BlueJayRacing/22xt_kicad/01-main_board/main_board_peripheral_v3_1/export_3d/main_board_peripheral_v3_1.step

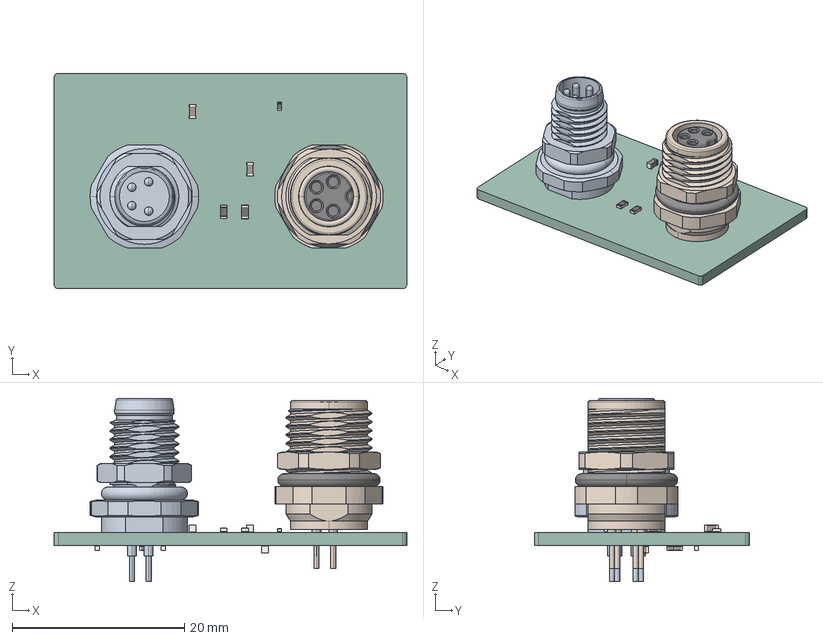
[picture p1: CAD file, 2026-02-27]
01-main_board/main_board_peripheral_v3_1/export_3d/main_board_peripheral_v3_1.step
41.0 x 25.0 x 21.3 mm
c-t4040014041-000-a-3d
R_0402_1005Metric
C_0603_1608Metric x 3
R_0603_1608Metric x 2
T4041017041-000
C_0402_1005Metric x 3
main_board_peripheral_v3_PCB
