BlueJayRacing/22xt_kicad/01-main_board/00-3dmodels/MYRBP500080W21RD.step

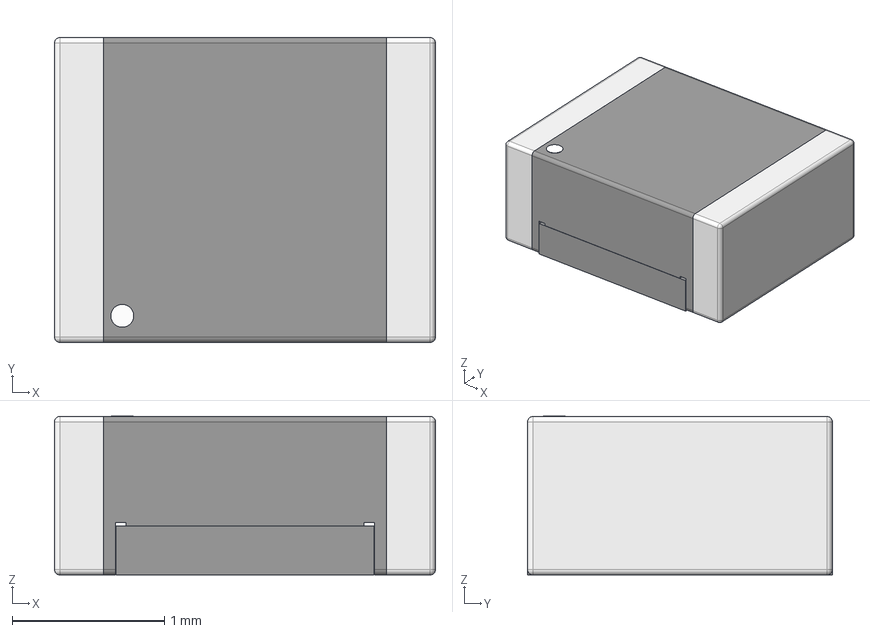
[picture p2: CAD file, 2026-03-13]
01-main_board/00-3dmodels/MYRBP500080W21RD.step
2.50 x 2.00 x 1.04 mm
substrate terminal
substrate
inductor terminal
inductor body
marking
