BlueJayRacing/22xt_kicad/02-wsg/00-footprints/USBLC6-2SC6.step

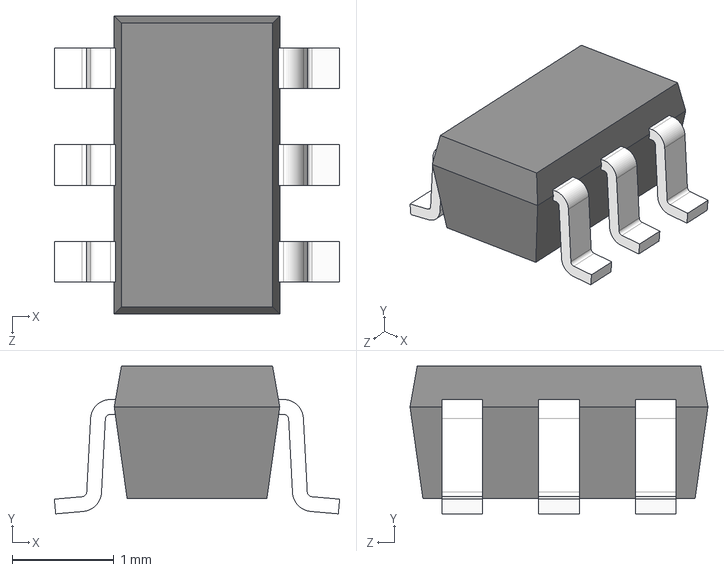
[picture p3: CAD file, 2025-12-18]
02-wsg/00-footprints/USBLC6-2SC6.step
2.80 x 1.45 x 2.92 mm
