BlueJayRacing/22xt_kicad/02-wsg/wsg_2025/symbols/ADC/ADS1120IPWR/ADS1120IPWR.step

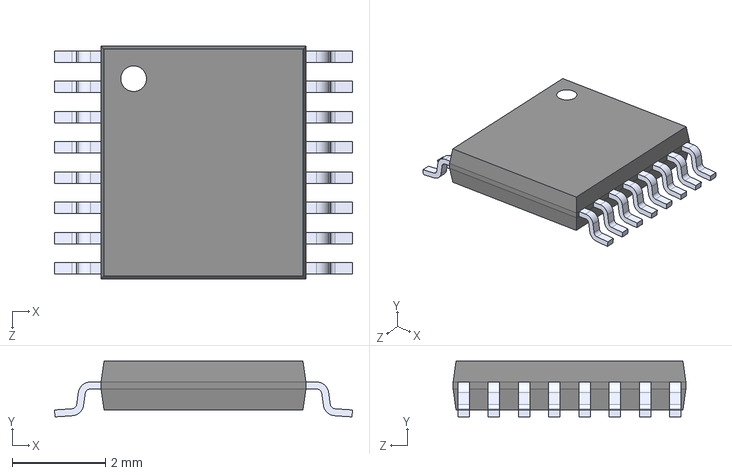
[picture p4: CAD file, 2025-12-19]
02-wsg/wsg_2025/symbols/ADC/ADS1120IPWR/ADS1120IPWR.step
6.40 x 1.20 x 5.00 mm
