BlueJayRacing/22xt_kicad/02-wsg/wsg_2025/symbols/battery module/PW0014A.stl

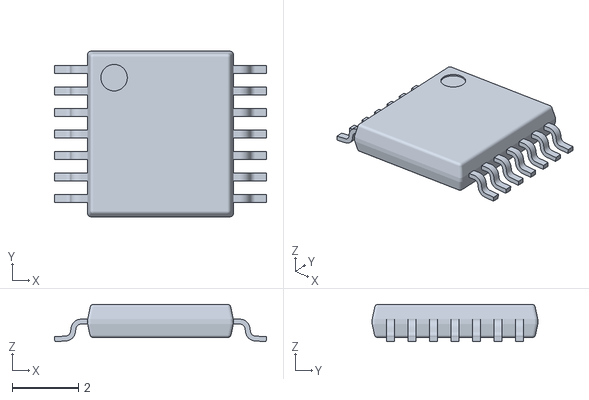
[picture p5: CAD file, 2025-12-18]
02-wsg/wsg_2025/symbols/battery module/PW0014A.stl
6.40 x 5.00 x 1.13
