BlueJayRacing/22xt_kicad/02-wsg/wsg_2025/symbols/DAC/RM_8_ADI.stl

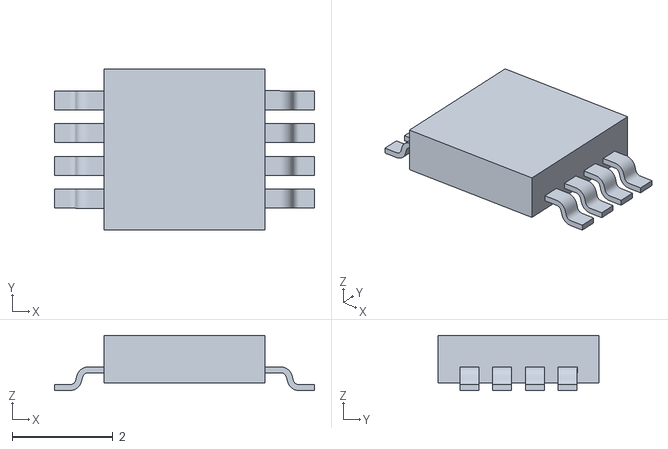
[picture p6: CAD file, 2025-12-18]
02-wsg/wsg_2025/symbols/DAC/RM_8_ADI.stl
5.16 x 3.20 x 1.10
