BlueJayRacing/22xt_kicad/02-wsg/wsg_2025/symbols/ESP32-C6/ESP32-C6.step

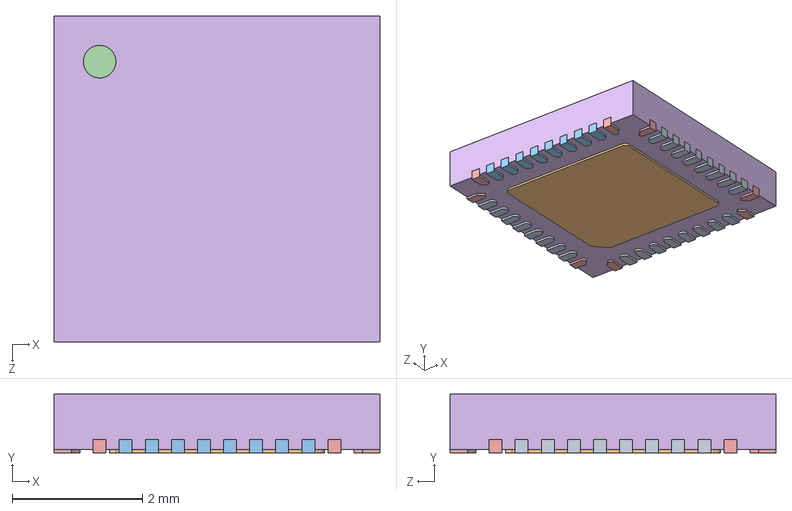
[picture p7: CAD file, 2025-12-18]
02-wsg/wsg_2025/symbols/ESP32-C6/ESP32-C6.step
5.00 x 0.9 x 5.00 mm
