BlueJayRacing/22xt_kicad/02-wsg/wsg_2025/symbols/in amp/DGK0008A.stl

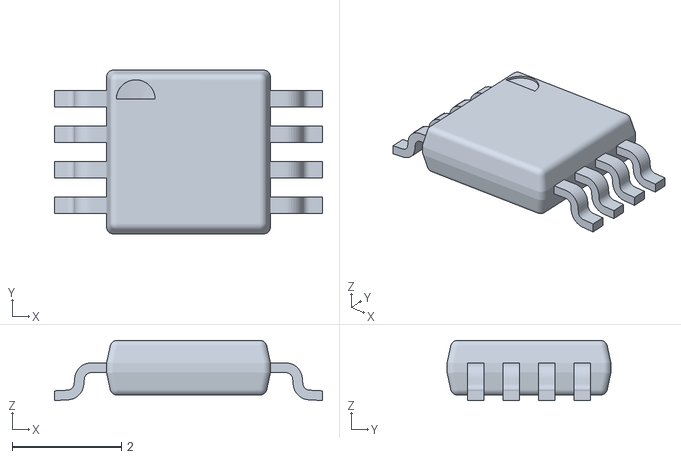
[picture p8: CAD file, 2025-12-18]
02-wsg/wsg_2025/symbols/in amp/DGK0008A.stl
4.90 x 3.00 x 1.10
