BlueJayRacing/22xt_kicad/02-wsg/wsg_2025/symbols/LDO 3.6 V/DBV0005A.stl

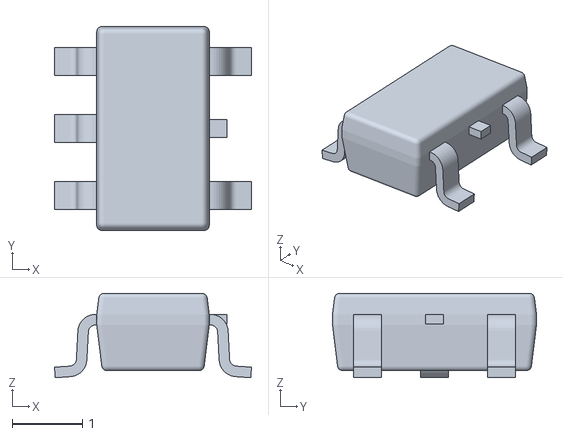
[picture p9: CAD file, 2025-12-18]
02-wsg/wsg_2025/symbols/LDO 3.6 V/DBV0005A.stl
2.80 x 2.90 x 1.20
