BlueJayRacing/22xt_kicad/02-wsg/wsg_2025/symbols/LT6658AHMSE_5_PBF/MSE_16_ADI.stl

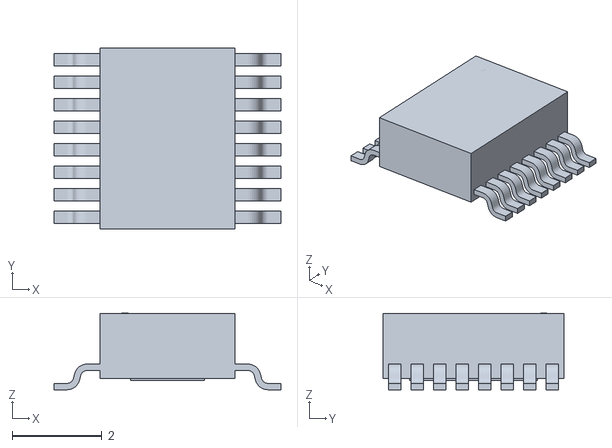
[picture p10: CAD file, 2025-12-18]
02-wsg/wsg_2025/symbols/LT6658AHMSE_5_PBF/MSE_16_ADI.stl
5.05 x 4.04 x 1.70
