BlueJayRacing/22xt_kicad/02-wsg/wsg_2025/symbols/voltage ref/F36-65.step

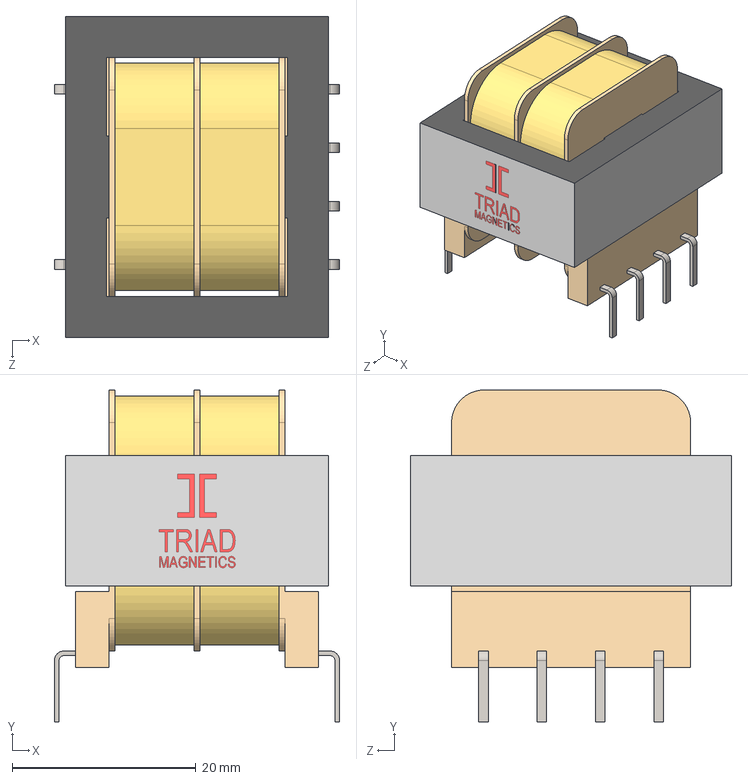
[picture p11: CAD file, 2025-12-18]
02-wsg/wsg_2025/symbols/voltage ref/F36-65.step
31.0 x 36.1 x 35.0 mm
