BlueJayRacing/22xt_kicad/04-dyno_daq/00-3dmodels/B2B-PH-SM4-TB.STEP

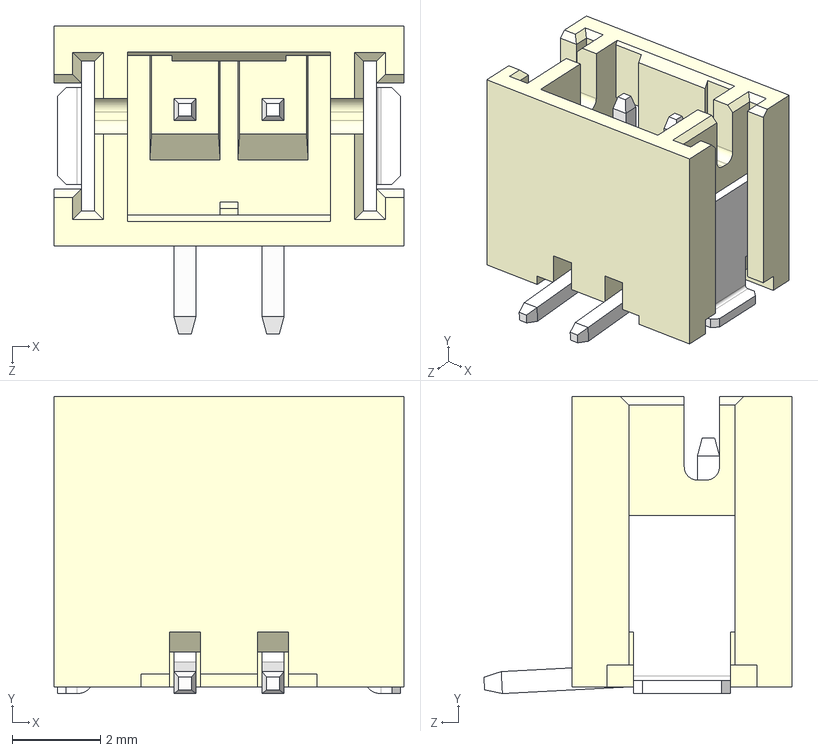
[picture p12: CAD file, 2025-11-25]
04-dyno_daq/00-3dmodels/B2B-PH-SM4-TB.STEP
7.95 x 6.75 x 7.00 mm
