BlueJayRacing/22xt_kicad/04-dyno_daq/TC_kent/jst_2pin.STEP

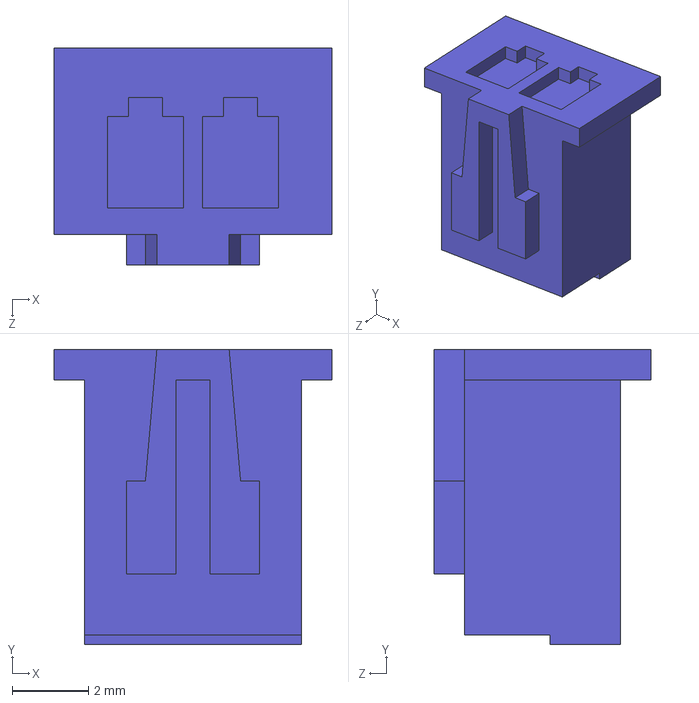
[picture p13: CAD file, 2025-11-25]
04-dyno_daq/TC_kent/jst_2pin.STEP
7.30 x 7.75 x 5.70 mm
