BlueJayRacing/22xt_kicad/04-dyno_daq/TC_kent/jst_4pin/B4B_PH_SM4_TB/B4B-PH-SM4-TB.STEP

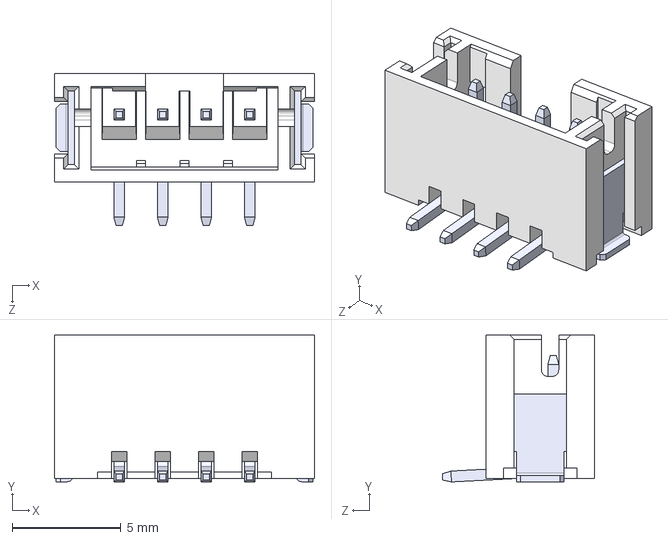
[picture p14: CAD file, 2025-11-25]
04-dyno_daq/TC_kent/jst_4pin/B4B_PH_SM4_TB/B4B-PH-SM4-TB.STEP
12.0 x 6.75 x 7.00 mm
