BlueJayRacing/22xt_kicad/04-dyno_daq/TC_kent/jst_4pin/S4B-XH-SM4-TB.STEP

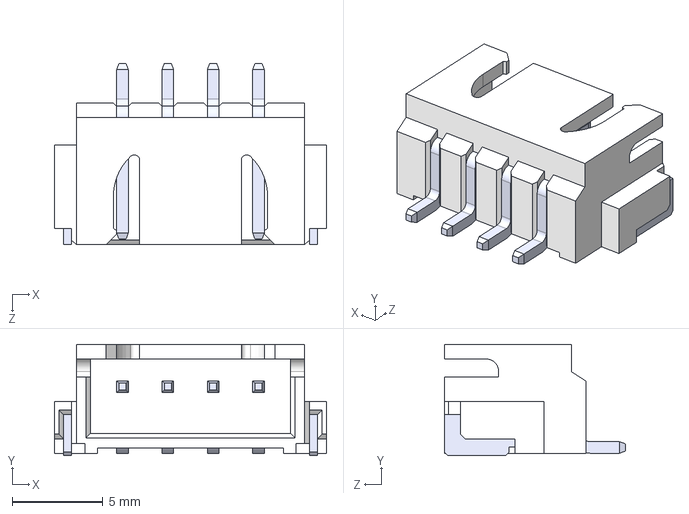
[picture p15: CAD file, 2025-11-25]
04-dyno_daq/TC_kent/jst_4pin/S4B-XH-SM4-TB.STEP
15.0 x 6.12 x 10.0 mm
SxB-XH-SM4-TB_4
pin^SxB-XH-SM4-TB Ass x 4
