BlueJayRacing/22xt_kicad/04-dyno_daq/THC_su/thermistor circuit.step

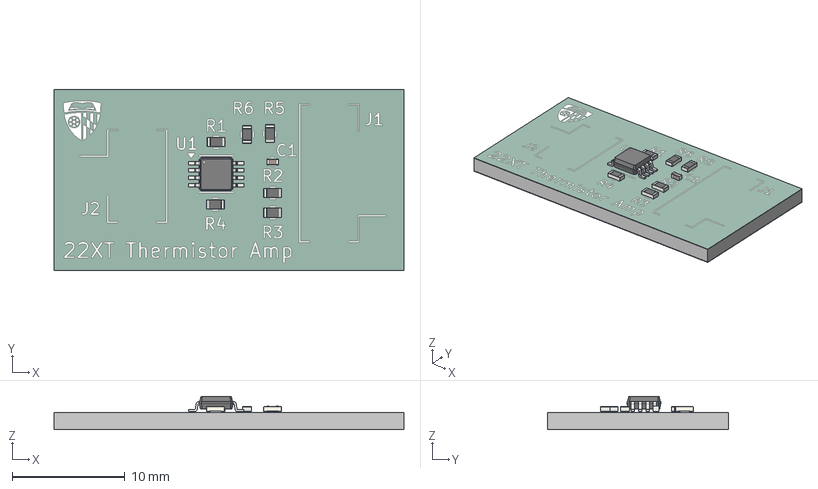
[picture p16: CAD file, 2025-12-20]
04-dyno_daq/THC_su/thermistor circuit.step
31.0 x 16.0 x 3.02 mm
R_0603_1608Metric x 6
VSSOP-8_3x3mm_P0.65mm
C_0402_1005Metric
thermistor circuit_silkscreen
thermistor circuit_soldermask
thermistor circuit_PCB
