BlueJayRacing/22xt_kicad/01-main_board/00-3dmodels/LSM115JE3_TR13--3DModel-STEP-510211.STEP

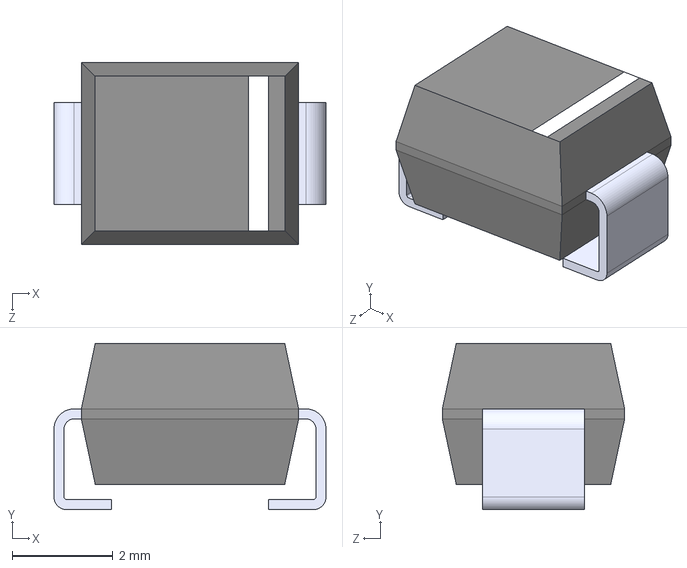
[picture p17: CAD file, 2026-02-10]
01-main_board/00-3dmodels/LSM115JE3_TR13--3DModel-STEP-510211.STEP
5.40 x 3.30 x 3.62 mm
