BlueJayRacing/22xt_kicad/02-wsg/00-3dmodels/usb4110-gf-a.stp

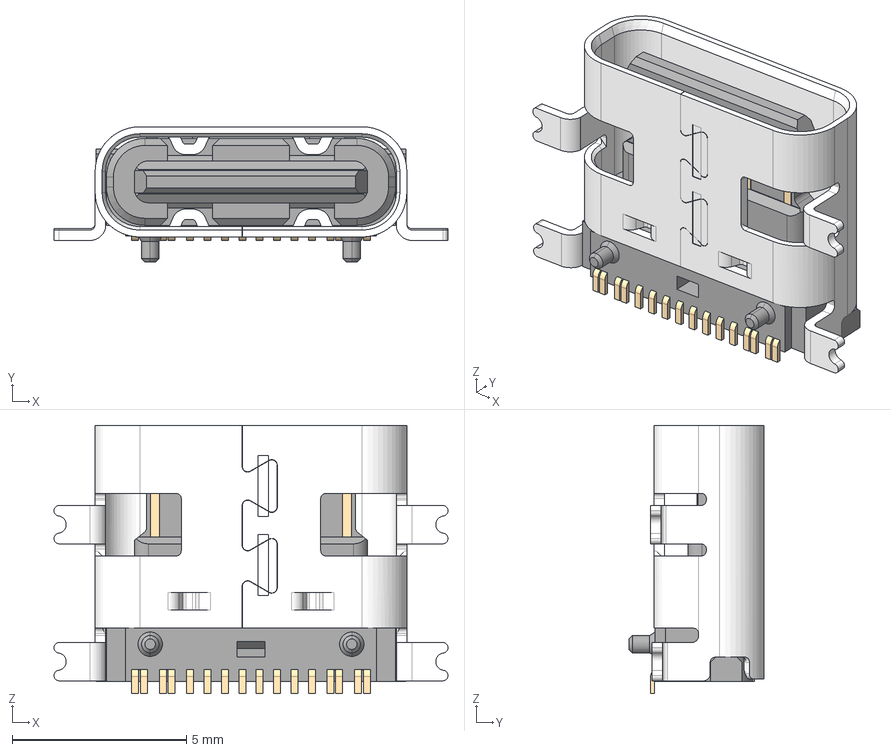
[picture p18: CAD file, 2026-01-05]
02-wsg/00-3dmodels/usb4110-gf-a.stp
11.3 x 3.89 x 7.70 mm
