BlueJayRacing/22xt_kicad/02-wsg/00-3dmodels/2450AT18B100E.step

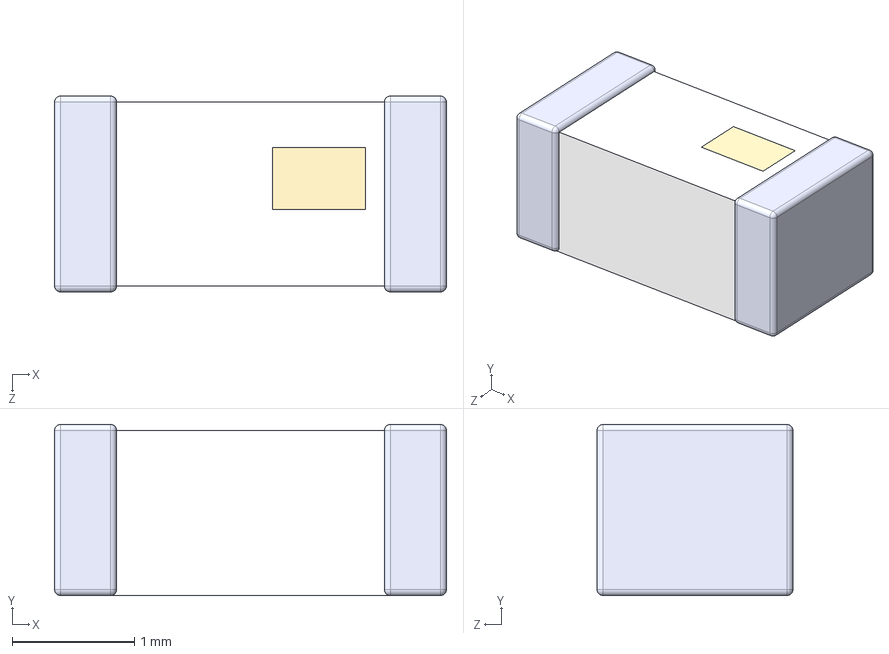
[picture p20: CAD file, 2025-12-18]
02-wsg/00-3dmodels/2450AT18B100E.step
3.20 x 1.40 x 1.60 mm
