BlueJayRacing/22xt_kicad/01-main_board/00-3dmodels/SOIC8-N_MC_MCH.step

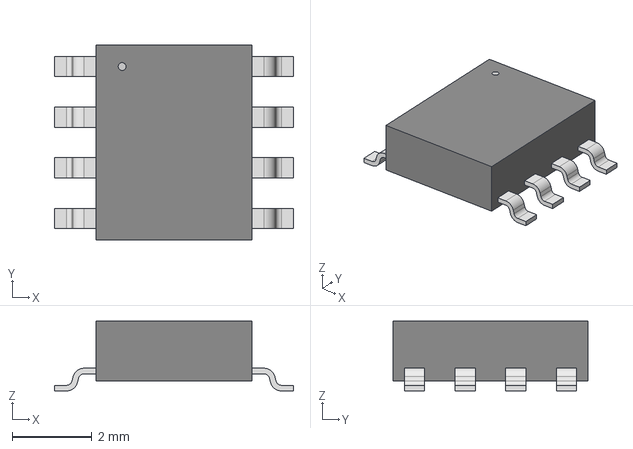
[picture p21: CAD file, 2026-02-10]
01-main_board/00-3dmodels/SOIC8-N_MC_MCH.step
5.99 x 4.90 x 1.75 mm
