BlueJayRacing/22xt_kicad/01-main_board/00-3dmodels/IND_TAIYO_NRS4012_TAY.step

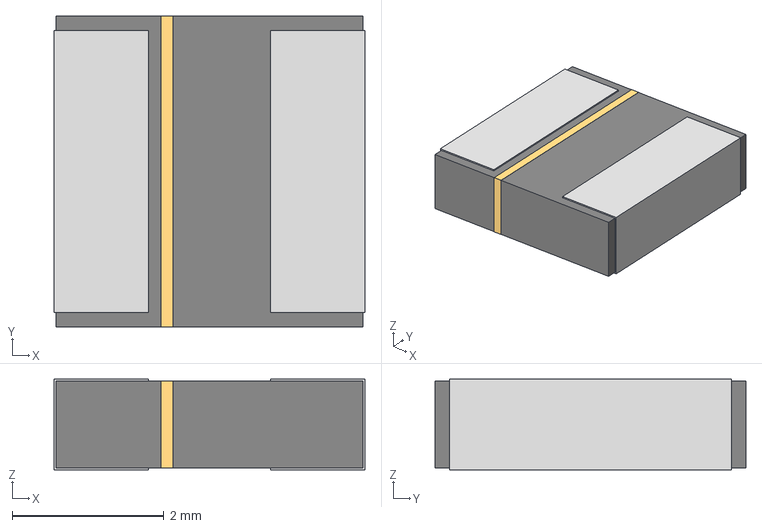
[picture p22: CAD file, 2026-02-10]
01-main_board/00-3dmodels/IND_TAIYO_NRS4012_TAY.step
4.09 x 4.09 x 1.19 mm
