BlueJayRacing/22xt_kicad/02-wsg/00-3dmodels/W25N04KVZEIR.stp

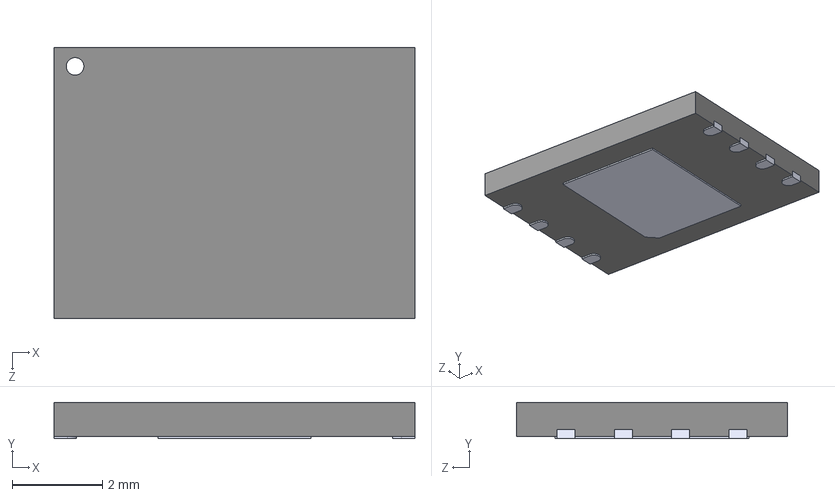
[picture p23: CAD file, 2025-12-18]
02-wsg/00-3dmodels/W25N04KVZEIR.stp
8.00 x 0.8 x 6.00 mm
