BlueJayRacing/22xt_kicad/01-main_board/00-3dmodels/TPSM83100SIUR.stp

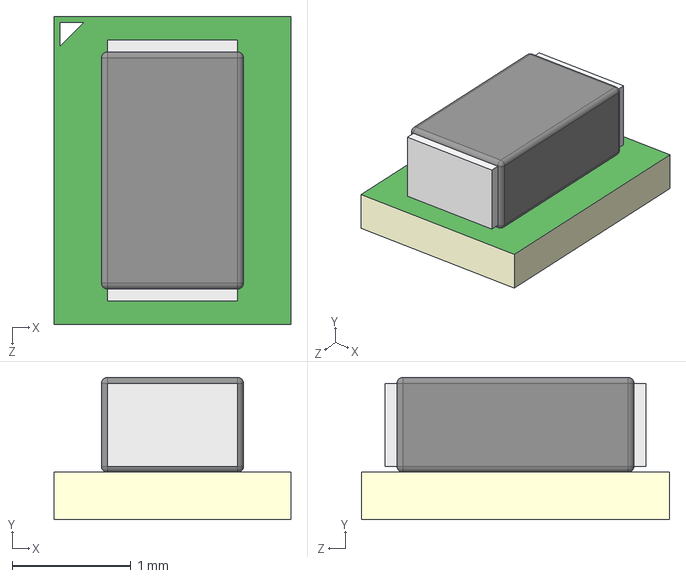
[picture p24: CAD file, 2026-02-09]
01-main_board/00-3dmodels/TPSM83100SIUR.stp
2.00 x 1.20 x 2.60 mm
