BlueJayRacing/22xt_kicad/02-wsg/00-3dmodels/ECS-.327-12.5-34B-TR.step

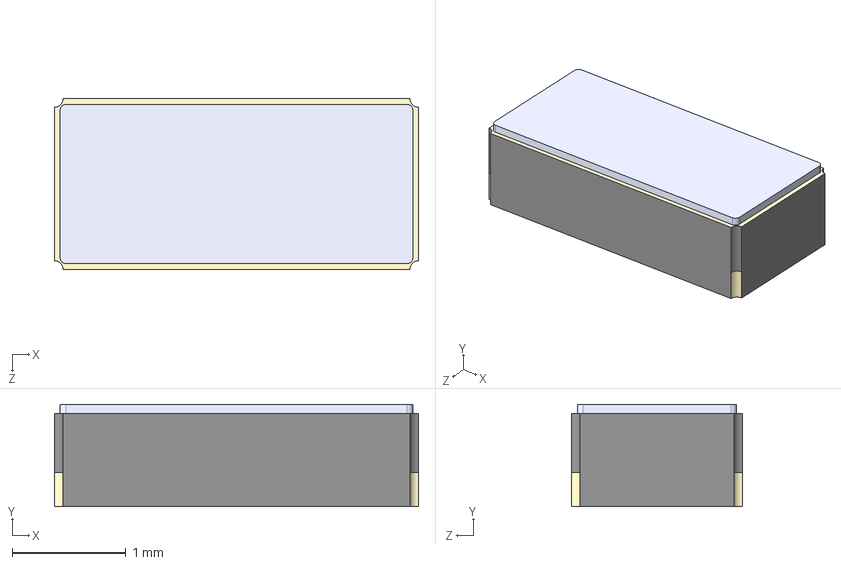
[picture p25: CAD file, 2025-12-18]
02-wsg/00-3dmodels/ECS-.327-12.5-34B-TR.step
3.20 x 0.9 x 1.50 mm
