BlueJayRacing/22xt_kicad/01-main_board/00-3dmodels/RC1206FR-0730KL.step

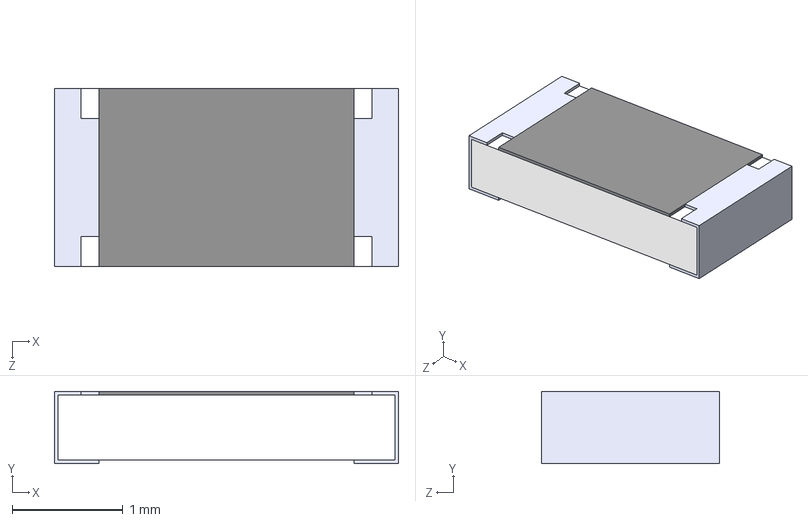
[picture p26: CAD file, 2026-02-09]
01-main_board/00-3dmodels/RC1206FR-0730KL.step
3.10 x 0.65 x 1.60 mm
