BlueJayRacing/22xt_kicad/02-wsg/00-3dmodels/ECS-400-10-37B2-CKY-TR.step

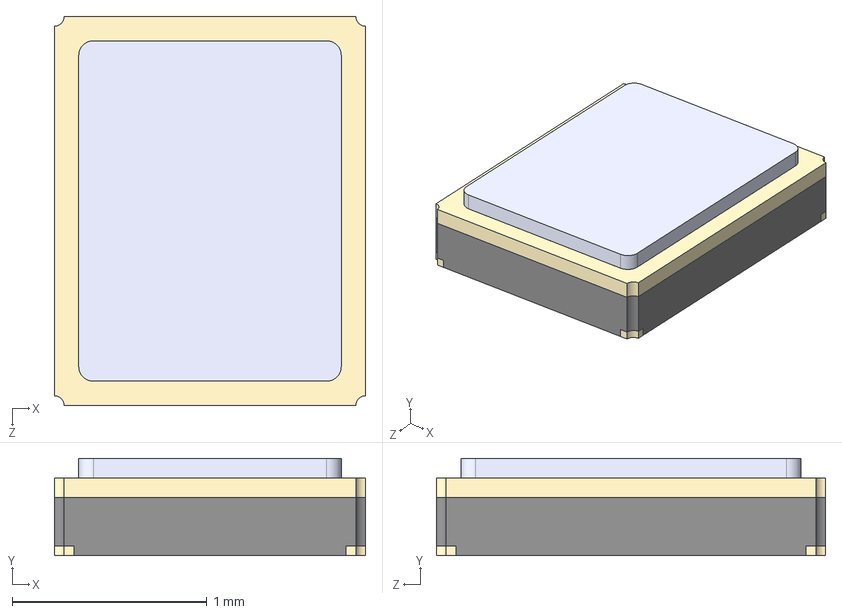
[picture p27: CAD file, 2025-12-18]
02-wsg/00-3dmodels/ECS-400-10-37B2-CKY-TR.step
1.60 x 0.5 x 2.00 mm
