BlueJayRacing/22xt_kicad/01-main_board/00-3dmodels/FH41-15S-0.5SH_05_.stp

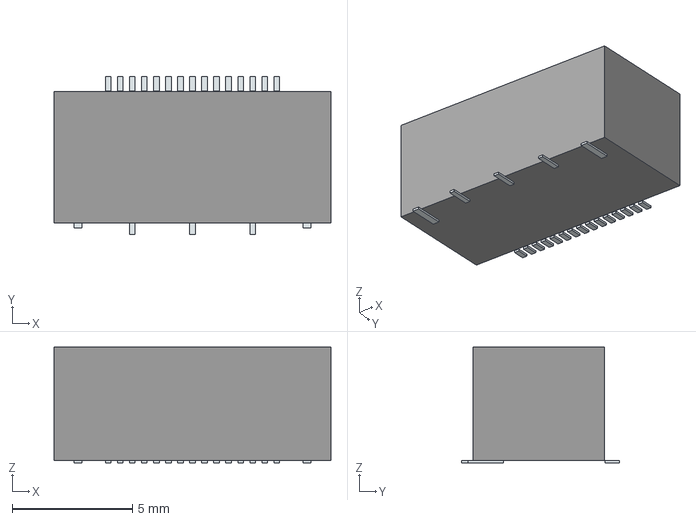
[picture p28: CAD file, 2026-02-09]
01-main_board/00-3dmodels/FH41-15S-0.5SH_05_.stp
11.5 x 6.54 x 4.80 mm
Pins
