BlueJayRacing/22xt_kicad/01-main_board/00-3dmodels/DF12NB(5.0)-20DP-0.5V(51).STEP

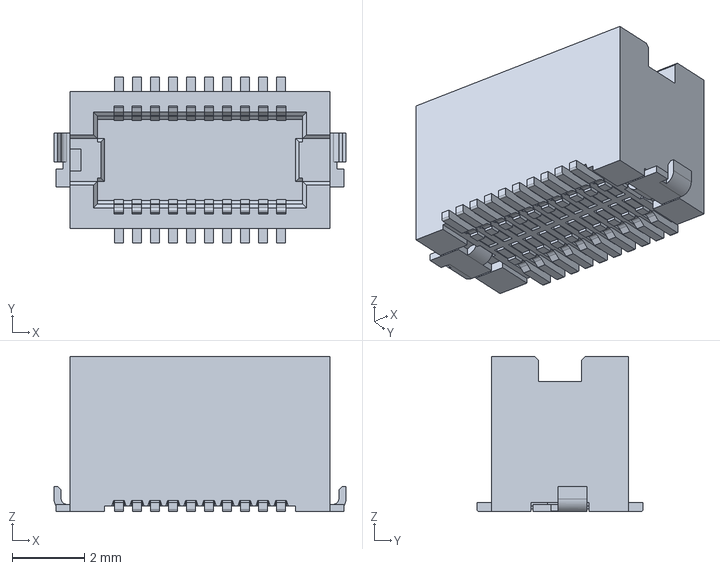
[picture p29: CAD file, 2026-01-04]
01-main_board/00-3dmodels/DF12NB(5.0)-20DP-0.5V(51).STEP
8.10 x 4.60 x 4.30 mm
