BlueJayRacing/22xt_kicad/01-main_board/00-3dmodels/DF12NB-20DS-0.5V.stp

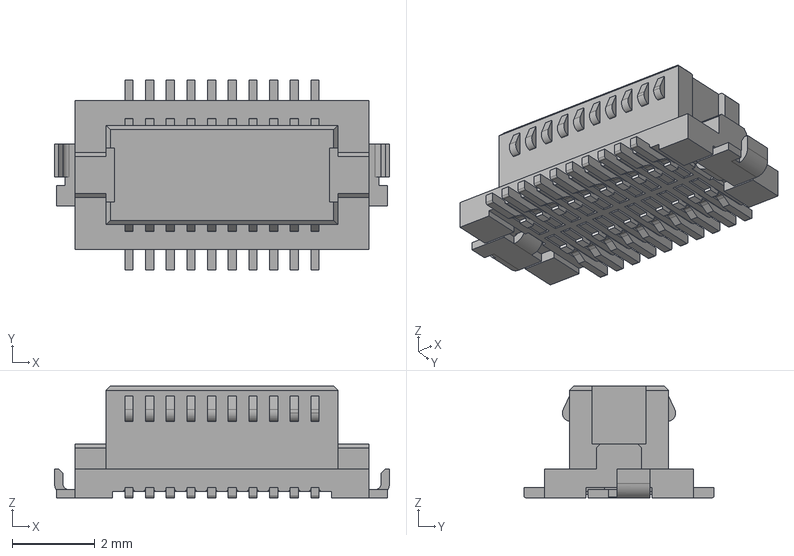
[picture p30: CAD file, 2026-01-04]
01-main_board/00-3dmodels/DF12NB-20DS-0.5V.stp
8.10 x 4.60 x 2.70 mm
