BlueJayRacing/22xt_kicad/01-main_board/00-3dmodels/TS3USB30EDGSR.stp

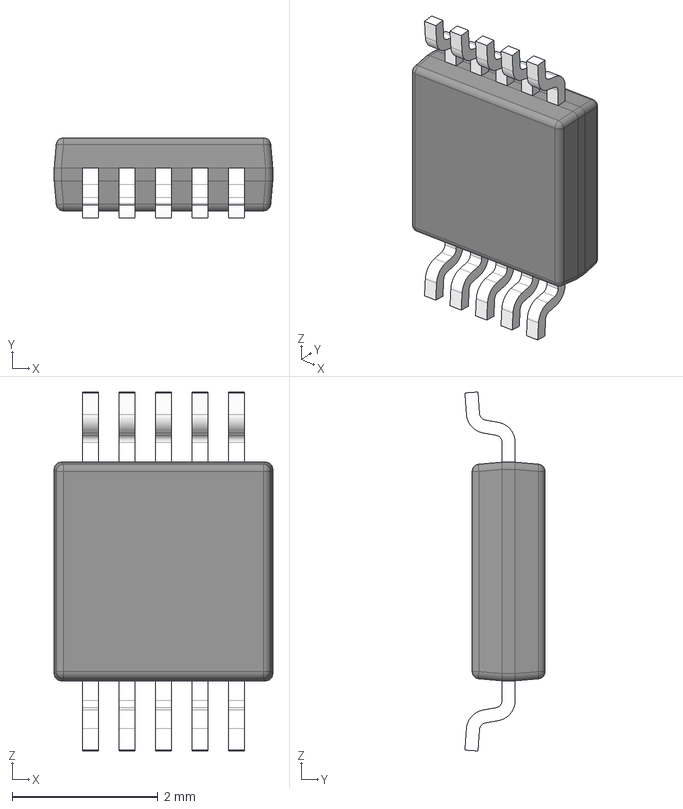
[picture p31: CAD file, 2026-01-04]
01-main_board/00-3dmodels/TS3USB30EDGSR.stp
3.00 x 1.10 x 4.93 mm
BODY-SO
LEAD-SO x 10
PIN1-ID
