BlueJayRacing/22xt_kicad/01-main_board/00-3dmodels/NL37WZ14USG.step

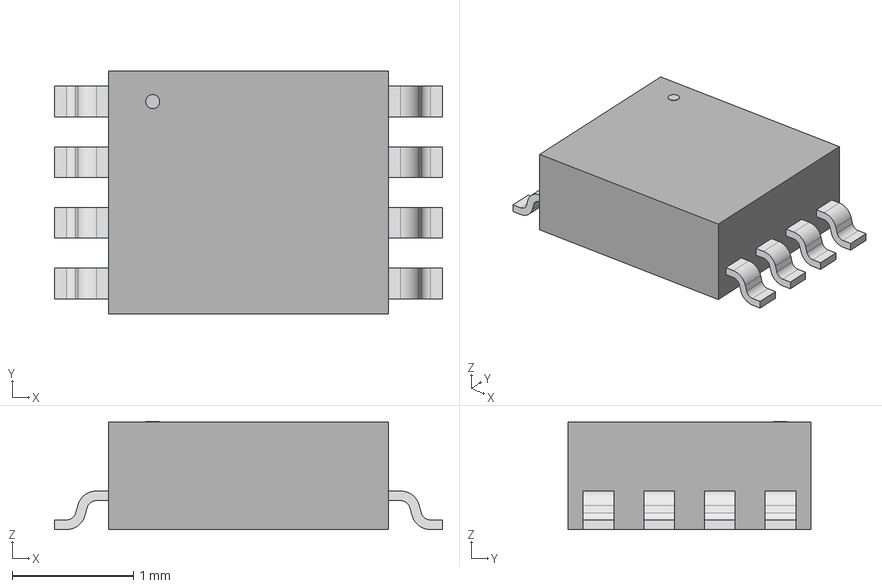
[picture p32: CAD file, 2026-01-04]
01-main_board/00-3dmodels/NL37WZ14USG.step
3.20 x 2.01 x 0.892 mm
