BlueJayRacing/22xt_kicad/01-main_board/00-3dmodels/DF12NB-20DS-0.5V_51_combined.stp

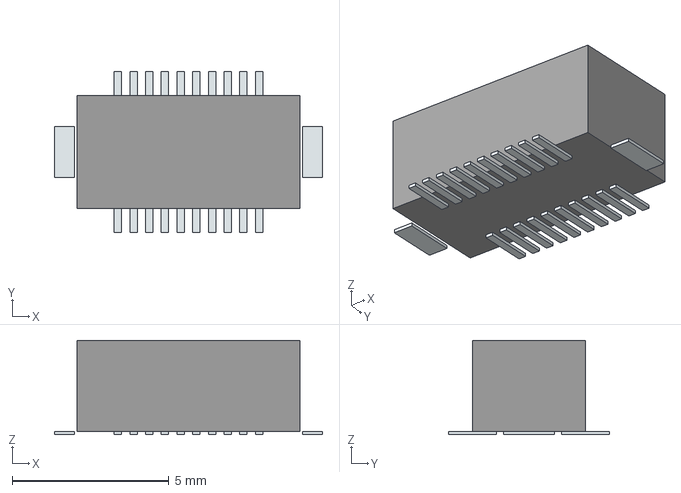
[picture p33: CAD file, 2026-01-04]
01-main_board/00-3dmodels/DF12NB-20DS-0.5V_51_combined.stp
8.54 x 5.14 x 3.00 mm
Pins
