BlueJayRacing/22xt_kicad/01-main_board/00-3dmodels/NEOPIXEL5050-COM-24837.stp

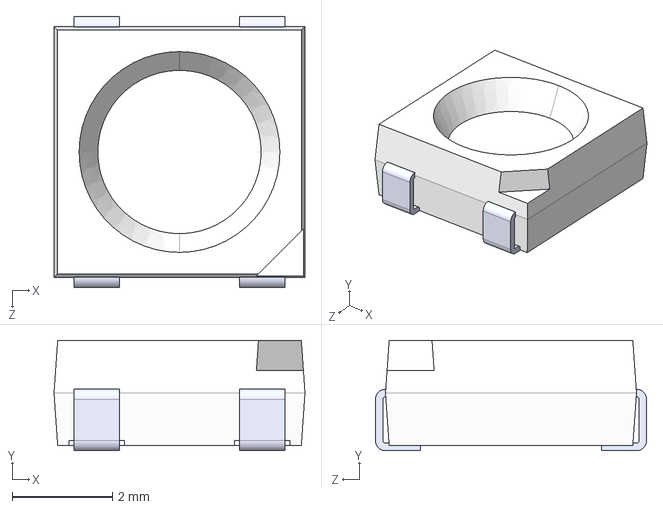
[picture p34: CAD file, 2026-01-04]
01-main_board/00-3dmodels/NEOPIXEL5050-COM-24837.stp
5.00 x 2.20 x 5.40 mm
