BlueJayRacing/22xt_kicad/01-main_board/00-3dmodels/KSC253J_SP_DELTA_LFG.stp

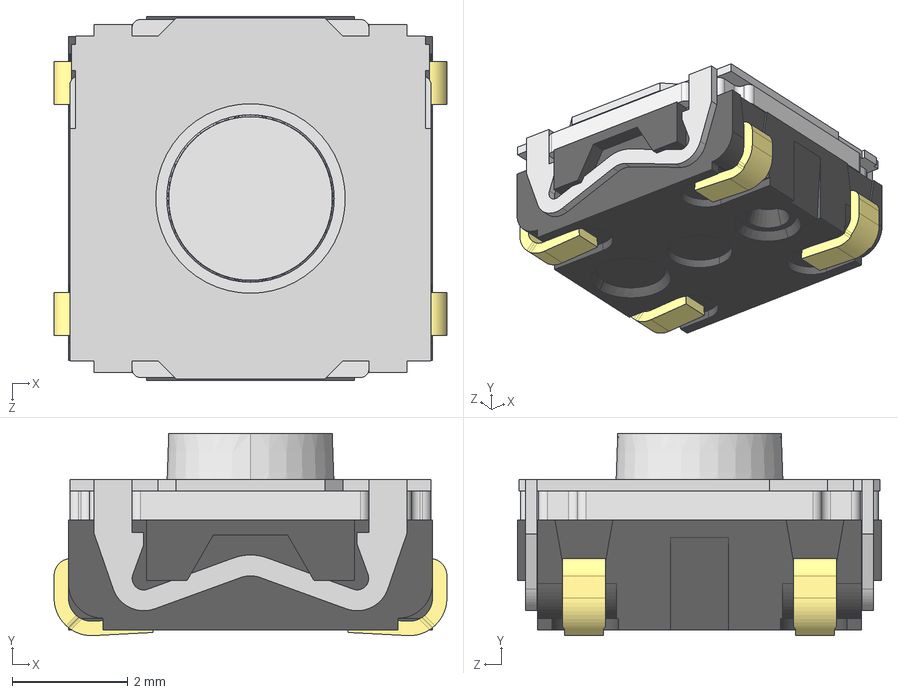
[picture p35: CAD file, 2026-01-04]
01-main_board/00-3dmodels/KSC253J_SP_DELTA_LFG.stp
6.80 x 3.50 x 6.30 mm
KSC2 - body
KSC2 - button
KSC2 - cover
KSC23J_pin x 4
