BlueJayRacing/22xt_kicad/01-main_board/00-3dmodels/REF3450IDBVR.stp

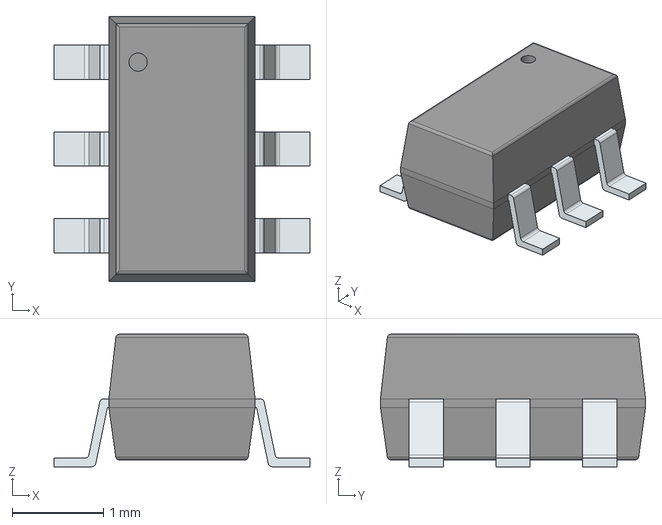
[picture p36: CAD file, 2026-01-04]
01-main_board/00-3dmodels/REF3450IDBVR.stp
2.80 x 2.90 x 1.45 mm
PinsArrayLR
