BlueJayRacing/22xt_kicad/01-main_board/00-3dmodels/LT3973EMSE-5#PBF.stp

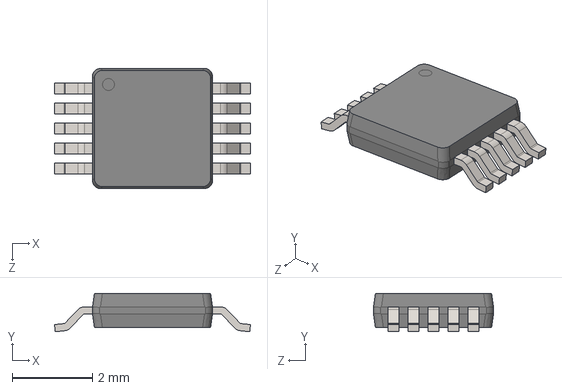
[picture p37: CAD file, 2026-01-04]
01-main_board/00-3dmodels/LT3973EMSE-5#PBF.stp
4.90 x 0.962 x 3.00 mm
