BlueJayRacing/22xt_kicad/01-main_board/00-3dmodels/c-2311770-1-b-femaleDB44.stp

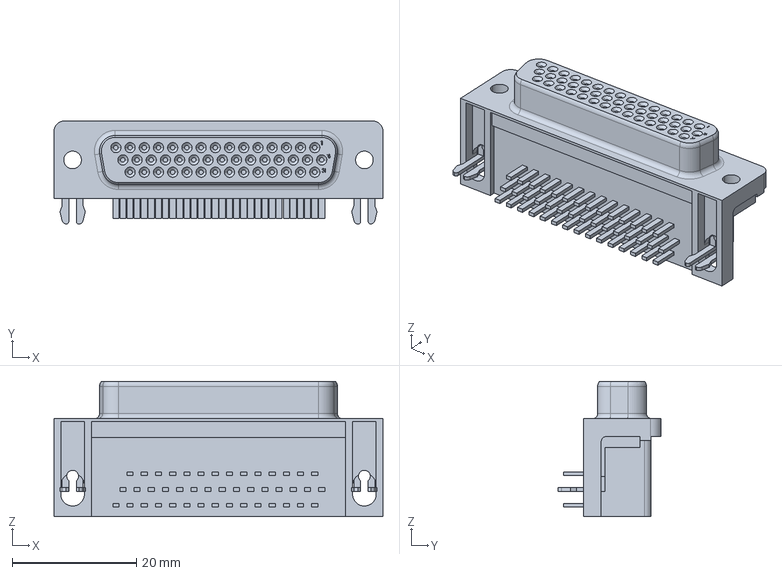
[picture p38: CAD file, 2025-12-22]
01-main_board/00-3dmodels/c-2311770-1-b-femaleDB44.stp
53.0 x 16.6 x 21.8 mm
