BlueJayRacing/22xt_kicad/01-main_board/00-3dmodels/mezzanine.stp

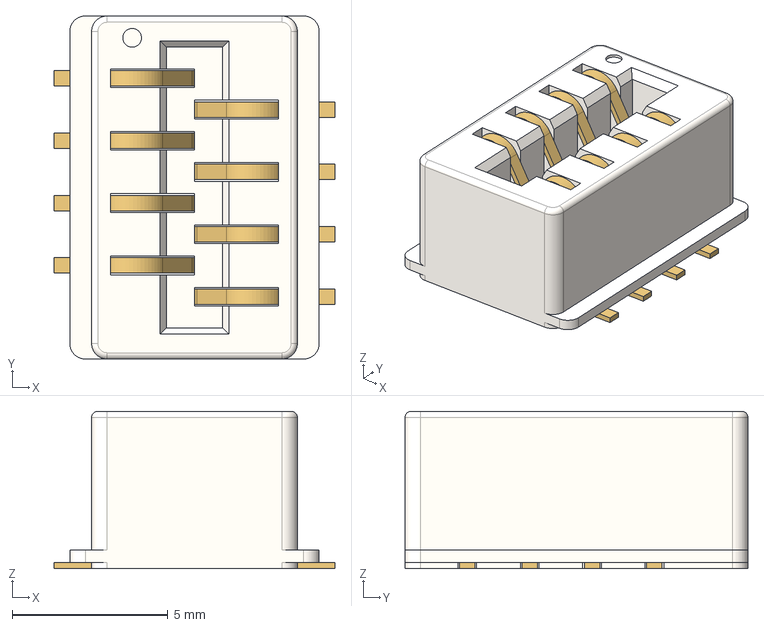
[picture p39: CAD file, 2025-10-29]
01-main_board/00-3dmodels/mezzanine.stp
9.00 x 11.0 x 5.05 mm
housing
pins
