BlueJayRacing/22xt_kicad/01-main_board/00-3dmodels/mezzanine 10.stp

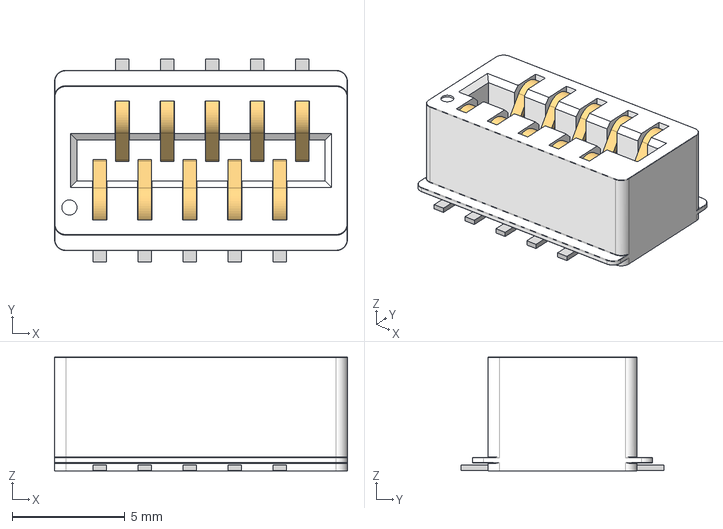
[picture p40: CAD file, 2025-10-29]
01-main_board/00-3dmodels/mezzanine 10.stp
13.0 x 9.00 x 5.05 mm
