BlueJayRacing/22xt_kicad/01-main_board/00-3dmodels/c-t4040014041-000-a-3d.stp

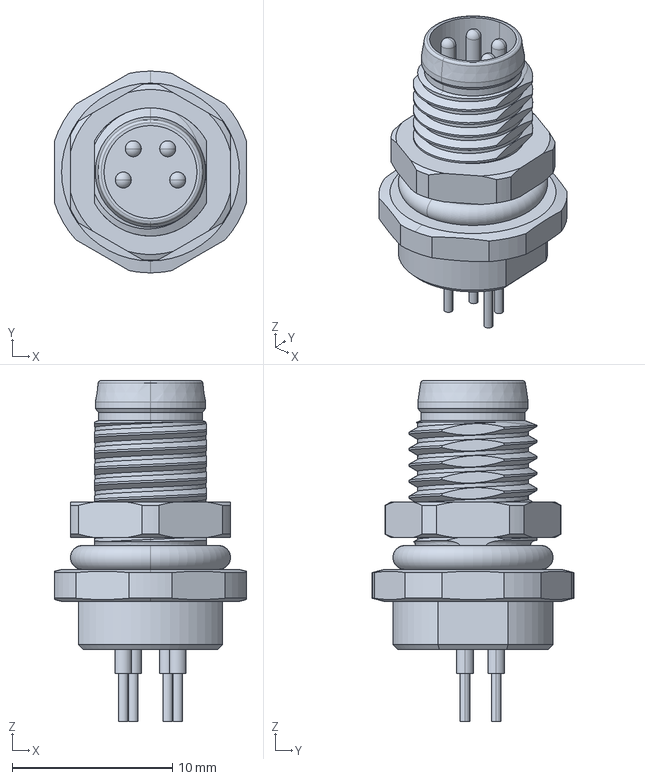
[picture p41: CAD file, 2025-10-29]
01-main_board/00-3dmodels/c-t4040014041-000-a-3d.stp
12.0 x 12.6 x 21.3 mm
