BlueJayRacing/22xt_kicad/01-main_board/00-3dmodels/781-M44-113R141.STEP

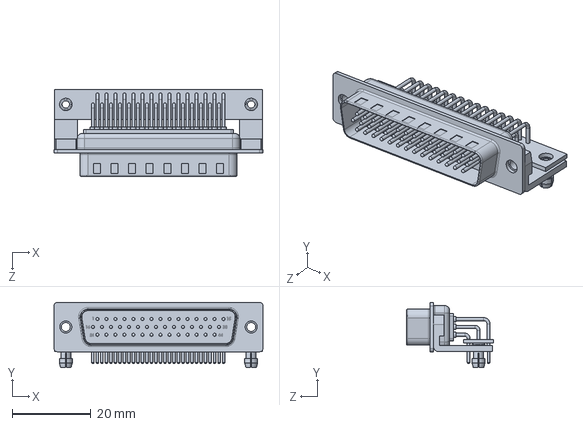
[picture p42: CAD file, 2025-10-18]
01-main_board/00-3dmodels/781-M44-113R141.STEP
53.0 x 16.6 x 22.1 mm
