BlueJayRacing/22xt_kicad/01-main_board/00-3dmodels/TPS2115APWR.STEP

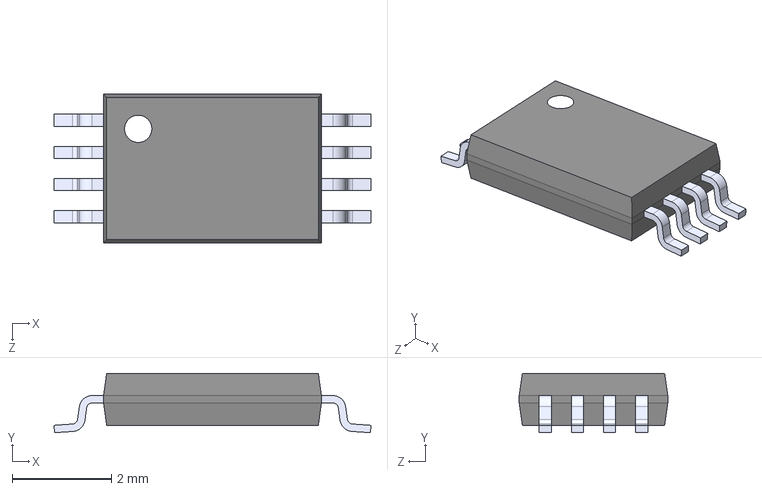
[picture p43: CAD file, 2025-10-06]
01-main_board/00-3dmodels/TPS2115APWR.STEP
6.40 x 1.20 x 3.00 mm
