BlueJayRacing/22xt_kicad/01-main_board/00-3dmodels/MAX6105EUR-T.step

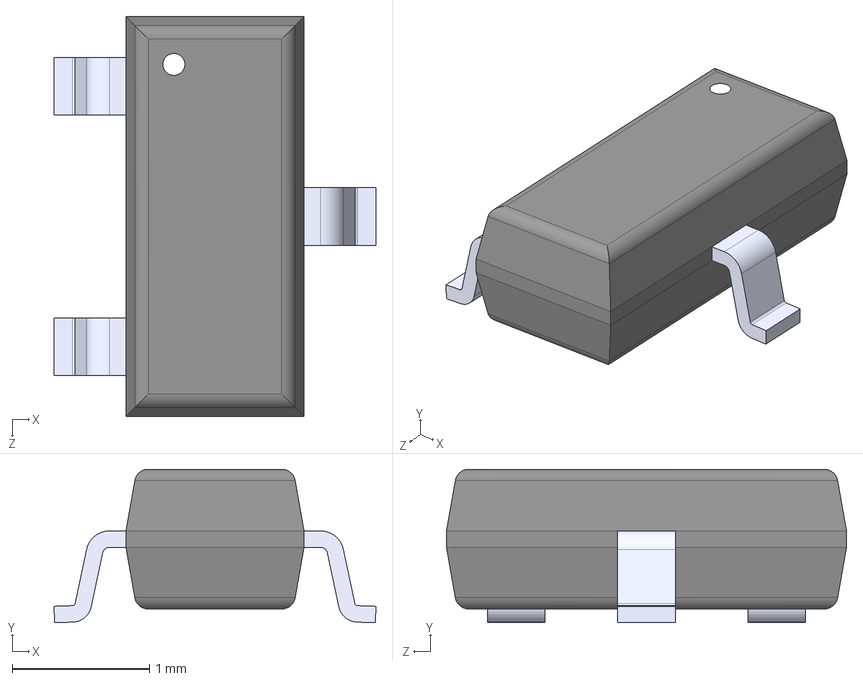
[picture p44: CAD file, 2025-10-06]
01-main_board/00-3dmodels/MAX6105EUR-T.step
2.35 x 1.12 x 2.92 mm
