BlueJayRacing/22xt_kicad/01-main_board/00-3dmodels/RU_16_ADI.step

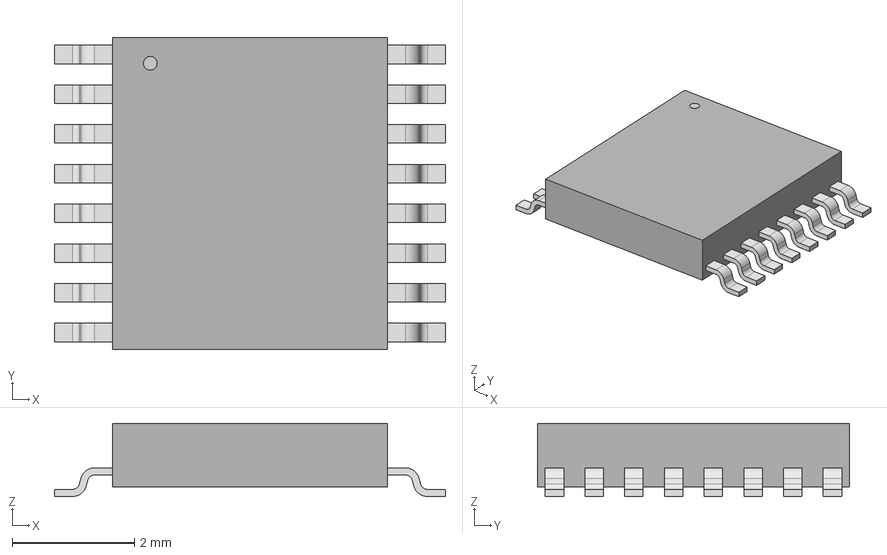
[picture p45: CAD file, 2025-10-06]
01-main_board/00-3dmodels/RU_16_ADI.step
6.40 x 5.11 x 1.20 mm
