BlueJayRacing/22xt_kicad/01-main_board/00-3dmodels/LSF0108PWR.STEP

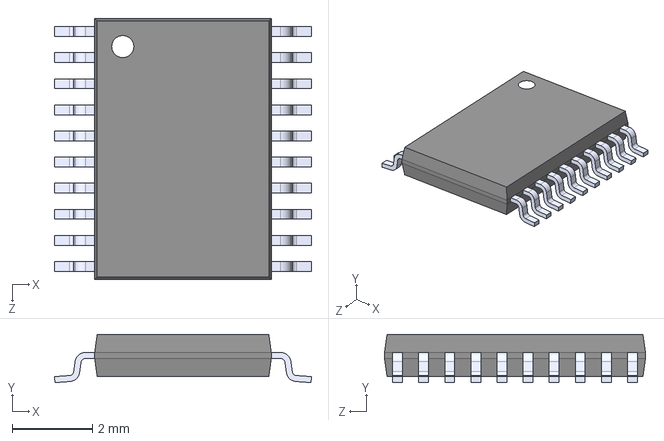
[picture p46: CAD file, 2025-10-06]
01-main_board/00-3dmodels/LSF0108PWR.STEP
6.40 x 1.20 x 6.50 mm
