BlueJayRacing/22xt_kicad/01-main_board/00-3dmodels/LP5907MFX-2.5_NOPB.step

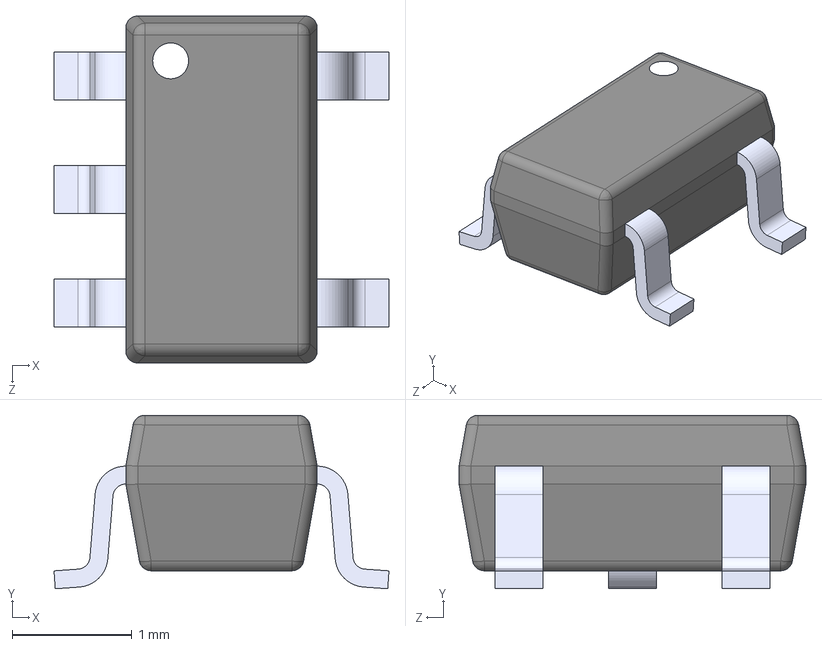
[picture p47: CAD file, 2025-10-06]
01-main_board/00-3dmodels/LP5907MFX-2.5_NOPB.step
2.80 x 1.45 x 2.90 mm
