BlueJayRacing/22xt_kicad/01-main_board/00-3dmodels/L78M05ABDT-TR.step

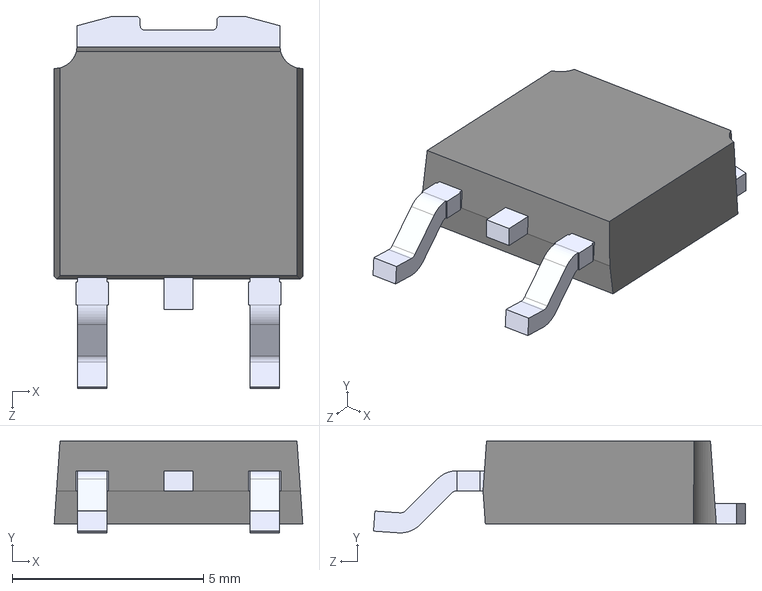
[picture p48: CAD file, 2025-10-06]
01-main_board/00-3dmodels/L78M05ABDT-TR.step
6.50 x 2.40 x 9.72 mm
