BlueJayRacing/22xt_kicad/01-main_board/00-3dmodels/RJ_6_ADI.step

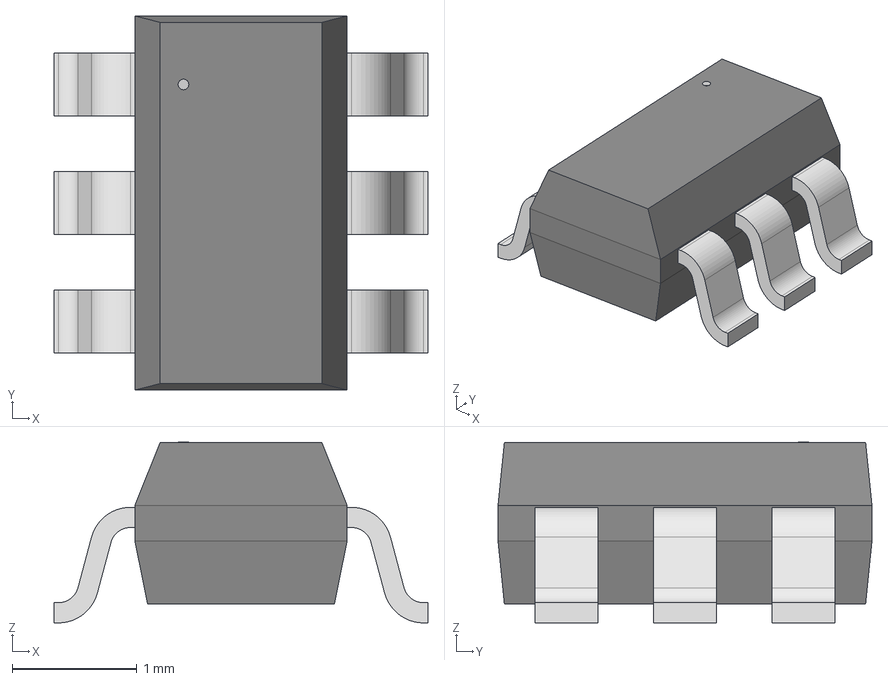
[picture p49: CAD file, 2025-10-06]
01-main_board/00-3dmodels/RJ_6_ADI.step
3.00 x 3.00 x 1.45 mm
