BlueJayRacing/22xt_kicad/01-main_board/00-3dmodels/ESP32-S3--3DModel-STEP-510211.STEP

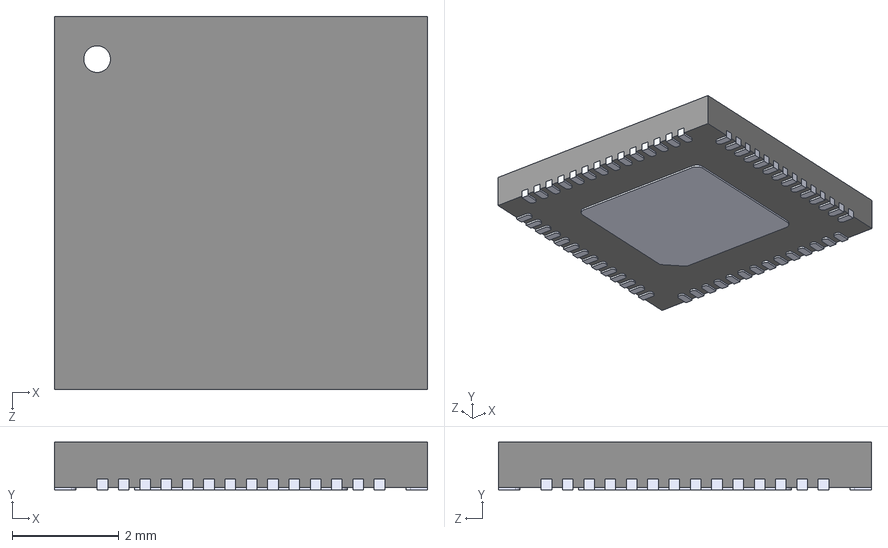
[picture p50: CAD file, 2025-10-06]
01-main_board/00-3dmodels/ESP32-S3--3DModel-STEP-510211.STEP
7.00 x 0.9 x 7.00 mm
