BlueJayRacing/22xt_kicad/01-main_board/00-3dmodels/SOIC127P600X175-8N.step

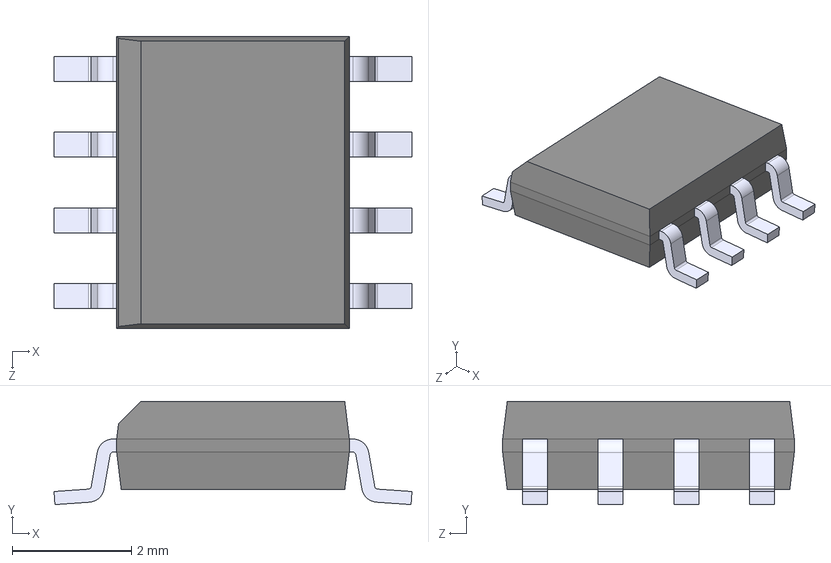
[picture p51: CAD file, 2025-10-06]
01-main_board/00-3dmodels/SOIC127P600X175-8N.step
6.00 x 1.73 x 4.89 mm
