BlueJayRacing/22xt_kicad/01-main_board/00-3dmodels/CP-40-14_ADI.step

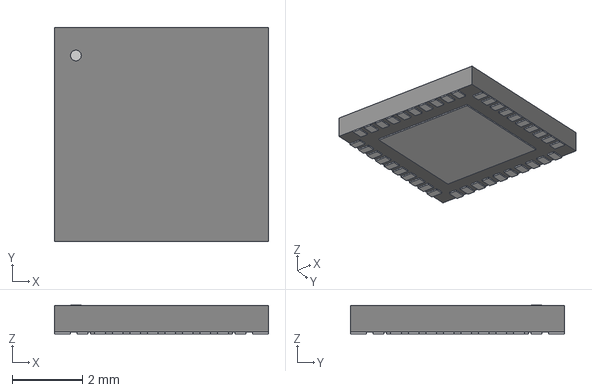
[picture p52: CAD file, 2025-10-06]
01-main_board/00-3dmodels/CP-40-14_ADI.step
6.10 x 6.10 x 0.815 mm
