BlueJayRacing/22xt_kicad/(list of files, cad)

Other CAD files:
04-dyno_daq/00-3dmodels/B4B-PH-SM4-TB.STEP
02-wsg/00-3dmodels/usb4110-gf-a_revb.step
01-main_board/00-3dmodels/INA827AIDGK.step
01-main_board/00-3dmodels/749013011.stp
01-main_board/00-3dmodels/T4041017041-000.stp
01-main_board/00-3dmodels/TPS62173DSGT.stp
02-wsg/00-3dmodels/BQ21040DBVR.stp
02-wsg/wsg_2025/symbols/LDO 5V/TPS71550DCKR.step
02-wsg/wsg_2025/symbols/buck boost/TPS63002DRCR.step
