BlueJayRacing/22xt_kicad/02-wsg/wsg_2025/usb_type-c/USB Type-C/ECNs/ECNs specific to Release 1.2/USB Type-C ECN Adapter Assembly Shielding Effectiveness.pdf

# USB Type-C ENGINEERING CHANGE NOTICE

USB Implementers Forum | Form 20140811-ECN | Page: 1

# Title: Adapter Assembly Shielding Effectiveness Applied to: USB Type-C Cable and Connector Specification Release 1.2, March 25th, 2016

Brief description of the functional changes proposed:
The change proposed to the specification is the addition of a shielding effectiveness requirement for USB Type-C to USB 3.1 Standard-A Receptacle Adapter Assemblies.

Benefits as a result of the proposed changes:
As the result of this change, well designed adaptor assemblies can be differentiated from poorly-designed adaptor assemblies by comparison against the shielding effectiveness specification.

An assessment of the impact to the existing revision and systems that currently conform to the USB specification:
There may be several USB Type-C to USB 3.1 Standard-A Receptacle Adapter Assemblies that have poor cable shielding and do not meet the shielding effectiveness specification.

An analysis of the hardware implications:
N/A

An analysis of the software implications:
N/A

An analysis of the compliance testing implications:
Measurement was done to evaluate the proposed change using compliance test fixture.

# Actual Change Requested

## (a). Section 3.7.6, Page 97 From Figure 3-56

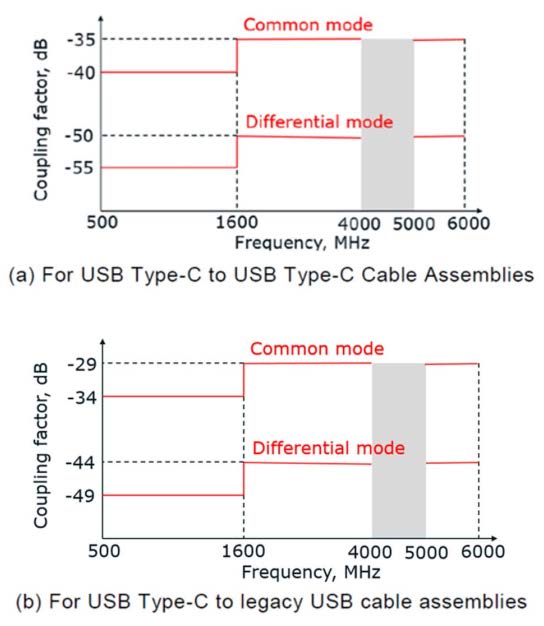
[picture p53: figure]

## To Figure 3-56:

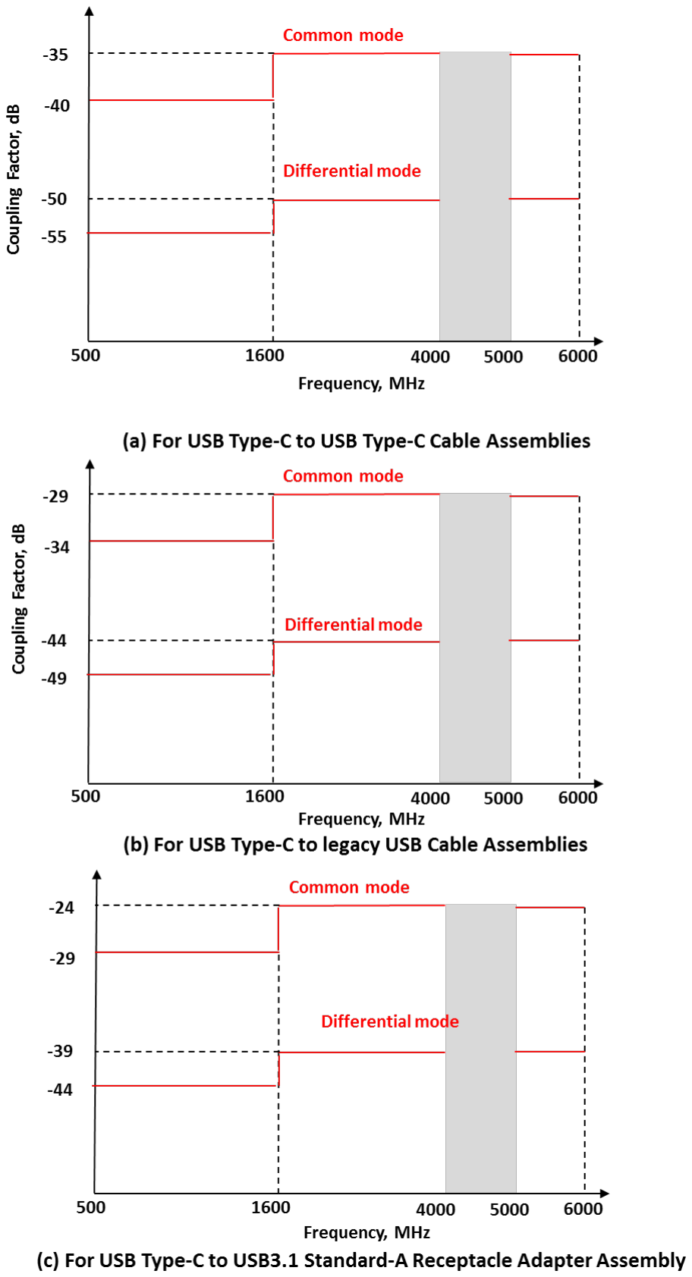
[picture p54: figure]
