BlueJayRacing/22xt_kicad/01-main_board/main_board_v3/main_board_v3.kicad_pcb

## KiCad design 01-main_board/main_board_v3/main_board_v3.kicad_pcb (2026-04-04)

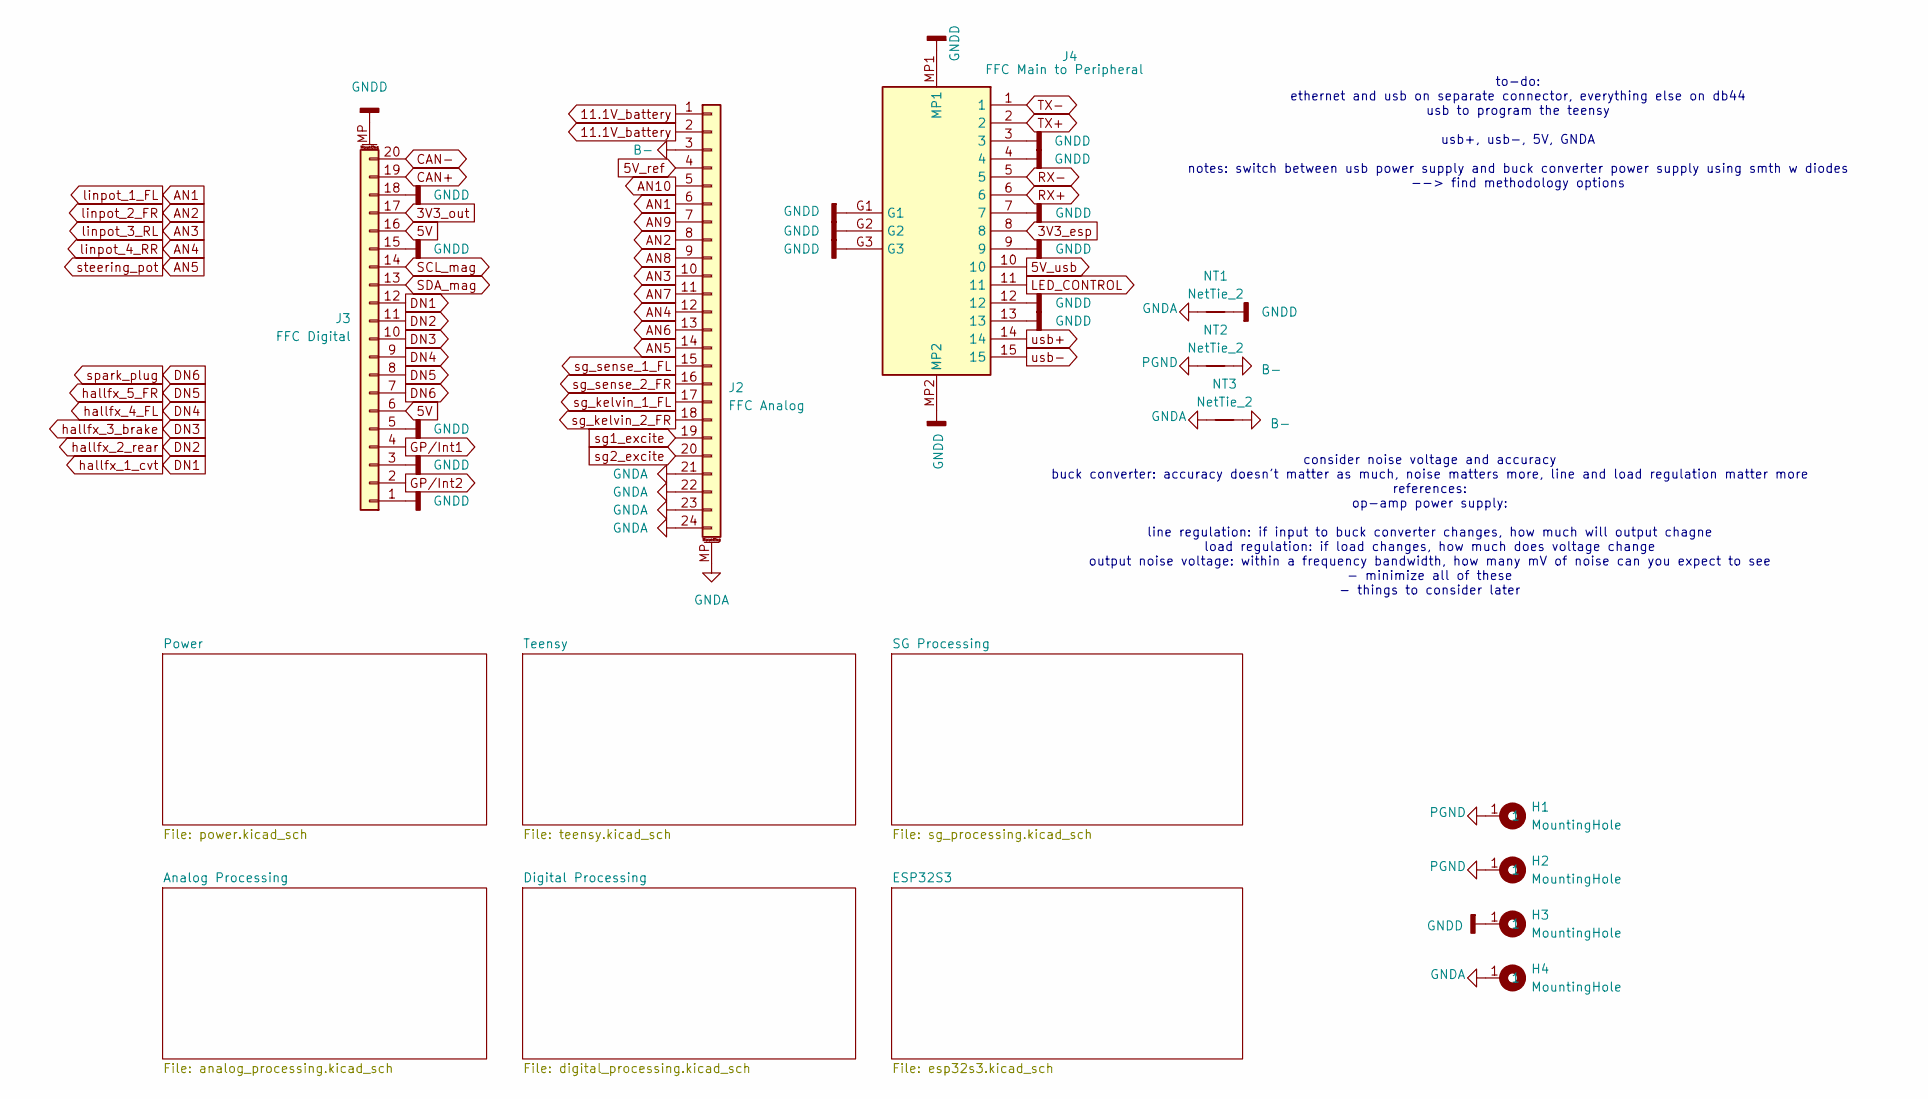
[picture p55: schematic main_board_v3.kicad_sch]

Parts:
H1, H2, H3, H4: MountingHole; MountingHole_2.5mm_Pad
J2: FFC Analog; TE_2-84952-4_1x24-1MP_P1.0mm_Horizontal
J3: FFC Digital; TE_2-84952-0_1x20-1MP_P1.0mm_Horizontal
J4: FFC Main to Peripheral; FH4115S05SH05; Mouser Part Number 798-FH4115S05SH05
NT1, NT2, NT3: NetTie_2; NetTie-2_SMD_Pad0.5mm

Connections:
2V5: J2.19, J2.20; also elsewhere on the board
3V3_esp: J4.8; also elsewhere on the board
3V3_out: J3.17; also elsewhere on the board
5V: J3.6, J3.16; also elsewhere on the board
5V_ref: J2.4; also elsewhere on the board
5V_usb: J4.10; also elsewhere on the board
11.1V_battery: J2.1, J2.2; also elsewhere on the board
AN1: J2.6; also elsewhere on the board
AN2: J2.8; also elsewhere on the board
AN3: J2.10; also elsewhere on the board
AN4: J2.12; also elsewhere on the board
AN5: J2.14; also elsewhere on the board
AN6: J2.13; also elsewhere on the board
AN7: J2.11; also elsewhere on the board
AN8: J2.9; also elsewhere on the board
AN9: J2.7; also elsewhere on the board
AN10: J2.5; also elsewhere on the board
B-: J2.3, NT2.2, NT3.2
CAN+: J3.19; also elsewhere on the board
CAN-: J3.20; also elsewhere on the board
DN1: J3.12; also elsewhere on the board
DN2: J3.11; also elsewhere on the board
DN3: J3.10; also elsewhere on the board
DN4: J3.9; also elsewhere on the board
DN5: J3.8; also elsewhere on the board
DN6: J3.7; also elsewhere on the board
GNDA: H4.1, J2.21, J2.22, J2.23, J2.24, J2.MP (MountPin), NT1.1, NT3.1; also elsewhere on the board
GNDD: H3.1, J3.1, J3.3, J3.5, J3.15, J3.18, J3.MP (MountPin), J4.3, J4.4, J4.7, J4.9, J4.12, J4.13, J4.G1, J4.G2, J4.G3, J4.MP1, J4.MP2, NT1.2; also elsewhere on the board
GP/Int1: J3.4; also elsewhere on the board
GP/Int2: J3.2; also elsewhere on the board
LED_CONTROL: J4.11; also elsewhere on the board
PGND: H1.1, H2.1, NT2.1; also elsewhere on the board
RX+: J4.6; also elsewhere on the board
RX-: J4.5; also elsewhere on the board
SCL_mag: J3.14; also elsewhere on the board
SDA_mag: J3.13; also elsewhere on the board
TX+: J4.2; also elsewhere on the board
TX-: J4.1; also elsewhere on the board
sg1+: J2.17; also elsewhere on the board
sg2+: J2.18; also elsewhere on the board
sg_sense_1_FL: J2.15; also elsewhere on the board
sg_sense_2_FR: J2.16; also elsewhere on the board
usb+: J4.14; also elsewhere on the board
usb-: J4.15; also elsewhere on the board

Notes on the sheet:
consider noise voltage and accuracy buck converter: accuracy doesn't matter as much, noise matters more, line and load regulation matter more references: op-amp power supply: line regulation: if input to buck converter changes, how much will output chagne load regulation: if load changes, how much 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
to-do: ethernet and usb on separate connector, everything else on db44 usb to program the teensy usb+, usb-, 5V, GNDA notes: switch between usb power supply and buck converter power supply using smth w diodes --> find methodology options

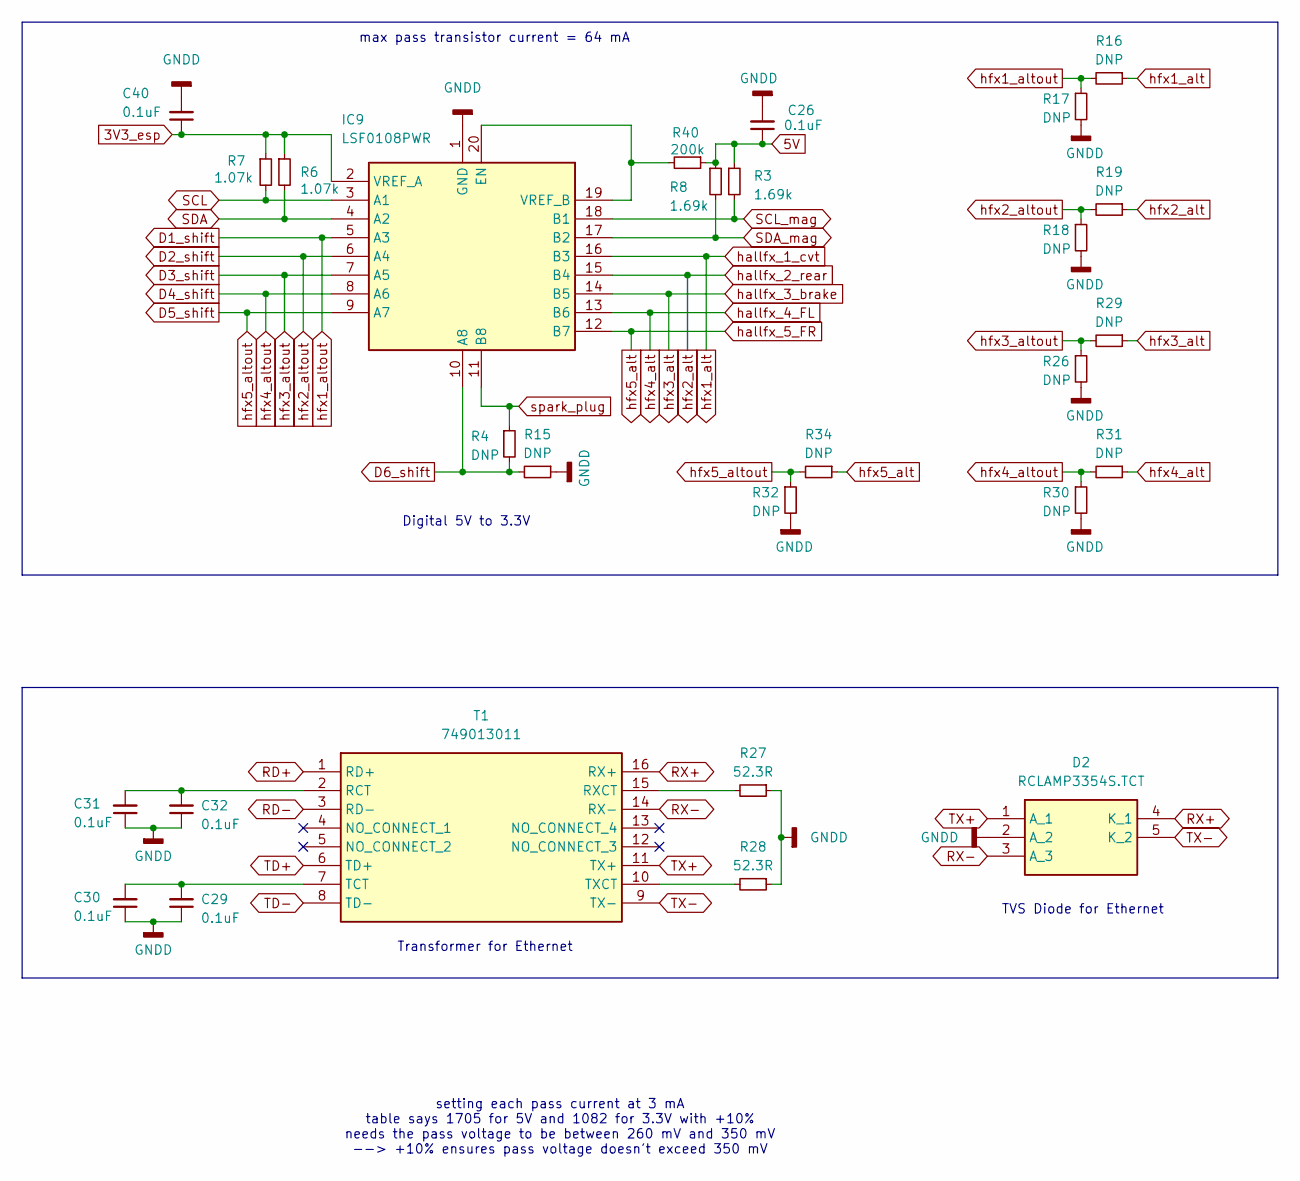
[picture p56: schematic digital_processing.kicad_sch]

Parts:
C26, C29, C30, C31, C32, C40: 0.1uF; C_0402_1005Metric
D2: RCLAMP3354S.TCT; SOT-23-5; Mouser Part Number 947-RCLAMP3354S.TCT
IC9: LSF0108PWR; SOP65P640X120-20N; Mouser Part Number 595-LSF0108RKSR
R3, R8: 1.69k; R_0402_1005Metric
R4, R15, R16, R17, R18, R19, R26, R29, R30, R31, R32, R34: DNP; R_0402_1005Metric
R6, R7: 1.07k; R_0402_1005Metric
R27, R28: 52.3R; R_0402_1005Metric
R40: 200k; R_0402_1005Metric
T1: 749013011; Mouser Part Number 710-749013011

Connections:
3V3_esp: C40.1, IC9.2 (VREF_A), R6.1, R7.1; also elsewhere on the board
5V: C26.1, R3.1, R8.1, R40.1; also elsewhere on the board
D1_shift: IC9.5 (A3), R16.2, R17.1; also elsewhere on the board
D2_shift: IC9.6 (A4), R18.1, R19.2; also elsewhere on the board
D3_shift: IC9.7 (A5), R26.1, R29.2; also elsewhere on the board
D4_shift: IC9.8 (A6), R30.1, R31.2; also elsewhere on the board
D5_shift: IC9.9 (A7), R32.1, R34.2; also elsewhere on the board
D6_shift: IC9.10 (A8), R4.2, R15.2; also elsewhere on the board
DN1: IC9.16 (B3), R16.1; also elsewhere on the board
DN2: IC9.15 (B4), R19.1; also elsewhere on the board
DN3: IC9.14 (B5), R29.1; also elsewhere on the board
DN4: IC9.13 (B6), R31.1; also elsewhere on the board
DN5: IC9.12 (B7), R34.1; also elsewhere on the board
DN6: IC9.11 (B8), R4.1; also elsewhere on the board
GNDD: C26.2, C29.1, C30.1, C31.1, C32.1, C40.2, D2.2 (A_2), IC9.1 (GND), R15.1, R17.2, R18.2, R26.2, R27.1, R28.1, R30.2, R32.2; also elsewhere on the board
unnamed: IC9.19 (VREF_B), IC9.20 (EN), R40.2
unnamed: C31.2, C32.2, T1.2 (RCT)
unnamed: R27.2, T1.15 (RXCT)
unnamed: C29.2, C30.2, T1.7 (TCT)
unnamed: R28.2, T1.10 (TXCT)
RD+: T1.1 (RD+); also elsewhere on the board
RD-: T1.3 (RD-); also elsewhere on the board
RX+: D2.4 (K_1), T1.16 (RX+); also elsewhere on the board
RX-: D2.3 (A_3), T1.14 (RX-); also elsewhere on the board
SCL: IC9.3 (A1), R7.2; also elsewhere on the board
SCL_mag: IC9.18 (B1), R3.2; also elsewhere on the board
SDA: IC9.4 (A2), R6.2; also elsewhere on the board
SDA_mag: IC9.17 (B2), R8.2; also elsewhere on the board
TD+: T1.6 (TD+); also elsewhere on the board
TD-: T1.8 (TD-); also elsewhere on the board
TX+: D2.1 (A_1), T1.11 (TX+); also elsewhere on the board
TX-: D2.5 (K_2), T1.9 (TX-); also elsewhere on the board

Notes on the sheet:
Transformer for Ethernet
max pass transistor current = 64 mA
Digital 5V to 3.3V
TVS Diode for Ethernet
setting each pass current at 3 mA table says 1705 for 5V and 1082 for 3.3V with +10% needs the pass voltage to be between 260 mV and 350 mV --> +10% ensures pass voltage doesn't exceed 350 mV

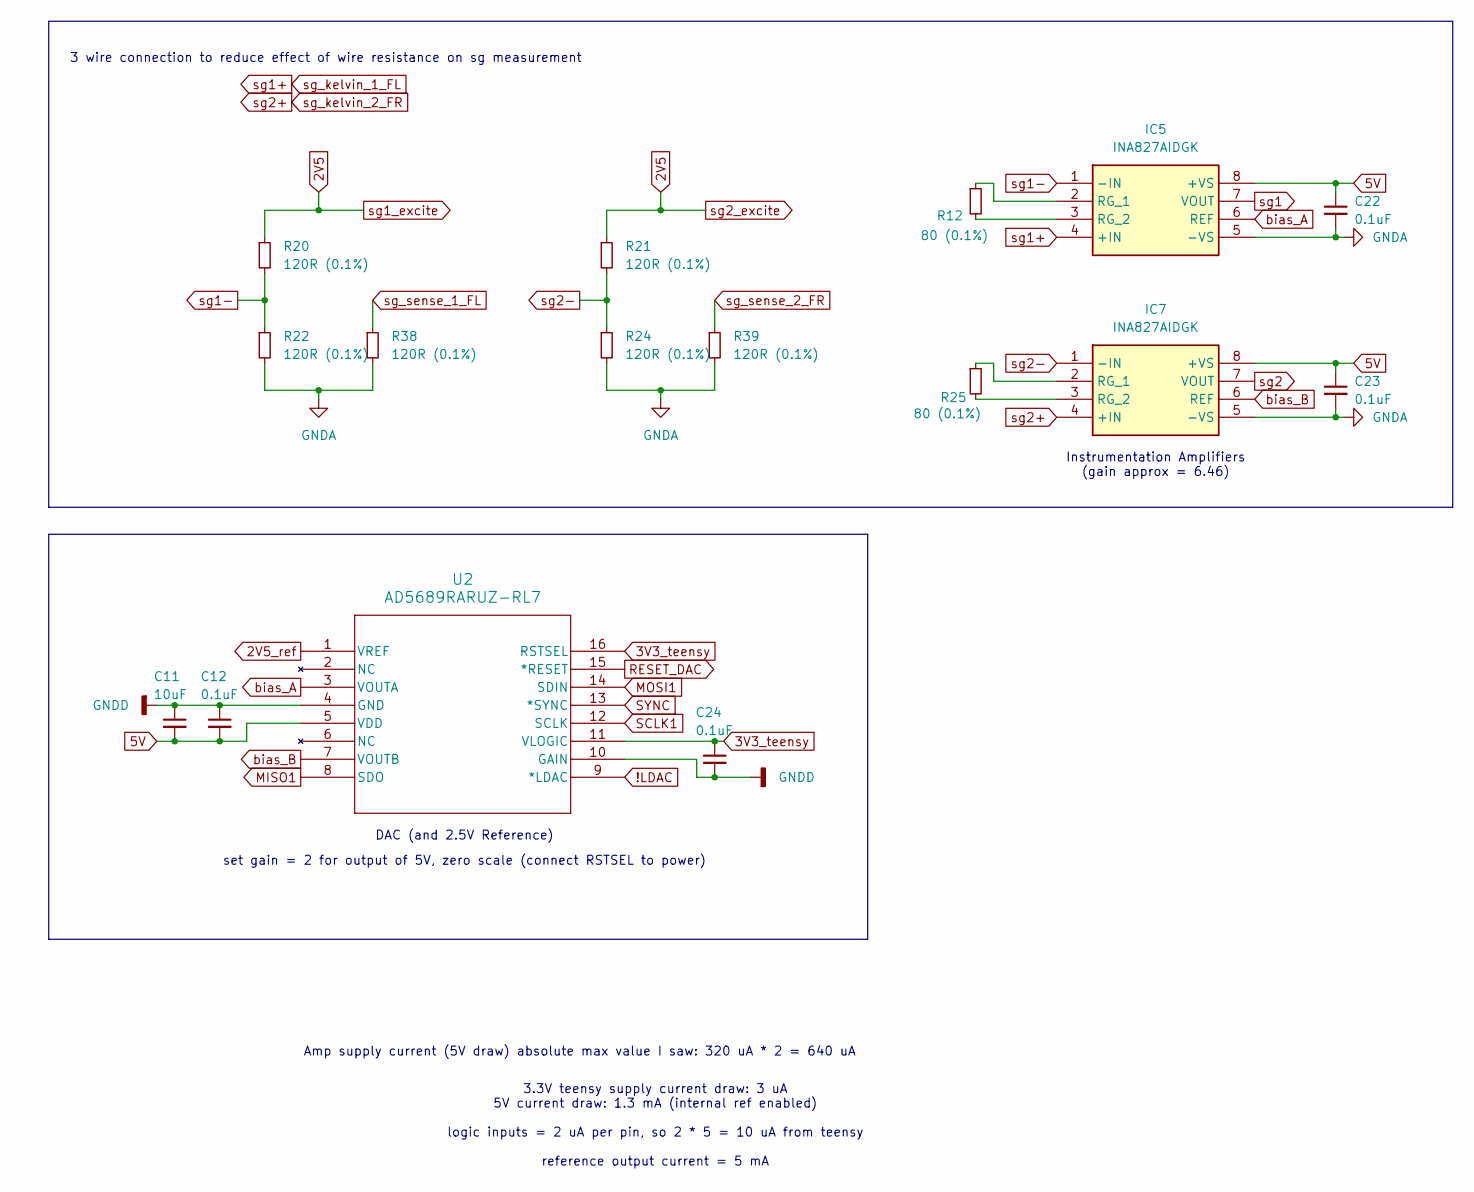
[picture p57: schematic sg_processing.kicad_sch]

Parts:
C11: 10uF; C_0603_1608Metric
C12, C22, C23, C24: 0.1uF; C_0402_1005Metric
IC5, IC7: INA827AIDGK; SOP65P490X110-8N; Mouser Part Number 595-INA827AIDGK
R12, R25: 80 (0.1%); R_0402_1005Metric
R20, R21, R22, R24, R38, R39: 120R (0.1%); R_0402_1005Metric
U2: AD5689RARUZ-RL7; RU_16_ADI

Connections:
2V5: R20.1, R21.1; also elsewhere on the board
2V5_ref: U2.1 (VREF); also elsewhere on the board
3V3_teensy: C24.1, U2.11 (VLOGIC), U2.16 (RSTSEL); also elsewhere on the board
5V: C11.2, C12.2, C22.1, C23.1, IC5.8 (+VS), IC7.8 (+VS), U2.5 (VDD); also elsewhere on the board
!LDAC: U2.9 (*LDAC); also elsewhere on the board
GNDA: C22.2, C23.2, IC5.5 (-VS), IC7.5 (-VS), R22.2, R24.2, R38.2, R39.2; also elsewhere on the board
GNDD: C11.1, C12.1, C24.2, U2.4 (GND), U2.10 (GAIN); also elsewhere on the board
MISO1: U2.8 (SDO); also elsewhere on the board
MOSI1: U2.14 (SDIN); also elsewhere on the board
unnamed: IC5.2 (RG_1), R12.1
unnamed: IC5.3 (RG_2), R12.2
unnamed: IC7.2 (RG_1), R25.1
unnamed: IC7.3 (RG_2), R25.2
RESET_DAC: U2.15 (*RESET); also elsewhere on the board
SCLK1: U2.12 (SCLK); also elsewhere on the board
SYNC: U2.13 (*SYNC); also elsewhere on the board
bias_A: IC5.6 (REF), U2.3 (VOUTA)
bias_B: IC7.6 (REF), U2.7 (VOUTB)
sg1: IC5.7 (VOUT); also elsewhere on the board
sg1+: IC5.4 (+IN); also elsewhere on the board
sg1-: IC5.1 (-IN), R20.2, R22.1
sg2: IC7.7 (VOUT); also elsewhere on the board
sg2+: IC7.4 (+IN); also elsewhere on the board
sg2-: IC7.1 (-IN), R21.2, R24.1
sg_sense_1_FL: R38.1; also elsewhere on the board
sg_sense_2_FR: R39.1; also elsewhere on the board

Notes on the sheet:
DAC (and 2.5V Reference)
Amp supply current (5V draw) absolute max value I saw: 320 uA * 2 = 640 uA
3.3V teensy supply current draw: 3 uA 5V current draw: 1.3 mA (internal ref enabled) logic inputs = 2 uA per pin, so 2 * 5 = 10 uA from teensy reference output current = 5 mA
set gain = 2 for output of 5V, zero scale (connect RSTSEL to power)
Instrumentation Amplifiers (gain approx = 6.46)
3 wire connection to reduce effect of wire resistance on sg measurement

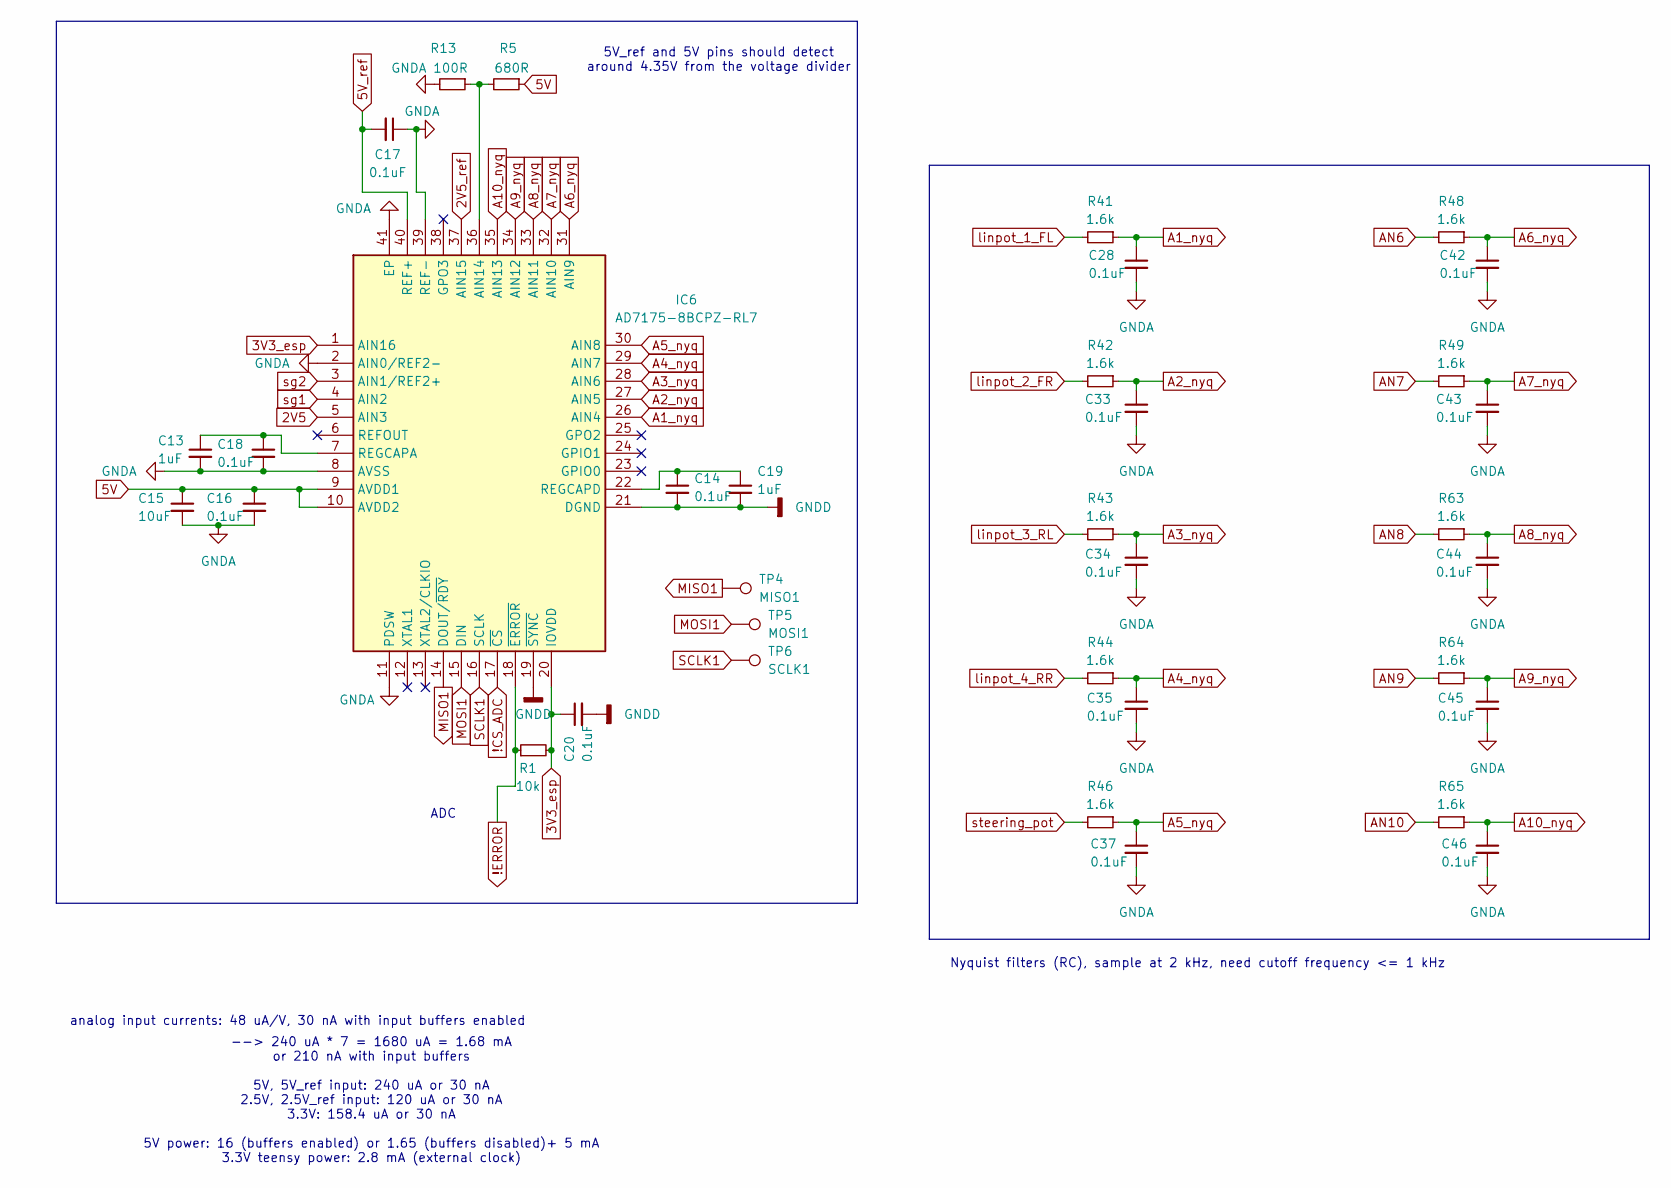
[picture p58: schematic analog_processing.kicad_sch]

Parts:
C13, C19: 1uF; C_0402_1005Metric
C14, C16, C17, C18, C20, C28, C33, C34, C35, C37, C42, C43, C44, C45, C46: 0.1uF; C_0402_1005Metric
C15: 10uF; C_0603_1608Metric
IC6: AD7175-8BCPZ-RL7; QFN50P600X600X80-41N-D; Mouser Part Number 584-AD7175-8BCPZ-RL7
R1: 10k; R_0402_1005Metric
R5: 680R; R_0402_1005Metric
R13: 100R; R_0402_1005Metric
R41, R42, R43, R44, R46, R48, R49, R63, R64, R65: 1.6k; R_0402_1005Metric
TP4: MISO1; TestPoint_Pad_1.0x1.0mm
TP5: MOSI1; TestPoint_Pad_1.0x1.0mm
TP6: SCLK1; TestPoint_Pad_1.0x1.0mm

Connections:
2V5: IC6.5 (AIN3); also elsewhere on the board
2V5_ref: IC6.37 (AIN15); also elsewhere on the board
3V3_esp: C20.1, IC6.1 (AIN16), IC6.20 (IOVDD), R1.2; also elsewhere on the board
5V: C15.1, C16.1, IC6.9 (AVDD1), IC6.10 (AVDD2), R5.1; also elsewhere on the board
5V_ref: C17.2, IC6.40 (REF+); also elsewhere on the board
!CS_ADC: IC6.17 (~CS); also elsewhere on the board
!ERROR: IC6.18 (~ERROR), R1.1; also elsewhere on the board
A1_nyq: C28.1, IC6.26 (AIN4), R41.1
A2_nyq: C33.1, IC6.27 (AIN5), R42.1
A3_nyq: C34.1, IC6.28 (AIN6), R43.1
A4_nyq: C35.1, IC6.29 (AIN7), R44.1
A5_nyq: C37.1, IC6.30 (AIN8), R46.1
A6_nyq: C42.1, IC6.31 (AIN9), R48.1
A7_nyq: C43.1, IC6.32 (AIN10), R49.1
A8_nyq: C44.1, IC6.33 (AIN11), R63.1
A9_nyq: C45.1, IC6.34 (AIN12), R64.1
A10_nyq: C46.1, IC6.35 (AIN13), R65.1
AN1: R41.2; also elsewhere on the board
AN2: R42.2; also elsewhere on the board
AN3: R43.2; also elsewhere on the board
AN4: R44.2; also elsewhere on the board
AN5: R46.2; also elsewhere on the board
AN6: R48.2; also elsewhere on the board
AN7: R49.2; also elsewhere on the board
AN8: R63.2; also elsewhere on the board
AN9: R64.2; also elsewhere on the board
AN10: R65.2; also elsewhere on the board
GNDA: C13.2, C15.2, C16.2, C17.1, C18.2, C28.2, C33.2, C34.2, C35.2, C37.2, C42.2, C43.2, C44.2, C45.2, C46.2, IC6.2 (AIN0/REF2-), IC6.8 (AVSS), IC6.11 (PDSW), IC6.39 (REF-), IC6.41 (EP), R13.2; also elsewhere on the board
GNDD: C14.2, C19.2, C20.2, IC6.19 (~SYNC), IC6.21 (DGND); also elsewhere on the board
MISO1: IC6.14 (DOUT/~RDY), TP4.1; also elsewhere on the board
MOSI1: IC6.15 (DIN), TP5.1; also elsewhere on the board
unnamed: IC6.36 (AIN14), R5.2, R13.1
unnamed: C13.1, C18.1, IC6.7 (REGCAPA)
unnamed: C14.1, C19.1, IC6.22 (REGCAPD)
SCLK1: IC6.16 (SCLK), TP6.1; also elsewhere on the board
sg1: IC6.4 (AIN2); also elsewhere on the board
sg2: IC6.3 (AIN1/REF2+); also elsewhere on the board

Notes on the sheet:
ADC
--> 240 uA * 7 = 1680 uA = 1.68 mA or 210 nA with input buffers 5V, 5V_ref input: 240 uA or 30 nA 2.5V, 2.5V_ref input: 120 uA or 30 nA 3.3V: 158.4 uA or 30 nA 5V power: 16 (buffers enabled) or 1.65 (buffers disabled)+ 5 mA 3.3V teensy power: 2.8 mA (external clock)
analog input currents: 48 uA/V, 30 nA with input buffers enabled
Nyquist filters (RC), sample at 2 kHz, need cutoff frequency <= 1 kHz
5V_ref and 5V pins should detect around 4.35V from the voltage divider

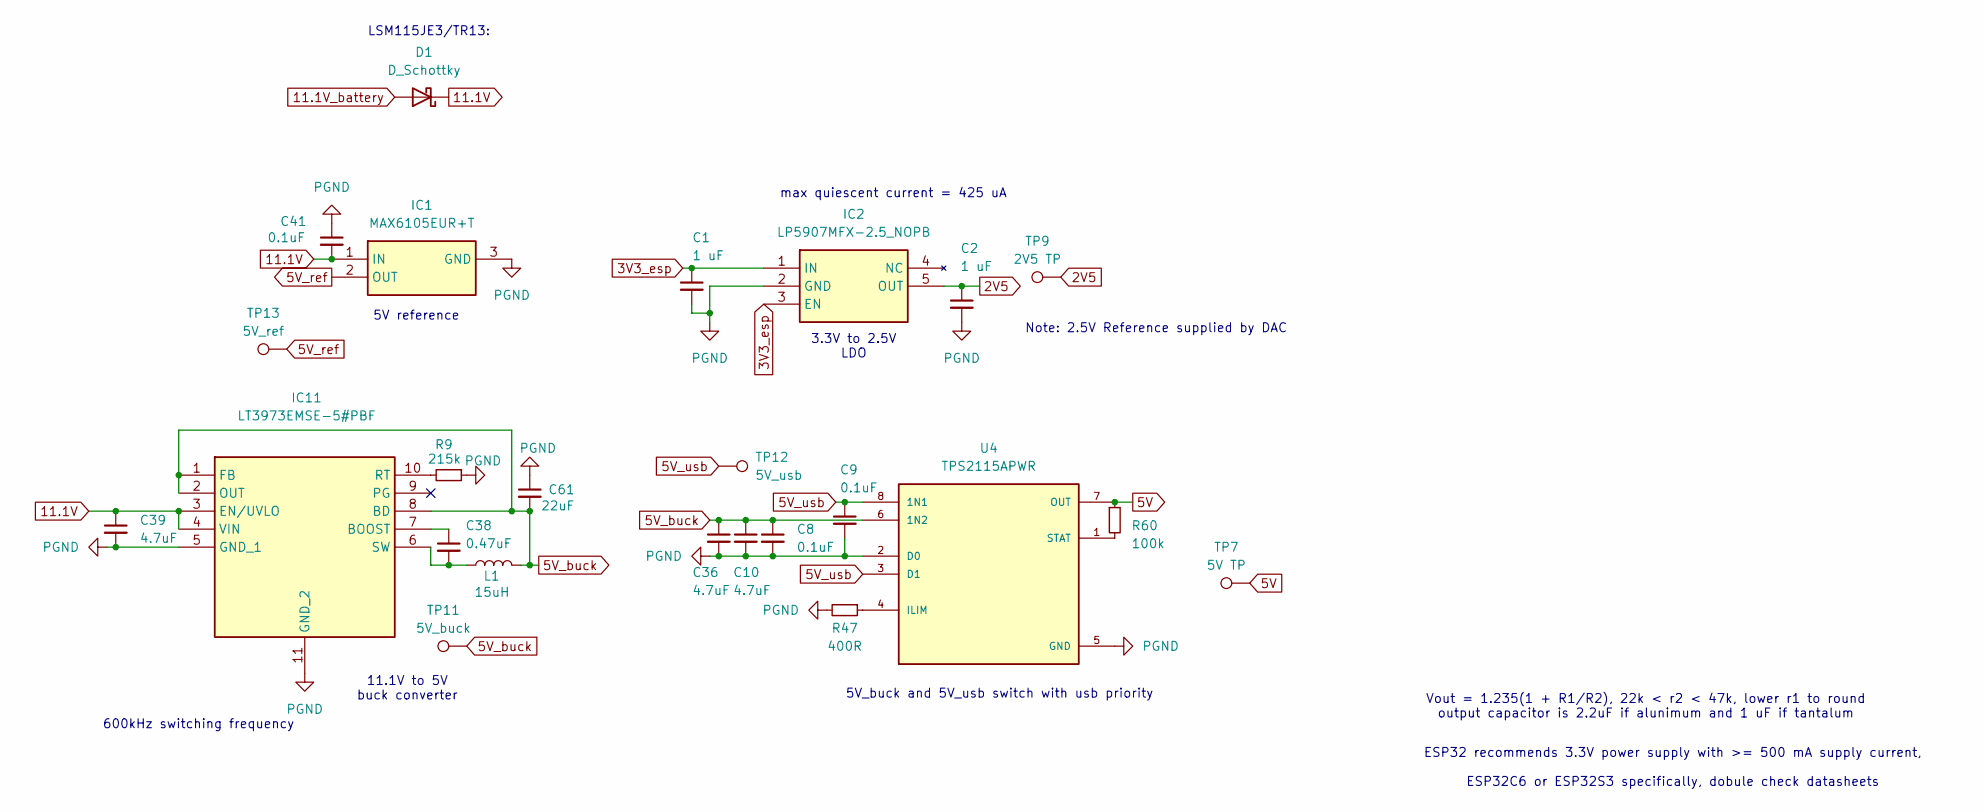
[picture p59: schematic power.kicad_sch]

Parts:
C1, C2: 1 uF; C_0402_1005Metric
C8, C9, C41: 0.1uF; C_0402_1005Metric
C10, C36, C39: 4.7uF; C_0402_1005Metric
C38: 0.47uF; C_0402_1005Metric
C61: 22uF; C_0603_1608Metric
D1: D_Schottky; DO-214BA_MCH
IC1: MAX6105EUR+T; SOT-23-3; Mouser Part Number 700-MAX6105EURT
IC2: LP5907MFX-2.5_NOPB; SOT-23-5; Mouser Part Number 595-LP5907MFX2.5NOPB
IC11: LT3973EMSE-5#PBF; SOP50P490X110-11N; Mouser Part Number 584-LT3973EMSE-5#PBF
L1: 15uH; NRS4012T150MDGJ
R9: 215k; R_0402_1005Metric
R47: 400R; R_0402_1005Metric
R60: 100k; R_0402_1005Metric
TP7: 5V TP; TestPoint_Pad_1.0x1.0mm
TP9: 2V5 TP; TestPoint_Pad_1.0x1.0mm
TP11: 5V_buck; TestPoint_Pad_1.0x1.0mm
TP12: 5V_usb; TestPoint_Pad_1.0x1.0mm
TP13: 5V_ref; TestPoint_Pad_1.0x1.0mm
U4: TPS2115APWR; SOP65P640X120-8N; PARTREV F

Connections:
2V5: C2.1, IC2.5 (OUT), TP9.1; also elsewhere on the board
3V3_esp: C1.1, IC2.1 (IN), IC2.3 (EN); also elsewhere on the board
5V: R60.1, TP7.1, U4.7 (OUT); also elsewhere on the board
5V_buck: C8.1, C10.1, C36.1, C61.2, IC11.1 (FB), IC11.2 (OUT), IC11.8 (BD), L1.2, TP11.1, U4.6 (1N2); also elsewhere on the board
5V_ref: IC1.2 (OUT), TP13.1; also elsewhere on the board
5V_usb: C9.1, TP12.1, U4.3 (D1), U4.8 (1N1); also elsewhere on the board
11.1V: C39.1, C41.2, D1.1 (K), IC1.1 (IN), IC11.3 (EN/UVLO), IC11.4 (VIN)
11.1V_battery: D1.2 (A); also elsewhere on the board
unnamed: C38.1, IC11.7 (BOOST)
unnamed: IC11.10 (RT), R9.2
unnamed: C38.2, IC11.6 (SW), L1.1
unnamed: R47.1, U4.4 (ILIM)
unnamed: R60.2, U4.1 (STAT)
PGND: C1.2, C2.2, C8.2, C9.2, C10.2, C36.2, C39.2, C41.1, C61.1, IC1.3 (GND), IC2.2 (GND), IC11.5 (GND_1), IC11.11 (GND_2), R9.1, R47.2, U4.2 (D0), U4.5 (GND); also elsewhere on the board

Notes on the sheet:
5V reference
LSM115JE3/TR13:
11.1V to 5V buck converter
5V_buck and 5V_usb switch with usb priority
max quiescent current = 425 uA
ESP32 recommends 3.3V power supply with >= 500 mA supply current, ESP32C6 or ESP32S3 specifically, dobule check datasheets
Vout = 1.235(1 + R1/R2), 22k < r2 < 47k, lower r1 to round output capacitor is 2.2uF if alunimum and 1 uF if tantalum
3.3V to 2.5V LDO
Note: 2.5V Reference supplied by DAC
600kHz switching frequency

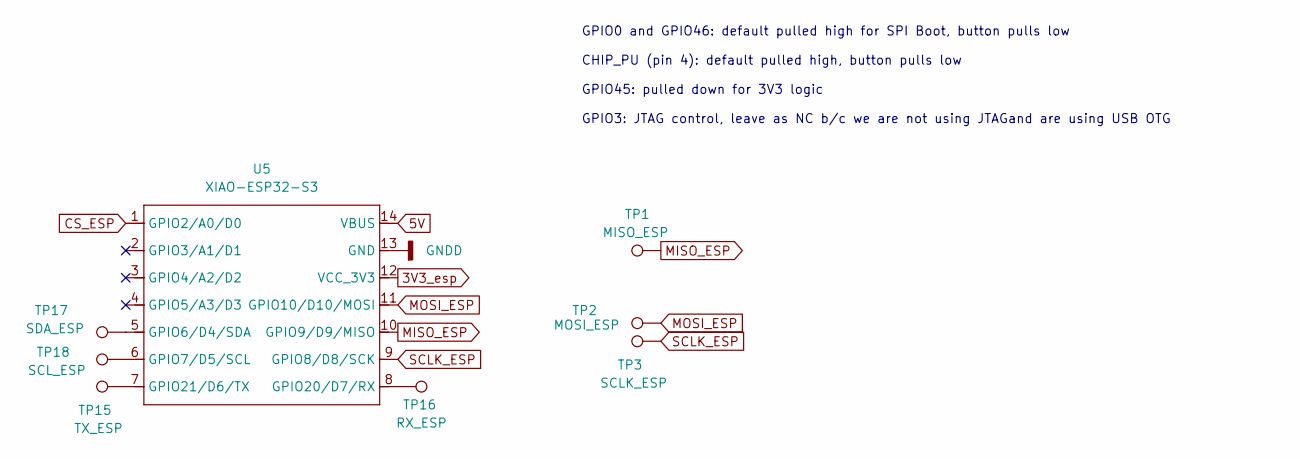
[picture p60: schematic esp32s3.kicad_sch]

Parts:
TP1: MISO_ESP; TestPoint_Pad_1.0x1.0mm
TP2: MOSI_ESP; TestPoint_Pad_1.0x1.0mm
TP3: SCLK_ESP; TestPoint_Pad_1.0x1.0mm
TP15: TX_ESP; TestPoint_Pad_1.0x1.0mm
TP16: RX_ESP; TestPoint_Pad_1.0x1.0mm
TP17: SDA_ESP; TestPoint_Pad_1.0x1.0mm
TP18: SCL_ESP; TestPoint_Pad_1.0x1.0mm
U5: XIAO-ESP32-S3; XIAO-ESP32S3-SMD

Connections:
3V3_esp: U5.12 (VCC_3V3); also elsewhere on the board
5V: U5.14 (VBUS); also elsewhere on the board
CS_ESP: U5.1 (GPIO2/A0/D0); also elsewhere on the board
GNDD: U5.13 (GND); also elsewhere on the board
MISO_ESP: TP1.1, U5.10 (GPIO9/D9/MISO); also elsewhere on the board
MOSI_ESP: TP2.1, U5.11 (GPIO10/D10/MOSI); also elsewhere on the board
unnamed 83: TP17.1, U5.5 (GPIO6/D4/SDA); also elsewhere on the board
unnamed 84: TP18.1, U5.6 (GPIO7/D5/SCL); also elsewhere on the board
unnamed 85: TP16.1, U5.8 (GPIO20/D7/RX); also elsewhere on the board
unnamed 86: TP15.1, U5.7 (GPIO21/D6/TX); also elsewhere on the board
SCLK_ESP: TP3.1, U5.9 (GPIO8/D8/SCK); also elsewhere on the board

Notes on the sheet:
GPIO0 and GPIO46: default pulled high for SPI Boot, button pulls low CHIP_PU (pin 4): default pulled high, button pulls low GPIO45: pulled down for 3V3 logic GPIO3: JTAG control, leave as NC b/c we are not using JTAGand are using USB OTG

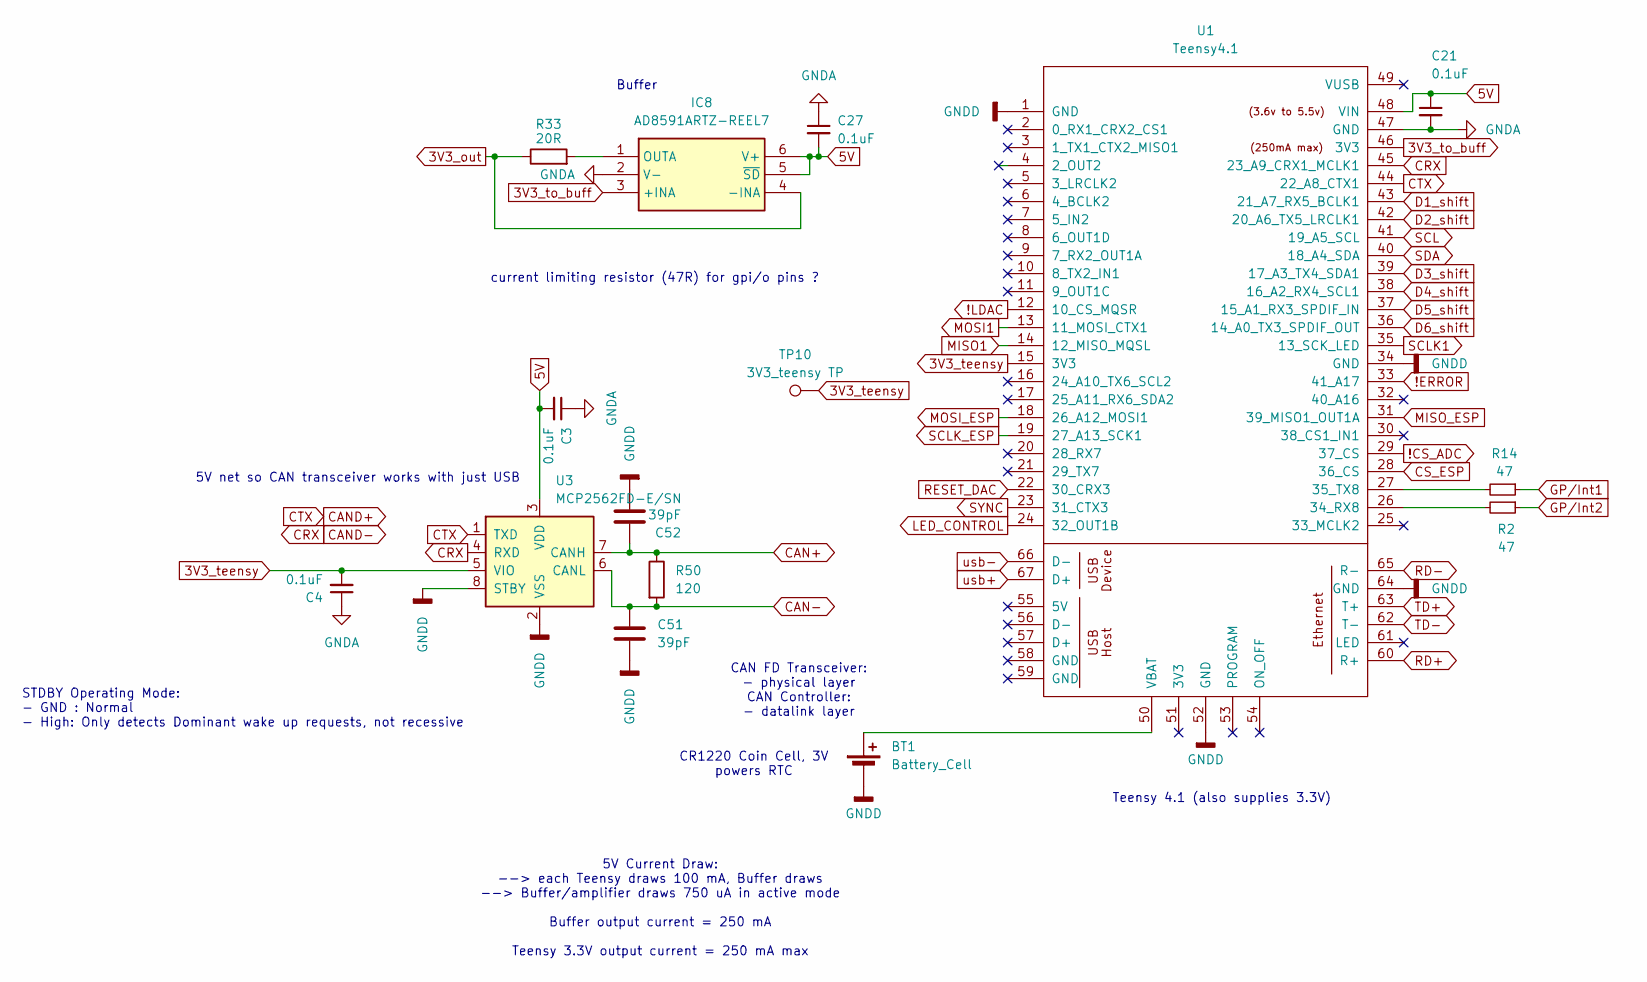
[picture p61: schematic teensy.kicad_sch]

Parts:
BT1: Battery_Cell; BatteryHolder_LINX_BAT-HLD-012-SMT
C3, C4, C21, C27: 0.1uF; C_0402_1005Metric
C51, C52: 39pF; C_0402_1005Metric
IC8: AD8591ARTZ-REEL7; SOT95P280X145-6N; Mouser Part Number 584-AD8591ARTZ-R7
R2, R14: 47; R_0402_1005Metric
R33: 20R; R_0402_1005Metric
R50: 120; R_1206_3216Metric
TP10: 3V3_teensy TP; TestPoint_Pad_1.0x1.0mm
U1: Teensy4.1; Teensy41
U3: MCP2562FD-E/SN; SOIC-8_3.9x4.9mm_P1.27mm

Connections:
3V3_out: IC8.4 (-INA), R33.1; also elsewhere on the board
3V3_teensy: C4.2, TP10.1, U1.15 (3V3), U3.5 (VIO); also elsewhere on the board
3V3_to_buff: IC8.3 (+INA), U1.46 (3V3)
5V: C3.2, C21.1, C27.2, IC8.5 (~SD), IC8.6 (V+), U1.48 (VIN), U3.3 (VDD); also elsewhere on the board
!CS_ADC: U1.29 (37_CS); also elsewhere on the board
!ERROR: U1.33 (41_A17); also elsewhere on the board
!LDAC: U1.12 (10_CS_MQSR); also elsewhere on the board
CAN+: C52.1, R50.1, U3.7 (CANH); also elsewhere on the board
CAN-: C51.1, R50.2, U3.6 (CANL); also elsewhere on the board
CAND+: U1.44 (22_A8_CTX1), U3.1 (TXD)
CAND-: U1.45 (23_A9_CRX1_MCLK1), U3.4 (RXD)
CS_ESP: U1.28 (36_CS); also elsewhere on the board
D1_shift: U1.43 (21_A7_RX5_BCLK1); also elsewhere on the board
D2_shift: U1.42 (20_A6_TX5_LRCLK1); also elsewhere on the board
D3_shift: U1.39 (17_A3_TX4_SDA1); also elsewhere on the board
D4_shift: U1.38 (16_A2_RX4_SCL1); also elsewhere on the board
D5_shift: U1.37 (15_A1_RX3_SPDIF_IN); also elsewhere on the board
D6_shift: U1.36 (14_A0_TX3_SPDIF_OUT); also elsewhere on the board
GNDA: C3.1, C4.1, C21.2, C27.1, IC8.2 (V-), U1.47 (GND); also elsewhere on the board
GNDD: BT1.2 (-), C51.2, C52.2, U1.1 (GND), U1.34 (GND), U1.52 (GND), U1.64 (GND), U3.2 (VSS), U3.8 (STBY); also elsewhere on the board
GP/Int1: R14.1; also elsewhere on the board
GP/Int2: R2.1; also elsewhere on the board
LED_CONTROL: U1.24 (32_OUT1B); also elsewhere on the board
MISO1: U1.14 (12_MISO_MQSL); also elsewhere on the board
MISO_ESP: U1.31 (39_MISO1_OUT1A); also elsewhere on the board
MOSI1: U1.13 (11_MOSI_CTX1); also elsewhere on the board
MOSI_ESP: U1.18 (26_A12_MOSI1); also elsewhere on the board
unnamed: BT1.1 (+), U1.50 (VBAT)
unnamed: IC8.1 (OUTA), R33.2
unnamed: R2.2, U1.26 (34_RX8)
unnamed: R14.2, U1.27 (35_TX8)
RD+: U1.60 (R+); also elsewhere on the board
RD-: U1.65 (R-); also elsewhere on the board
RESET_DAC: U1.22 (30_CRX3); also elsewhere on the board
SCL: U1.41 (19_A5_SCL); also elsewhere on the board
SCLK1: U1.35 (13_SCK_LED); also elsewhere on the board
SCLK_ESP: U1.19 (27_A13_SCK1); also elsewhere on the board
SDA: U1.40 (18_A4_SDA); also elsewhere on the board
SYNC: U1.23 (31_CTX3); also elsewhere on the board
TD+: U1.63 (T+); also elsewhere on the board
TD-: U1.62 (T-); also elsewhere on the board
usb+: U1.67 (D+); also elsewhere on the board
usb-: U1.66 (D-); also elsewhere on the board

Notes on the sheet:
Buffer
5V Current Draw: --> each Teensy draws 100 mA, Buffer draws --> Buffer/amplifier draws 750 uA in active mode Buffer output current = 250 mA Teensy 3.3V output current = 250 mA max
STDBY Operating Mode: - GND : Normal - High: Only detects Dominant wake up requests, not recessive
CR1220 Coin Cell, 3V powers RTC
Teensy 4.1 (also supplies 3.3V)
5V net so CAN transceiver works with just USB
CAN FD Transceiver: - physical layer CAN Controller: - datalink layer
current limiting resistor (47R) for gpi/o pins ?
