BlueJayRacing/22xt_kicad/01-main_board/main_board_v3/main_board_v3.kicad_pcb

## KiCad design 01-main_board/main_board_v3/main_board_v3.kicad_pcb (continued)

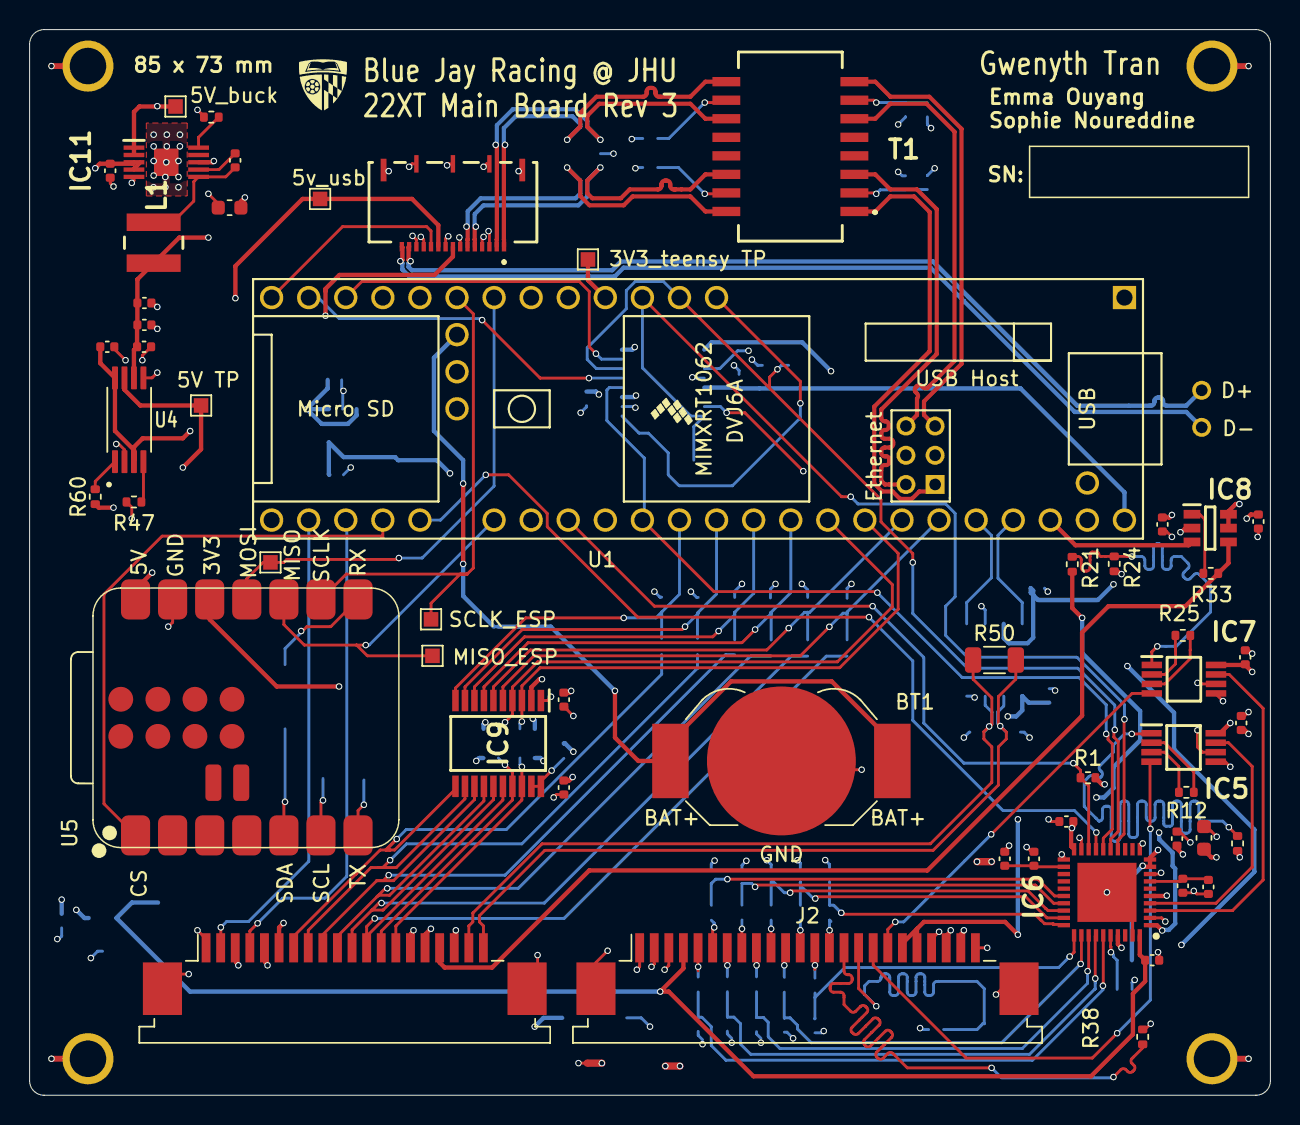
[picture p62: board main_board_v3.kicad_pcb from above]

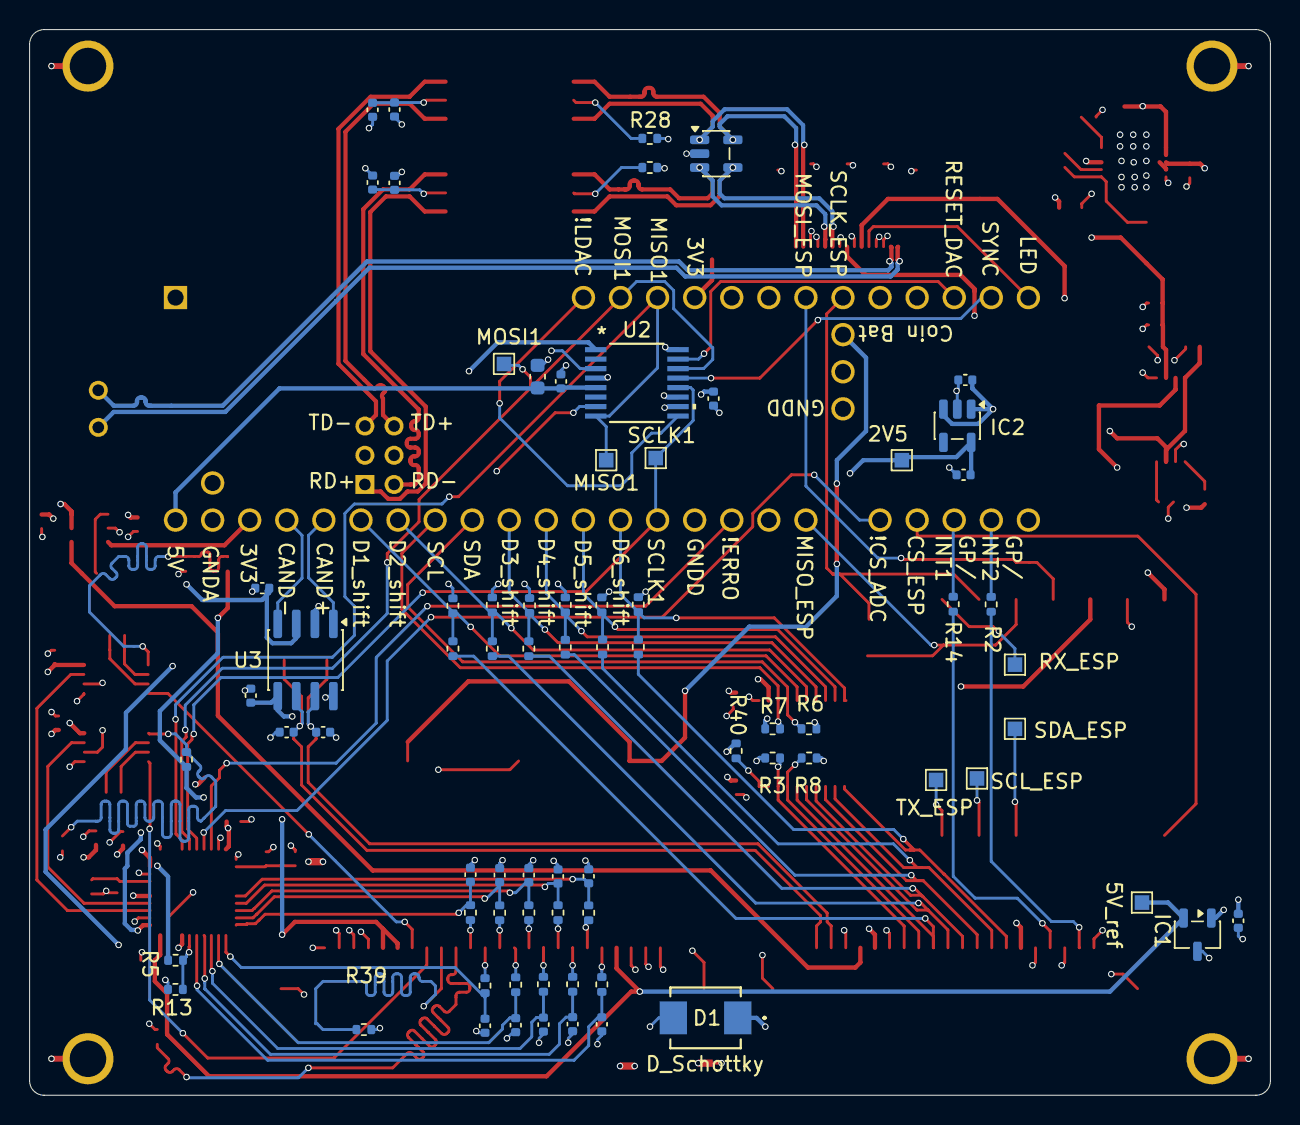
[picture p63: board main_board_v3.kicad_pcb from below]

Board: 4 copper layers, 85.0 x 73.0 mm, 136 parts (74 on the bottom side), 116 nets.

Other parts of the board:
2V5: 2V5 TP; TestPoint_Pad_1.0x1.0mm
5V_buck: 5V_buck; TestPoint_Pad_1.0x1.0mm
5v_usb: 5V_usb; TestPoint_Pad_1.0x1.0mm
RX_ESP: RX_ESP; TestPoint_Pad_1.0x1.0mm
SCL_ESP: SCL_ESP; TestPoint_Pad_1.0x1.0mm
SDA_ESP: SDA_ESP; TestPoint_Pad_1.0x1.0mm
TX_ESP: TX_ESP; TestPoint_Pad_1.0x1.0mm

Their connections:
2V5: 2V5.1; also elsewhere on the board
5V_buck: 5V_buck.1; also elsewhere on the board
5V_usb: 5v_usb.1; also elsewhere on the board
unnamed 83: SDA_ESP.1; also elsewhere on the board
unnamed 84: SCL_ESP.1; also elsewhere on the board
unnamed 85: RX_ESP.1; also elsewhere on the board
unnamed 86: TX_ESP.1; also elsewhere on the board
