BlueJayRacing/22xt_kicad/01-main_board/main_board_peripheral_v3_1/main_board_peripheral_v3_1.kicad_pcb

## KiCad design 01-main_board/main_board_peripheral_v3_1/main_board_peripheral_v3_1.kicad_pcb (2026-03-13)

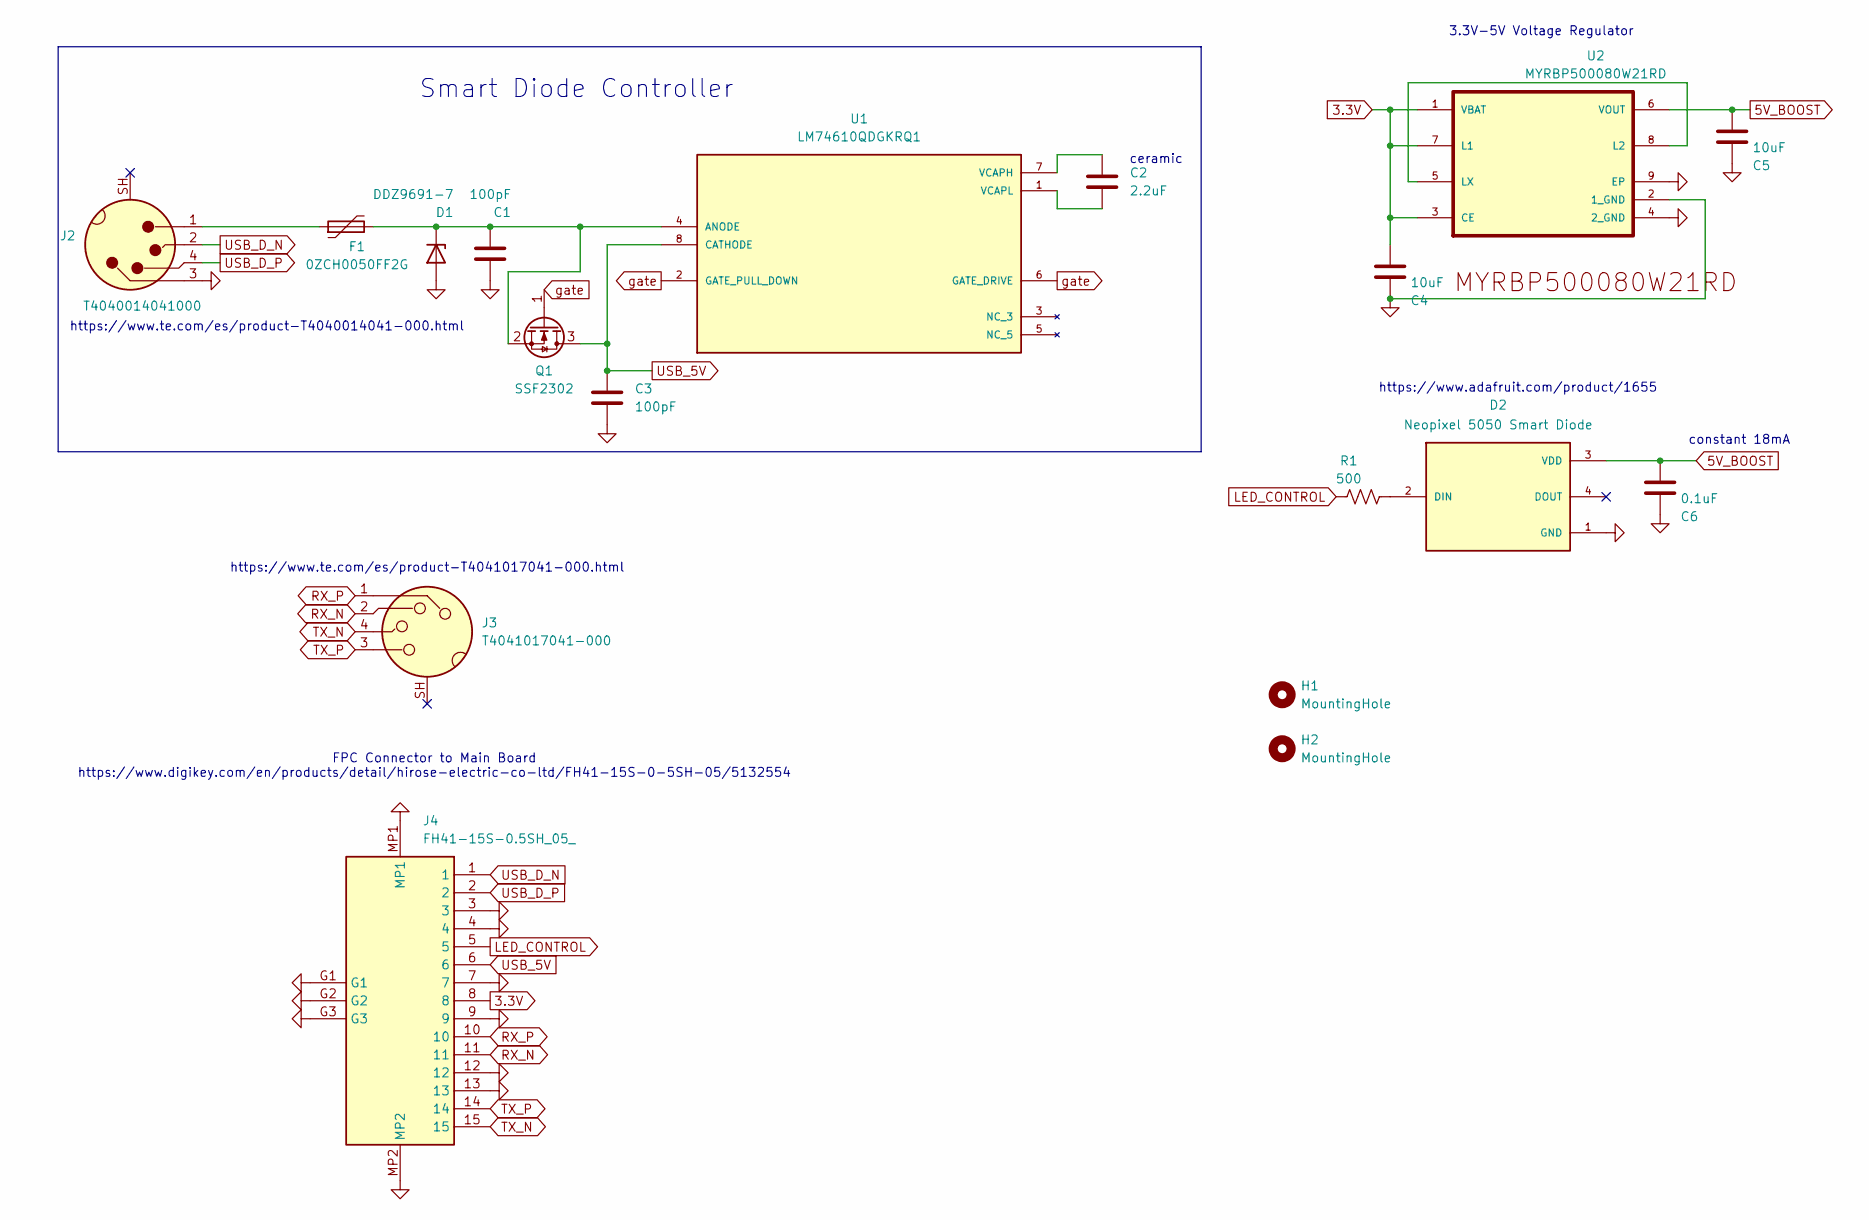
[picture p64: schematic main_board_peripheral_v3_1.kicad_sch]

Parts:
C1, C3: 100pF; C_0402_1005Metric
C2: 2.2uF; C_0402_1005Metric
C4, C5: 10uF; C_0603_1608Metric
C6: 0.1uF; C_0402_1005Metric
D1: DDZ9691-7; DDZ9691Q-7
D2: Neopixel 5050 Smart Diode; LED_5050
F1: 0ZCH0050FF2G
H1, H2: MountingHole; ToolingHole_1.152mm
J2: T4040014041000
J3: T4041017041-000; T4041017041000
J4: FH41-15S-0.5SH_05_; FH4115S05SH05; Mouser Part Number 798-FH4115S05SH05
Q1: SSF2302
R1: 500; R_0402_1005Metric
U1: LM74610QDGKRQ1; PARTREV B
U2: MYRBP500080W21RD; MURATA_MYRBP500080W21RD_0; MPN MYRBP500080W21RD

Connections:
3.3V: C4.1, J4.8, U2.1 (VBAT), U2.3 (CE), U2.7 (L1)
5V_BOOST: C5.1, C6.1, D2.3 (VDD), U2.6 (VOUT)
GND: C1.1, C3.2, C4.2, C5.2, C6.2, D1.2 (A), D2.1 (GND), J2.3, J4.3, J4.4, J4.7, J4.9, J4.12, J4.13, J4.G1, J4.G2, J4.G3, J4.MP1, J4.MP2, U2.2 (1_GND), U2.4 (2_GND), U2.9 (EP)
LED_CONTROL: J4.5, R1.1
unnamed: C1.2, D1.1 (K), F1.2, Q1.2 (S), U1.4 (ANODE)
unnamed: D2.2 (DIN), R1.2
unnamed: F1.1, J2.1
unnamed: C2.1, U1.7 (VCAPH)
unnamed: C2.2, U1.1 (VCAPL)
unnamed: U2.5 (LX), U2.8 (L2)
RX_N: J3.2, J4.11
RX_P: J3.1, J4.10
TX_N: J3.4, J4.15
TX_P: J3.3, J4.14
USB_5V: C3.1, J4.6, Q1.3 (D), U1.8 (CATHODE)
USB_D_N: J2.2, J4.1
USB_D_P: J2.4, J4.2
gate: Q1.1 (G), U1.2 (GATE_PULL_DOWN), U1.6 (GATE_DRIVE)

Notes on the sheet:
constant 18mA
3.3V-5V Voltage Regulator
FPC Connector to Main Board https://www.digikey.com/en/products/detail/hirose-electric-co-ltd/FH41-15S-0-5SH-05/5132554
https://www.te.com/es/product-T4041017041-000.html
https://www.adafruit.com/product/1655
ceramic
Smart Diode Controller
https://www.te.com/es/product-T4040014041-000.html

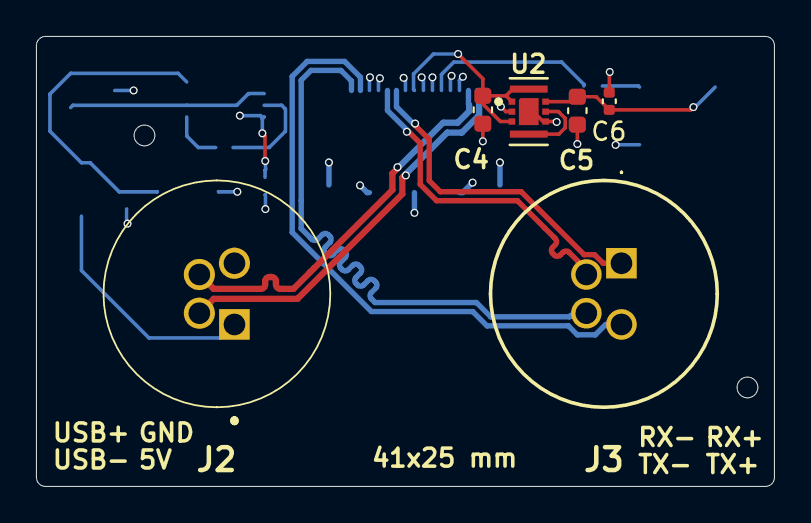
[picture p65: board main_board_peripheral_v3_1.kicad_pcb from above]

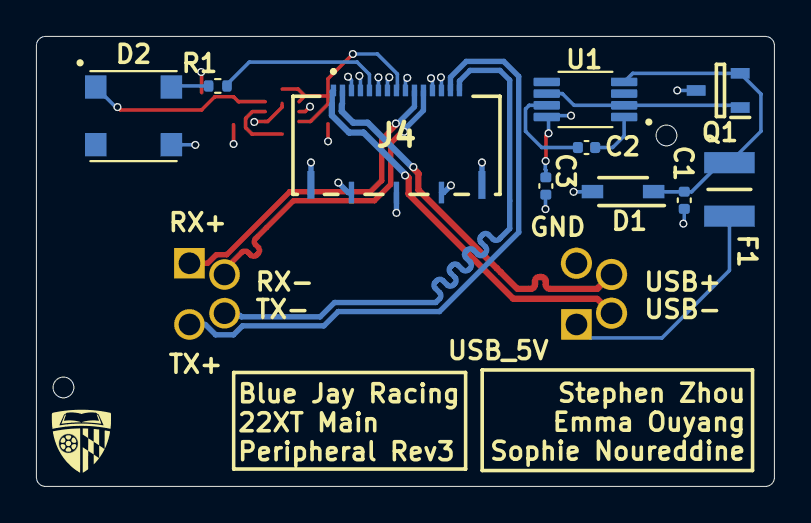
[picture p66: board main_board_peripheral_v3_1.kicad_pcb from below]

Board: 4 copper layers, 41.0 x 25.0 mm, 18 parts (10 on the bottom side), 18 nets.
