BlueJayRacing/22xt_kicad/01-main_board/main_board_peripheral_v2/main_board_peripheral_v2.kicad_pcb

## KiCad design 01-main_board/main_board_peripheral_v2/main_board_peripheral_v2.kicad_pcb (2026-01-04, an earlier design)

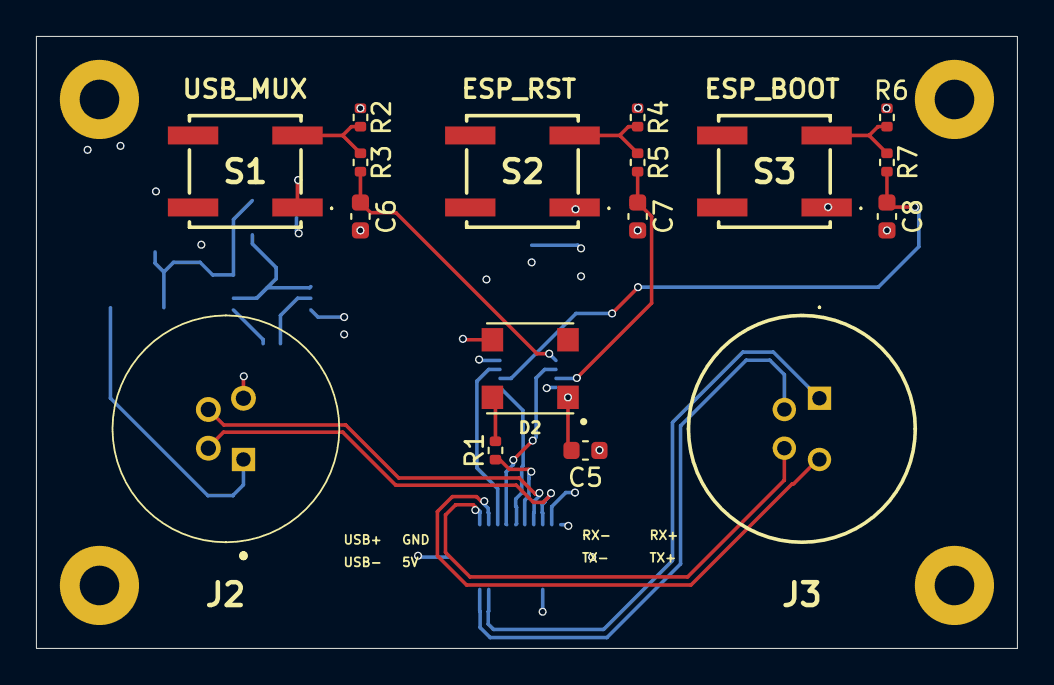
[picture p67: board main_board_peripheral_v2.kicad_pcb from above]

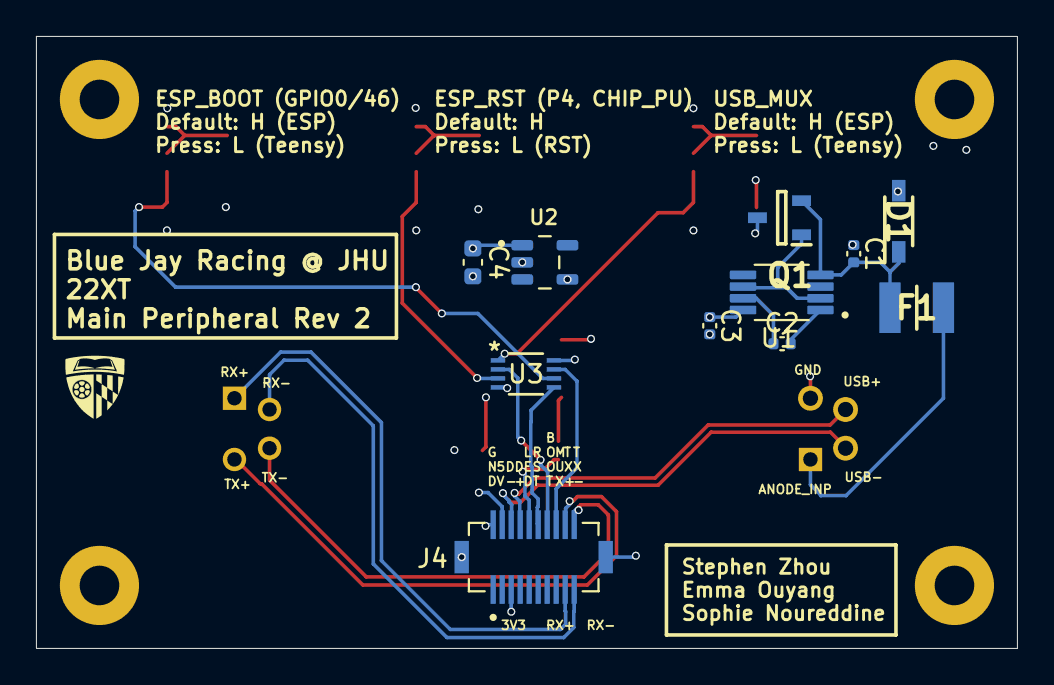
[picture p68: board main_board_peripheral_v2.kicad_pcb from below]

Board: 4 copper layers, 54.5 x 34.0 mm, 32 parts (11 on the bottom side), 26 nets.

Parts:
C1, C3: 100pF; C_0402_1005Metric
C2: 2.2uF; C_0402_1005Metric
C4, C5, C6, C7, C8: 10uF; C_0603_1608Metric
D1: DDZ9691-7; DDZ9691Q-7
D2: Neopixel 5050 Smart Diode; LED_5050
F1: 0ZCH0050FF2G
H1, H2, H3, H4: MountingHole; MountingHole_2.2mm_M2_Pad
J2: T4040014041000
J3: T4041017041-000; T4041017041000
J4: DF12NB_5.0_-20DP-0.5V_51_
Q1: SSF2302
R1: 500R; R_0402_1005Metric
R2, R4, R6: 1.4KR; R_0402_1005Metric
R3, R5, R7: 750R; R_0402_1005Metric
S1, S2, S3: KSC253J_SP_DELTA_LFG; KSC253JSPDELTALFG
U1: LM74610QDGKRQ1
U2: TPS613222ADBVR
U3: NL37WZ14USG

Connections:
3.3V: C4.1, J4.5, U2.1 (SW)
5V_BOOST: C5.1, D2.3 (VDD), U2.4 (VOUT), U3.8 (VCC)
ESP_BOOT_CONTROL: J4.14, U3.2 (OUT*Y3)
ESP_RESET_CONTROL: J4.12, U3.5 (OUT*Y2)
GND: C1.1, C3.2, C4.2, C5.2, C6.2, C7.2, C8.2, D1.2 (A), D2.1 (GND), H1.1 (GND), H2.1 (GND), H3.1 (GND), H4.1 (GND), J2.3, J4.2, J4.S1, J4.S2, S1.1 (NO1), S2.1 (NO1), S3.1 (NO1), U2.2 (GND), U3.4 (GND)
LED_CONTROL: J4.10, R1.1
unnamed: C1.2, D1.1 (K), F1.2, Q1.2 (S), U1.4 (ANODE)
unnamed: D2.2 (DIN), R1.2
unnamed: F1.1, J2.1
unnamed: R2.2, R3.1, S1.3 (COM1)
unnamed: R4.2, R5.1, S2.3 (COM1)
unnamed: R6.2, R7.1, S3.3 (COM1)
unnamed: C2.1, U1.7 (VCAPH)
unnamed: C2.2, U1.1 (VCAPL)
RX_N: J3.2, J4.19
RX_P: J3.1, J4.17
TX_N: J3.4, J4.20
TX_P: J3.3, J4.18
USB_5V: C3.1, J4.4, Q1.3 (D), R2.1, R4.1, R6.1, U1.8 (CATHODE)
USB_D_N: J2.2, J4.6
USB_D_P: J2.4, J4.8
USB_MUX_CONTROL: J4.16, U3.7 (OUT*Y1)
button_ESP_BOOT: C8.1, R7.2, U3.6 (INA3)
button_ESP_RESET: C7.1, R5.2, U3.3 (INA2)
button_USB_MUX: C6.1, R3.2, U3.1 (INA1)
gate: Q1.1 (G), U1.2 (GATE_PULL_DOWN), U1.6 (GATE_DRIVE)
