BlueJayRacing/22xt_kicad/02-wsg/WSG_2.0/WSG_2.0.kicad_pcb

## KiCad design 02-wsg/WSG_2.0/WSG_2.0.kicad_pcb (2026-01-05)

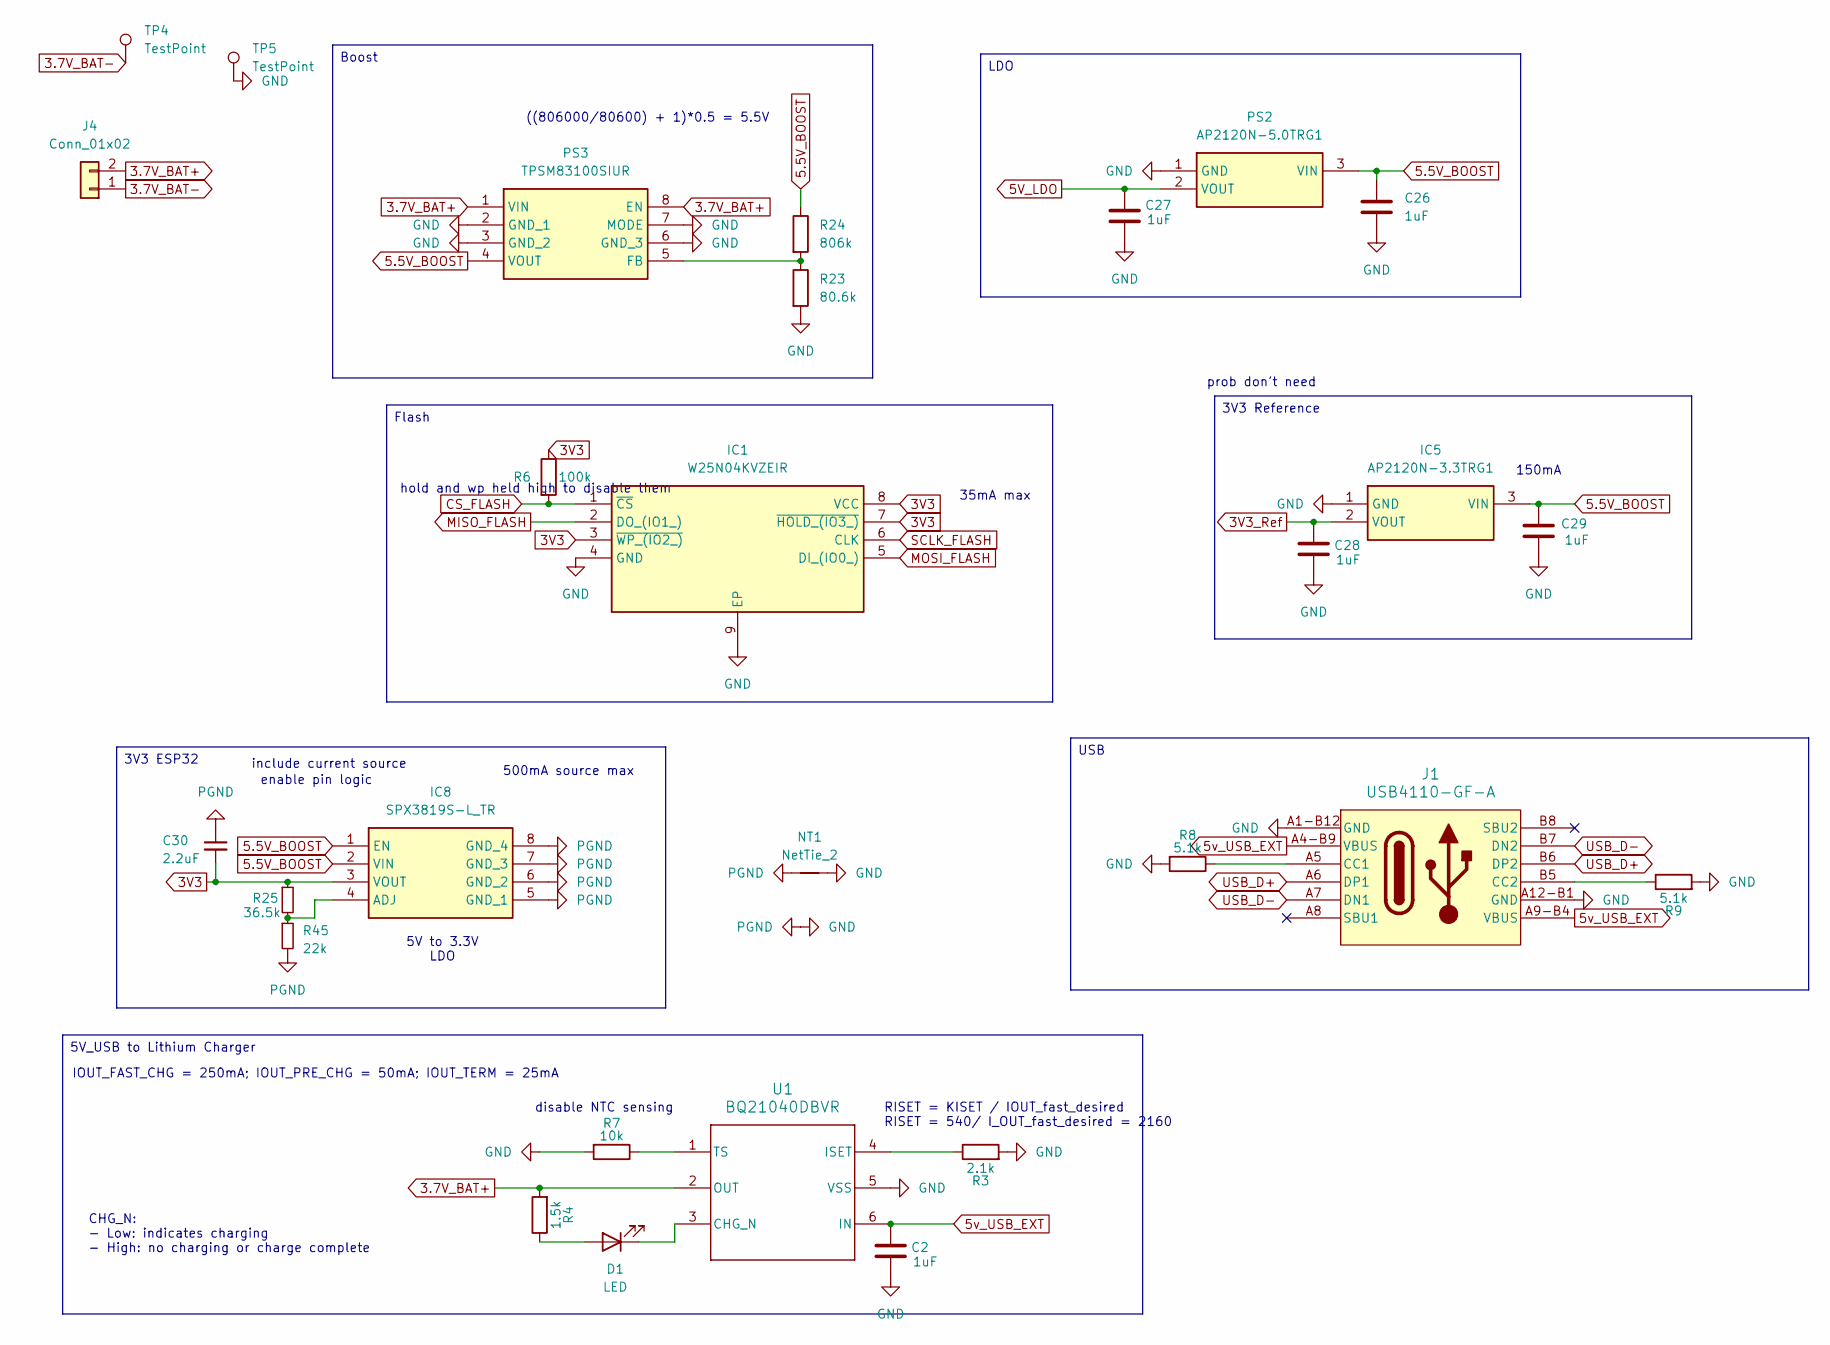
[picture p69: schematic untitled.kicad_sch]

Parts:
C2: 1uF; C_0603_1608Metric
C26, C27, C28, C29: 1uF; C_0402_1005Metric
C30: 2.2uF; C_0402_1005Metric
D1: LED; D_0402_1005Metric
IC1: W25N04KVZEIR; SON127P800X600X80-9N-D; Mouser Part Number 454-W25N04KVZEIR
IC5: AP2120N-3.3TRG1; Mouser Part Number 621-AP2120N-3.3TRG1
IC8: SPX3819S-L_TR; SOIC127P600X175-8N; Mouser Part Number 701-SPX3819S-L/TR
J1: USB4110-GF-A; USB4110-GF-A_GCT
J4: Conn_01x02; PinHeader_1x02_P1.00mm_Horizontal
NT1: NetTie_2
PS2: AP2120N-5.0TRG1; AP2120N-5.0TRG; Mouser Part Number 621-AP2120N-5.0TRG1
PS3: TPSM83100SIUR; Mouser Part Number 595-TPSM83100SIUR
R3: 2.1k; R_0402_1005Metric
R4: 1.5k; R_0402_1005Metric
R6: 100k; R_0402_1005Metric
R7: 10k; R_0402_1005Metric
R8, R9: 5.1k; R_0402_1005Metric
R23: 80.6k; R_0402_1005Metric
R24: 806k; R_0402_1005Metric
R25: 36.5k; R_0402_1005Metric
R45: 22k; R_0402_1005Metric
TP4, TP5: TestPoint; TestPoint_Pad_1.0x1.0mm
U1: BQ21040DBVR

Connections:
3.7V_BAT+: J4.2, PS3.1 (VIN), PS3.8 (EN), R4.2, U1.2 (OUT)
3.7V_BAT-: J4.1, TP4.1
3V3: C30.2, IC1.3 (~WP_(IO2_)), IC1.7 (~HOLD_(IO3_)), IC1.8 (VCC), IC8.3 (VOUT), R6.1, R25.1; also elsewhere on the board
3V3_Ref: C28.1, IC5.2 (VOUT); also elsewhere on the board
5.5V_BOOST: C26.1, C29.1, IC5.3 (VIN), IC8.1 (EN), IC8.2 (VIN), PS2.3 (VIN), PS3.4 (VOUT), R24.1
5V_LDO: C27.1, PS2.2 (VOUT); also elsewhere on the board
5v_USB_EXT: C2.1, J1.A4-B9 (VBUS), J1.A9-B4 (VBUS), U1.6 (IN)
CS_FLASH: IC1.1 (~CS), R6.2; also elsewhere on the board
GND: C2.2, C26.2, C27.2, C28.2, C29.2, C30.1, IC1.4 (GND), IC1.9 (EP), IC5.1 (GND), IC8.5 (GND_1), IC8.6 (GND_2), IC8.7 (GND_3), IC8.8 (GND_4), J1.A1-B12 (GND), J1.A12-B1 (GND), NT1.1, NT1.2, PS2.1 (GND), PS3.2 (GND_1), PS3.3 (GND_2), PS3.6 (GND_3), PS3.7 (MODE), R3.2, R7.2, R8.2, R9.2, R23.2, R45.2, TP5.1, U1.5 (VSS); also elsewhere on the board
MISO_ADC: IC1.2 (DO_(IO1_)); also elsewhere on the board
MOSI_ADC: IC1.5 (DI_(IO0_)); also elsewhere on the board
unnamed: D1.2 (A), R4.1
unnamed: D1.1 (K), U1.3 (CHG_N)
unnamed: IC8.4 (ADJ), R25.2, R45.1
unnamed: J1.A5 (CC1), R8.1
unnamed: J1.B5 (CC2), R9.1
unnamed: PS3.5 (FB), R23.1, R24.2
unnamed: R3.1, U1.4 (ISET)
unnamed: R7.1, U1.1 (TS)
SCLK_ADC: IC1.6 (CLK); also elsewhere on the board
USB_D+: J1.A6 (DP1), J1.B6 (DP2); also elsewhere on the board
USB_D-: J1.A7 (DN1), J1.B7 (DN2); also elsewhere on the board

Notes on the sheet:
RISET = KISET / IOUT_fast_desired RISET = 540/ I_OUT_fast_desired = 2160
enable pin logic
500mA source max
150mA
((806000/80600) + 1)*0.5 = 5.5V
include current source
disable NTC sensing
hold and wp held high to disable them
5V to 3.3V LDO
IOUT_FAST_CHG = 250mA; IOUT_PRE_CHG = 50mA; IOUT_TERM = 25mA
35mA max
prob don't need
CHG_N: - Low: indicates charging - High: no charging or charge complete
Boost
LDO
USB
3V3 Reference
3V3 ESP32
Flash
5V_USB to Lithium Charger

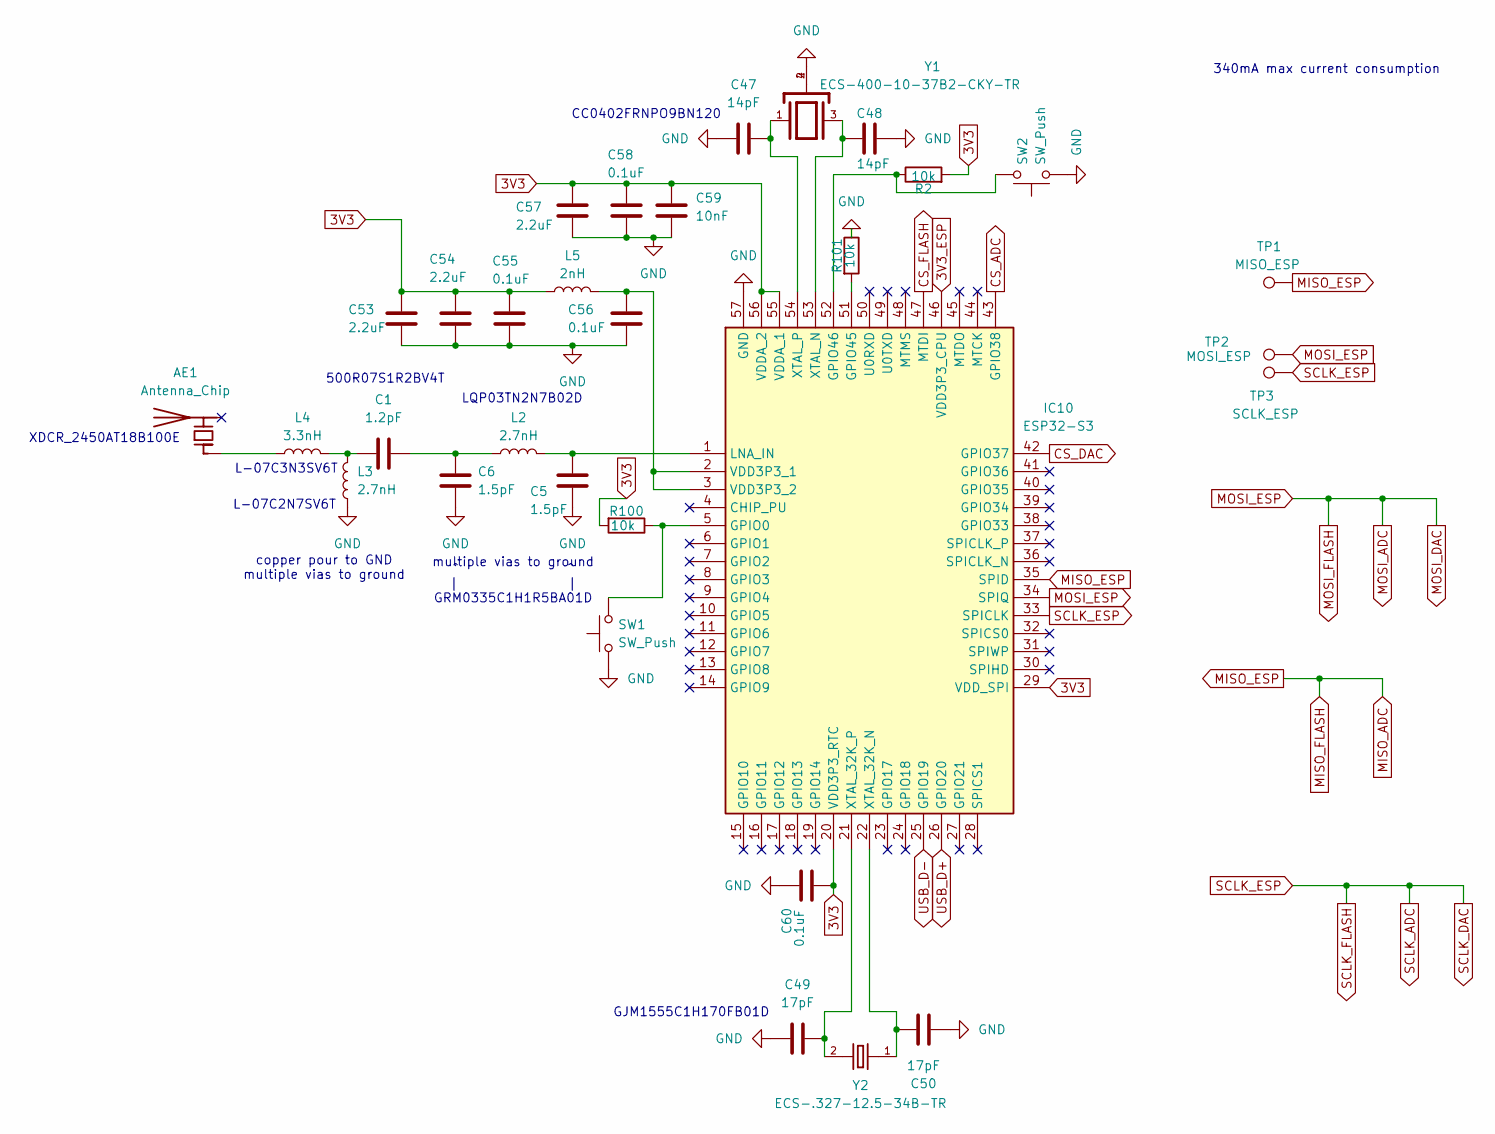
[picture p70: schematic ESP32_flash.kicad_sch]

Parts:
AE1: Antenna_Chip; XDCR_2450AT18B100E
C1: 1.2pF; C_0402_1005Metric
C5, C6: 1.5pF; C_0402_1005Metric
C47, C48: 14pF; C_0402_1005Metric
C49, C50: 17pF; C_0402_1005Metric
C53, C54, C57: 2.2uF; C_0402_1005Metric
C55, C56, C58, C60: 0.1uF; C_0402_1005Metric
C59: 10nF; C_0402_1005Metric
IC10: ESP32-S3; ESP32-S2FH2; Mouser Part Number 356-ESP32-S3
L2, L3: 2.7nH; L_0402_1005Metric
L4: 3.3nH; L_0402_1005Metric
L5: 2nH; L_0402_1005Metric
R2, R100, R101: 10k; R_0402_1005Metric
SW1, SW2: SW_Push; NANOT100AS_butt
TP1: MISO_ESP; TestPoint_Pad_1.0x1.0mm
TP2: MOSI_ESP; TestPoint_Pad_1.0x1.0mm
TP3: SCLK_ESP; TestPoint_Pad_1.0x1.0mm
Y1: ECS-400-10-37B2-CKY-TR; XTAL_ECS-400-10-37B2-CKY-TR; PARTREV 2021
Y2: ECS-.327-12.5-34B-TR; XTAL_ECS-.327-12.5-34B-TR

Connections:
3V3: C53.1, C54.1, C55.1, C57.1, C58.1, C59.1, C60.1, IC10.20 (VDD3P3_RTC), IC10.29 (VDD_SPI), IC10.55 (VDDA_1), IC10.56 (VDDA_2), L5.1, R2.2, R100.2; also elsewhere on the board
3V3_ESP: IC10.46 (VDD3P3_CPU)
CS_ADC: IC10.43 (GPIO38); also elsewhere on the board
CS_DAC: IC10.42 (GPIO37); also elsewhere on the board
CS_FLASH: IC10.47 (MTDI); also elsewhere on the board
GND: C5.2, C6.2, C47.2, C48.2, C49.2, C50.2, C53.2, C54.2, C55.2, C56.2, C57.2, C58.2, C59.2, C60.2, IC10.57 (GND), L3.1, R101.1, SW1.1, SW2.1, Y1.2, Y1.4; also elsewhere on the board
MISO_ADC: IC10.35 (SPID), TP1.1; also elsewhere on the board
MOSI_ADC: IC10.34 (SPIQ), TP2.1; also elsewhere on the board
unnamed: AE1.1 (FEED), L4.1
unnamed: C1.1, L3.2, L4.2
unnamed: C1.2, C6.1, L2.1
unnamed: IC10.5 (GPIO0), R100.1, SW1.2
unnamed: IC10.51 (GPIO45), R101.2
unnamed: IC10.52 (GPIO46), R2.1, SW2.2
unnamed: C5.1, IC10.1 (LNA_IN), L2.2
unnamed: C56.1, IC10.2 (VDD3P3_1), IC10.3 (VDD3P3_2), L5.2
unnamed: C50.1, IC10.22 (XTAL_32K_N), Y2.1
unnamed: C49.1, IC10.21 (XTAL_32K_P), Y2.2
unnamed: C48.1, IC10.53 (XTAL_N), Y1.3
unnamed: C47.1, IC10.54 (XTAL_P), Y1.1
SCLK_ADC: IC10.33 (SPICLK), TP3.1; also elsewhere on the board
USB_D+: IC10.26 (GPIO20); also elsewhere on the board
USB_D-: IC10.25 (GPIO19); also elsewhere on the board

Notes on the sheet:
XDCR_2450AT18B100E
CC0402FRNPO9BN120
^ ^ | | GRM0335C1H1R5BA01D
340mA max current consumption
copper pour to GND multiple vias to ground
L-07C3N3SV6T
LQP03TN2N7B02D
L-07C2N7SV6T
multiple vias to ground
GJM1555C1H170FB01D
500R07S1R2BV4T

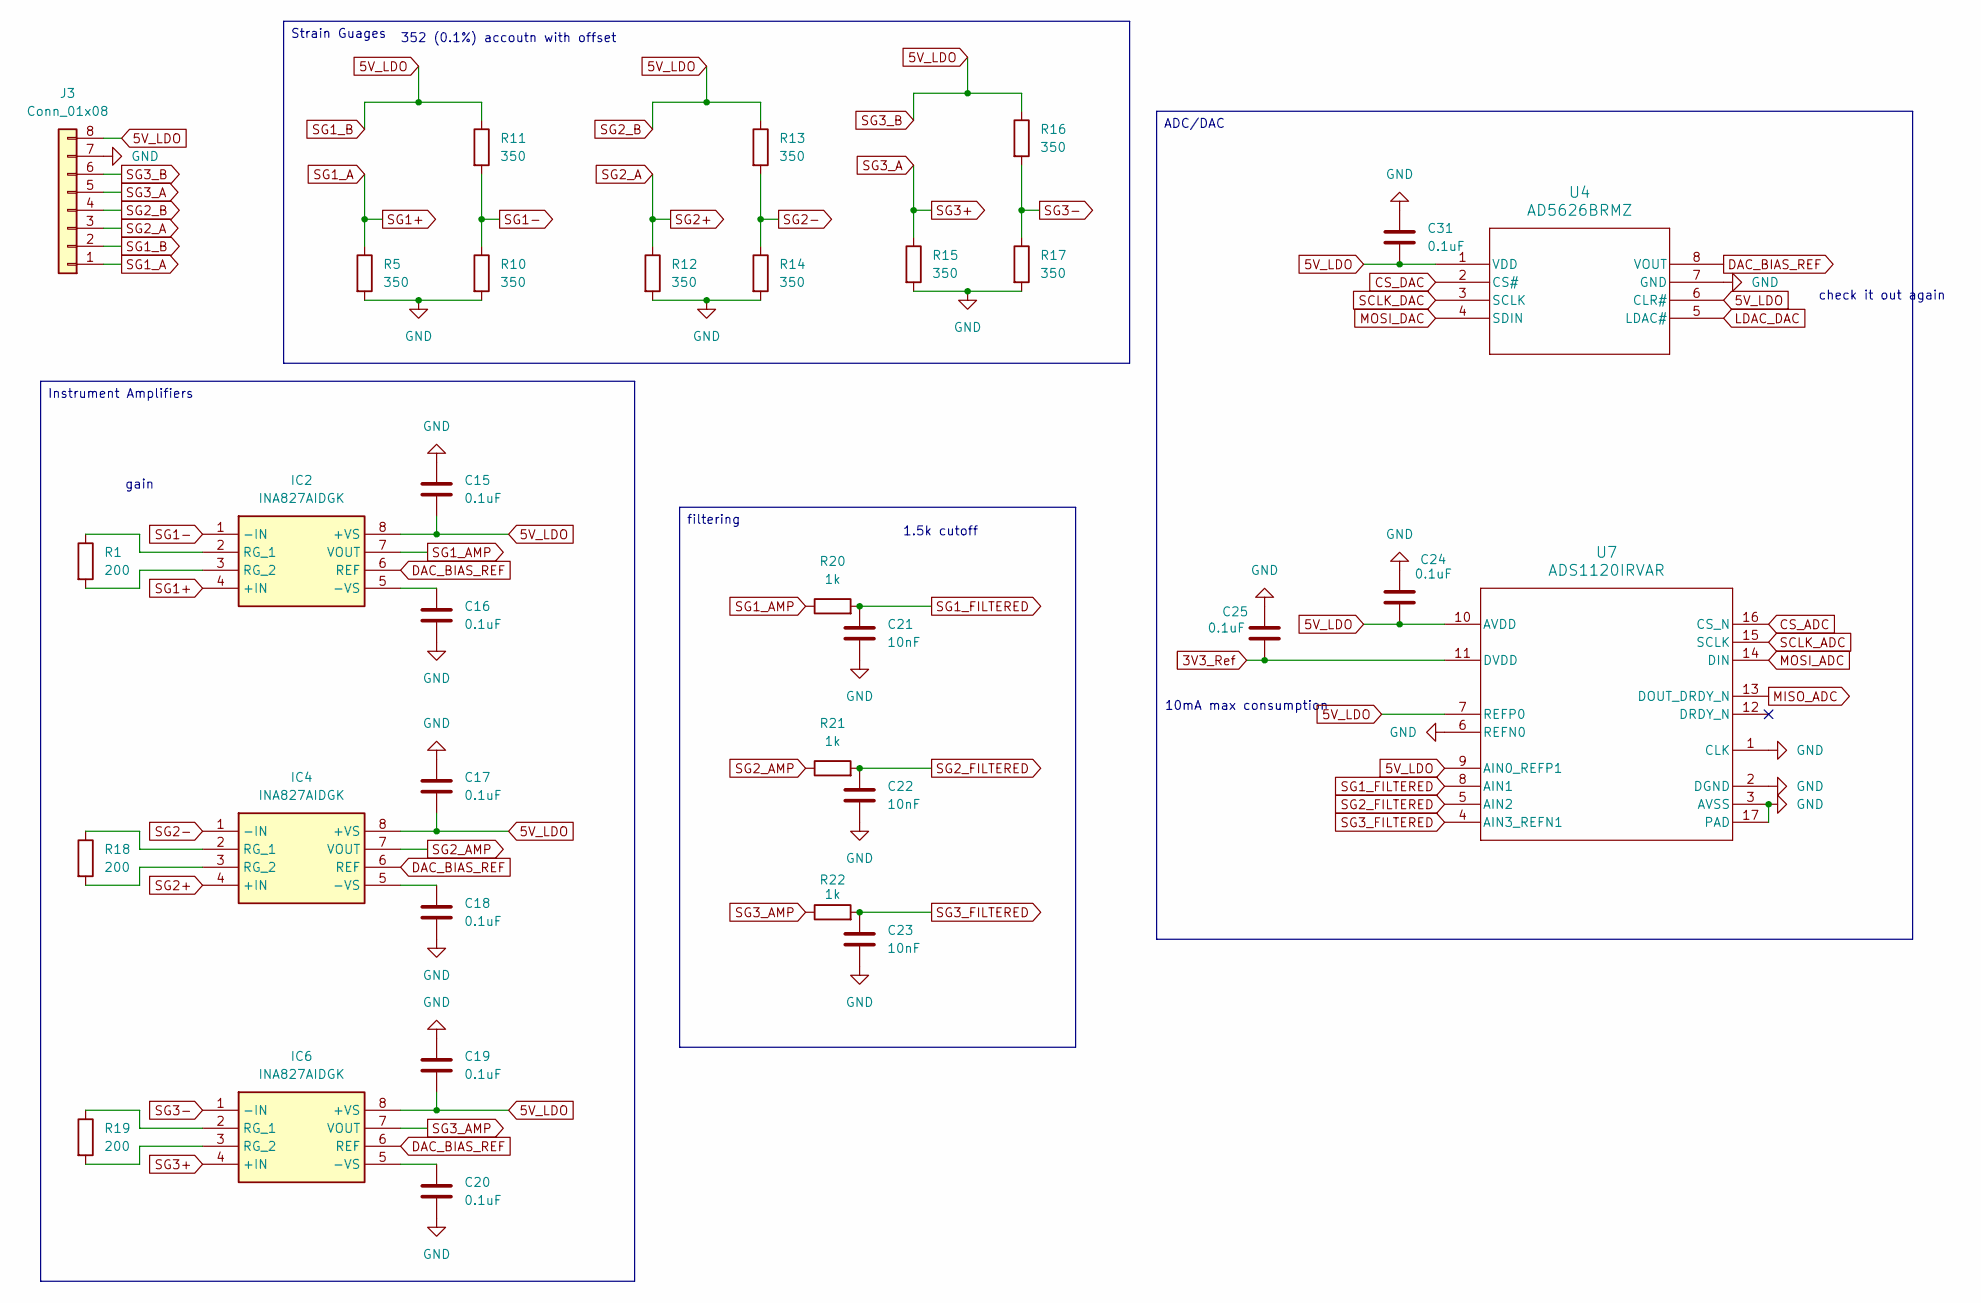
[picture p71: schematic WSG_ADC.kicad_sch]

Parts:
C15, C16, C17, C18, C19, C20, C24, C25, C31: 0.1uF; C_0402_1005Metric
C21, C22, C23: 10nF; C_0402_1005Metric
IC2, IC4, IC6: INA827AIDGK; Mouser Part Number 595-INA827AIDGK
J3: Conn_01x08; M12A-08PFFP-SF8001
R1, R18, R19: 200; R_0402_1005Metric
R5, R10, R11, R12, R13, R14, R15, R16, R17: 350; R_0402_1005Metric
R20, R21, R22: 1k; R_0402_1005Metric
U4: AD5626BRMZ; SOP65P490X110-8N
U7: ADS1120IRVAR

Connections:
3V3_Ref: C25.2, U7.11 (DVDD); also elsewhere on the board
5V_LDO: C15.2, C17.2, C19.2, C24.2, C31.2, IC2.8 (+VS), IC4.8 (+VS), IC6.8 (+VS), J3.2, J3.4, J3.6, J3.8, R11.1, R13.1, R16.1, U4.1 (VDD), U4.6 (CLR#), U7.7 (REFP0), U7.9 (AIN0_REFP1), U7.10 (AVDD); also elsewhere on the board
CS_ADC: U7.16 (CS_N); also elsewhere on the board
CS_DAC: U4.2 (CS#); also elsewhere on the board
DAC_BIAS_REF: IC2.6 (REF), IC4.6 (REF), IC6.6 (REF), U4.8 (VOUT)
GND: C15.1, C16.2, C17.1, C18.2, C19.1, C20.2, C21.2, C22.2, C23.2, C24.1, C25.1, C31.1, J3.7, R5.2, R10.2, R12.2, R14.2, R15.2, R17.2, U4.7 (GND), U7.1 (CLK), U7.2 (DGND), U7.3 (AVSS), U7.6 (REFN0), U7.17 (PAD); also elsewhere on the board
LDAC_DAC: U4.5 (LDAC#)
MISO_ADC: U7.13 (DOUT_DRDY_N); also elsewhere on the board
MOSI_ADC: U4.4 (SDIN), U7.14 (DIN); also elsewhere on the board
unnamed: C16.1, IC2.5 (-VS)
unnamed: IC2.2 (RG_1), R1.1
unnamed: IC2.3 (RG_2), R1.2
unnamed: C18.1, IC4.5 (-VS)
unnamed: IC4.2 (RG_1), R18.1
unnamed: IC4.3 (RG_2), R18.2
unnamed: C20.1, IC6.5 (-VS)
unnamed: IC6.2 (RG_1), R19.1
unnamed: IC6.3 (RG_2), R19.2
SCLK_ADC: U4.3 (SCLK), U7.15 (SCLK); also elsewhere on the board
SG1+: IC2.4 (+IN), J3.1, R5.1
SG1-: IC2.1 (-IN), R10.1, R11.2
SG1_AMP: IC2.7 (VOUT), R20.1
SG1_FILTERED: C21.1, R20.2, U7.8 (AIN1)
SG2+: IC4.4 (+IN), J3.3, R12.1
SG2-: IC4.1 (-IN), R13.2, R14.1
SG2_AMP: IC4.7 (VOUT), R21.1
SG2_FILTERED: C22.1, R21.2, U7.5 (AIN2)
SG3+: IC6.4 (+IN), J3.5, R15.1
SG3-: IC6.1 (-IN), R16.2, R17.1
SG3_AMP: IC6.7 (VOUT), R22.1
SG3_FILTERED: C23.1, R22.2, U7.4 (AIN3_REFN1)

Notes on the sheet:
1.5k cutoff
352 (0.1%) accoutn with offset
gain
10mA max consumption
check it out again
ADC/DAC
filtering
Strain Guages
Instrument Amplifiers

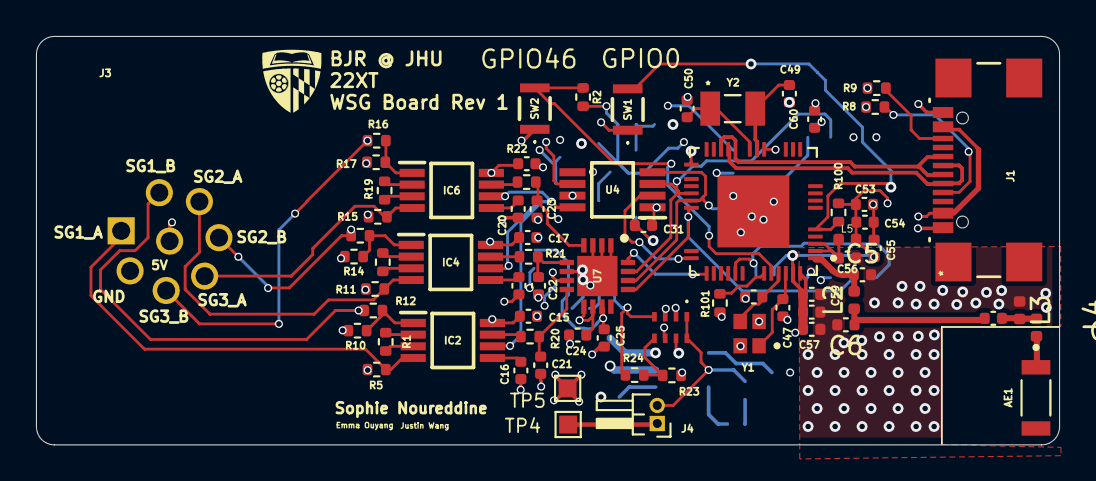
[picture p72: board WSG_2.0.kicad_pcb from above]

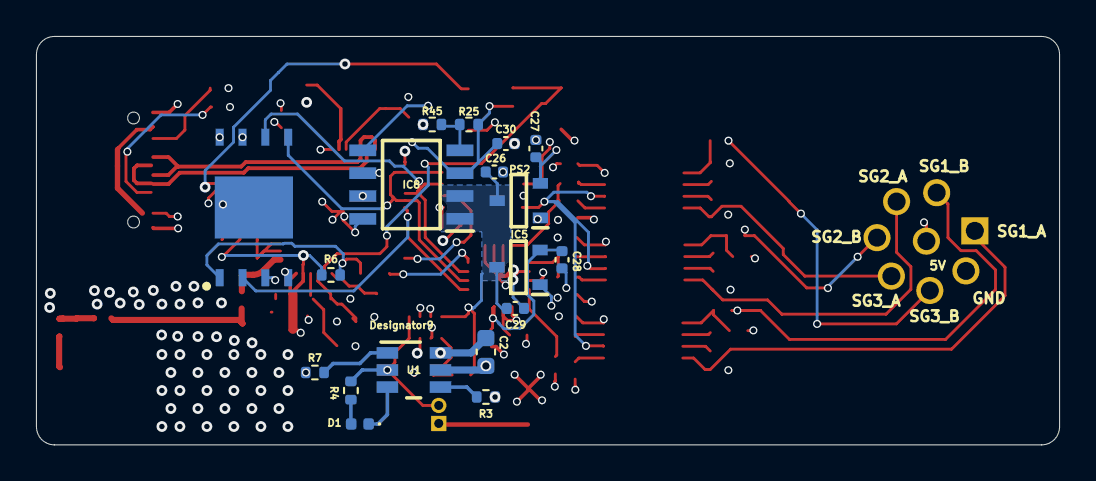
[picture p73: board WSG_2.0.kicad_pcb from below]

Board: 4 copper layers, 56.8 x 22.7 mm, 88 parts (18 on the bottom side), 58 nets.
