BlueJayRacing/22xt_kicad/01-main_board/main_board_v2/main_board_v2.kicad_pcb

## KiCad design 01-main_board/main_board_v2/main_board_v2.kicad_pcb (2026-01-04, an earlier design)

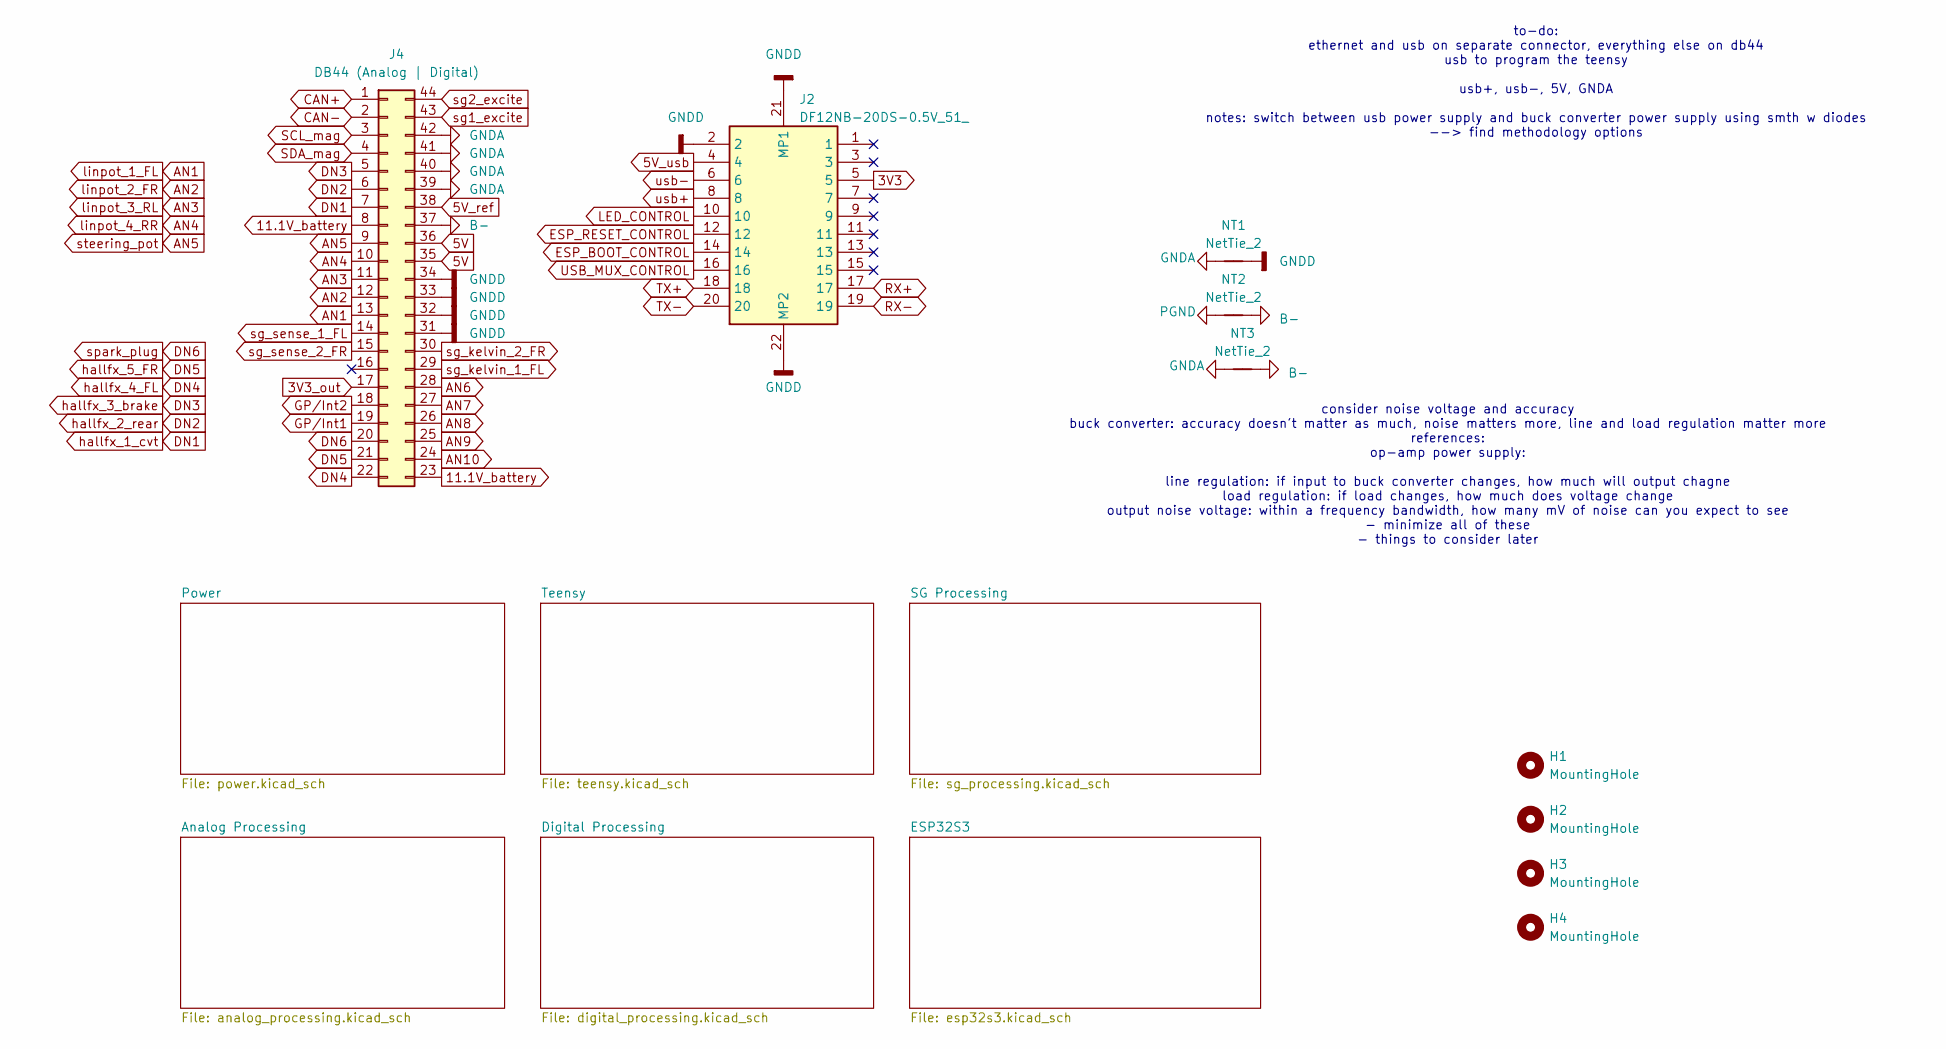
[picture p74: schematic main_board_v2.kicad_sch]

Parts:
H1, H2, H3, H4: MountingHole; MountingHole_3.2mm_M3_Pad
J2: DF12NB-20DS-0.5V_51_; DF12NB20DS05V51; Mouser Part Number 798-DF12NB20DS0551
J4: DB44 (Analog | Digital); aaren_mouser_db44_screws
NT1, NT2, NT3: NetTie_2; NetTie-2_SMD_Pad0.5mm

Connections:
2V5: J4.43, J4.44; also elsewhere on the board
3V3: J2.5; also elsewhere on the board
3V3_out: J4.17; also elsewhere on the board
5V: J4.35, J4.36; also elsewhere on the board
5V_ref: J4.38; also elsewhere on the board
5V_usb: J2.4; also elsewhere on the board
11.1V_battery: J4.8, J4.23; also elsewhere on the board
AN1: J4.13; also elsewhere on the board
AN2: J4.12; also elsewhere on the board
AN3: J4.11; also elsewhere on the board
AN4: J4.10; also elsewhere on the board
AN5: J4.9; also elsewhere on the board
AN6: J4.28; also elsewhere on the board
AN7: J4.27; also elsewhere on the board
AN8: J4.26; also elsewhere on the board
AN9: J4.25; also elsewhere on the board
AN10: J4.24; also elsewhere on the board
B-: J4.37, NT2.2, NT3.2
CAN+: J4.1; also elsewhere on the board
CAN-: J4.2; also elsewhere on the board
DN1: J4.7; also elsewhere on the board
DN2: J4.6; also elsewhere on the board
DN3: J4.5; also elsewhere on the board
DN4: J4.22; also elsewhere on the board
DN5: J4.21; also elsewhere on the board
DN6: J4.20; also elsewhere on the board
ESP_BOOT_CONTROL: J2.14; also elsewhere on the board
ESP_RESET_CONTROL: J2.12; also elsewhere on the board
GNDA: J4.39, J4.40, J4.41, J4.42, NT1.1, NT3.1; also elsewhere on the board
GNDD: J2.2, J2.21 (MP1), J2.22 (MP2), J4.31, J4.32, J4.33, J4.34, NT1.2; also elsewhere on the board
GP/Int1: J4.19; also elsewhere on the board
GP/Int2: J4.18; also elsewhere on the board
LED_CONTROL: J2.10
PGND: NT2.1; also elsewhere on the board
RX+: J2.17; also elsewhere on the board
RX-: J2.19; also elsewhere on the board
SCL_mag: J4.3; also elsewhere on the board
SDA_mag: J4.4; also elsewhere on the board
TX+: J2.18; also elsewhere on the board
TX-: J2.20; also elsewhere on the board
USB_MUX_CONTROL: J2.16; also elsewhere on the board
sg1+: J4.29; also elsewhere on the board
sg2+: J4.30; also elsewhere on the board
sg_sense_1_FL: J4.14; also elsewhere on the board
sg_sense_2_FR: J4.15; also elsewhere on the board
usb+: J2.8; also elsewhere on the board
usb-: J2.6; also elsewhere on the board

Notes on the sheet:
consider noise voltage and accuracy buck converter: accuracy doesn't matter as much, noise matters more, line and load regulation matter more references: op-amp power supply: line regulation: if input to buck converter changes, how much will output chagne load regulation: if load changes, how much 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
to-do: ethernet and usb on separate connector, everything else on db44 usb to program the teensy usb+, usb-, 5V, GNDA notes: switch between usb power supply and buck converter power supply using smth w diodes --> find methodology options

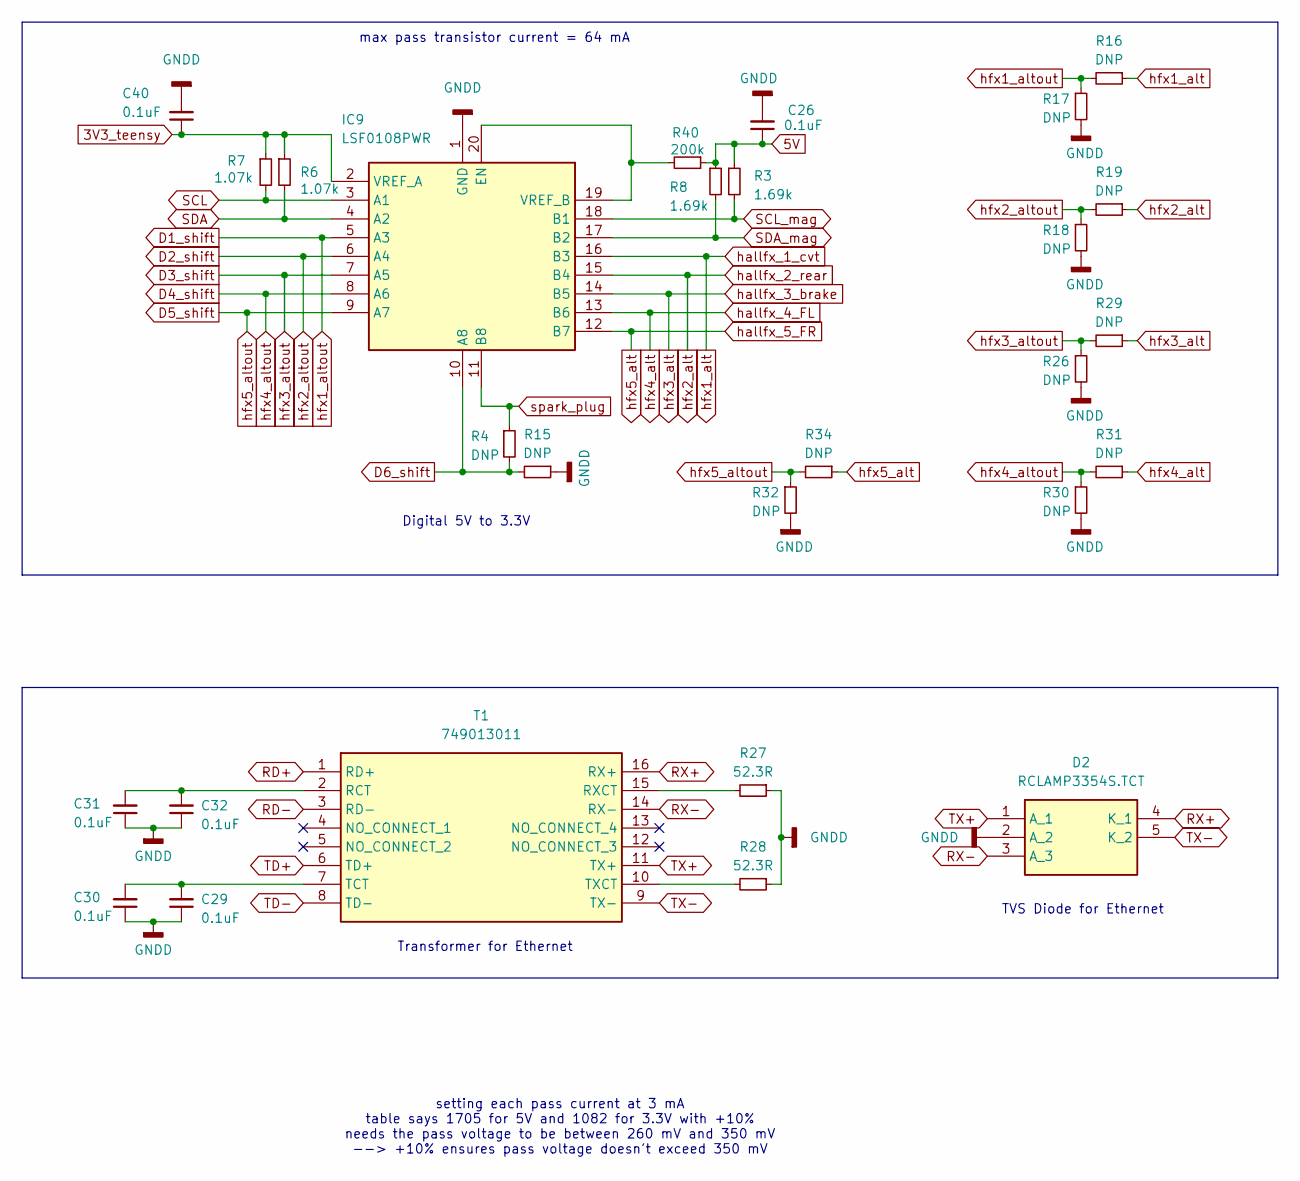
[picture p75: schematic digital_processing.kicad_sch]

Parts:
C26, C29, C30, C31, C32, C40: 0.1uF; C_0402_1005Metric
D2: RCLAMP3354S.TCT; SOT-23-5; Mouser Part Number 947-RCLAMP3354S.TCT
IC9: LSF0108PWR; SOP65P640X120-20N; Mouser Part Number 595-LSF0108RKSR
R3, R8: 1.69k; R_0402_1005Metric
R4, R15, R16, R17, R18, R19, R26, R29, R30, R31, R32, R34: DNP; R_0402_1005Metric
R6, R7: 1.07k; R_0402_1005Metric
R27, R28: 52.3R; R_0402_1005Metric
R40: 200k; R_0402_1005Metric
T1: 749013011; Mouser Part Number 710-749013011

Connections:
3V3_teensy: C40.1, IC9.2 (VREF_A), R6.1, R7.1; also elsewhere on the board
5V: C26.1, R3.1, R8.1, R40.1; also elsewhere on the board
D1_shift: IC9.5 (A3), R16.2, R17.1; also elsewhere on the board
D2_shift: IC9.6 (A4), R18.1, R19.2; also elsewhere on the board
D3_shift: IC9.7 (A5), R26.1, R29.2; also elsewhere on the board
D4_shift: IC9.8 (A6), R30.1, R31.2; also elsewhere on the board
D5_shift: IC9.9 (A7), R32.1, R34.2; also elsewhere on the board
D6_shift: IC9.10 (A8), R4.2, R15.2; also elsewhere on the board
DN1: IC9.16 (B3), R16.1; also elsewhere on the board
DN2: IC9.15 (B4), R19.1; also elsewhere on the board
DN3: IC9.14 (B5), R29.1; also elsewhere on the board
DN4: IC9.13 (B6), R31.1; also elsewhere on the board
DN5: IC9.12 (B7), R34.1; also elsewhere on the board
DN6: IC9.11 (B8), R4.1; also elsewhere on the board
GNDD: C26.2, C29.1, C30.1, C31.1, C32.1, C40.2, D2.2 (A_2), IC9.1 (GND), R15.1, R17.2, R18.2, R26.2, R27.1, R28.1, R30.2, R32.2; also elsewhere on the board
unnamed: IC9.19 (VREF_B), IC9.20 (EN), R40.2
unnamed: C31.2, C32.2, T1.2 (RCT)
unnamed: R27.2, T1.15 (RXCT)
unnamed: C29.2, C30.2, T1.7 (TCT)
unnamed: R28.2, T1.10 (TXCT)
RD+: T1.1 (RD+); also elsewhere on the board
RD-: T1.3 (RD-); also elsewhere on the board
RX+: D2.4 (K_1), T1.16 (RX+); also elsewhere on the board
RX-: D2.3 (A_3), T1.14 (RX-); also elsewhere on the board
SCL: IC9.3 (A1), R7.2; also elsewhere on the board
SCL_mag: IC9.18 (B1), R3.2; also elsewhere on the board
SDA: IC9.4 (A2), R6.2; also elsewhere on the board
SDA_mag: IC9.17 (B2), R8.2; also elsewhere on the board
TD+: T1.6 (TD+); also elsewhere on the board
TD-: T1.8 (TD-); also elsewhere on the board
TX+: D2.1 (A_1), T1.11 (TX+); also elsewhere on the board
TX-: D2.5 (K_2), T1.9 (TX-); also elsewhere on the board

Notes on the sheet:
Transformer for Ethernet
max pass transistor current = 64 mA
Digital 5V to 3.3V
TVS Diode for Ethernet
setting each pass current at 3 mA table says 1705 for 5V and 1082 for 3.3V with +10% needs the pass voltage to be between 260 mV and 350 mV --> +10% ensures pass voltage doesn't exceed 350 mV

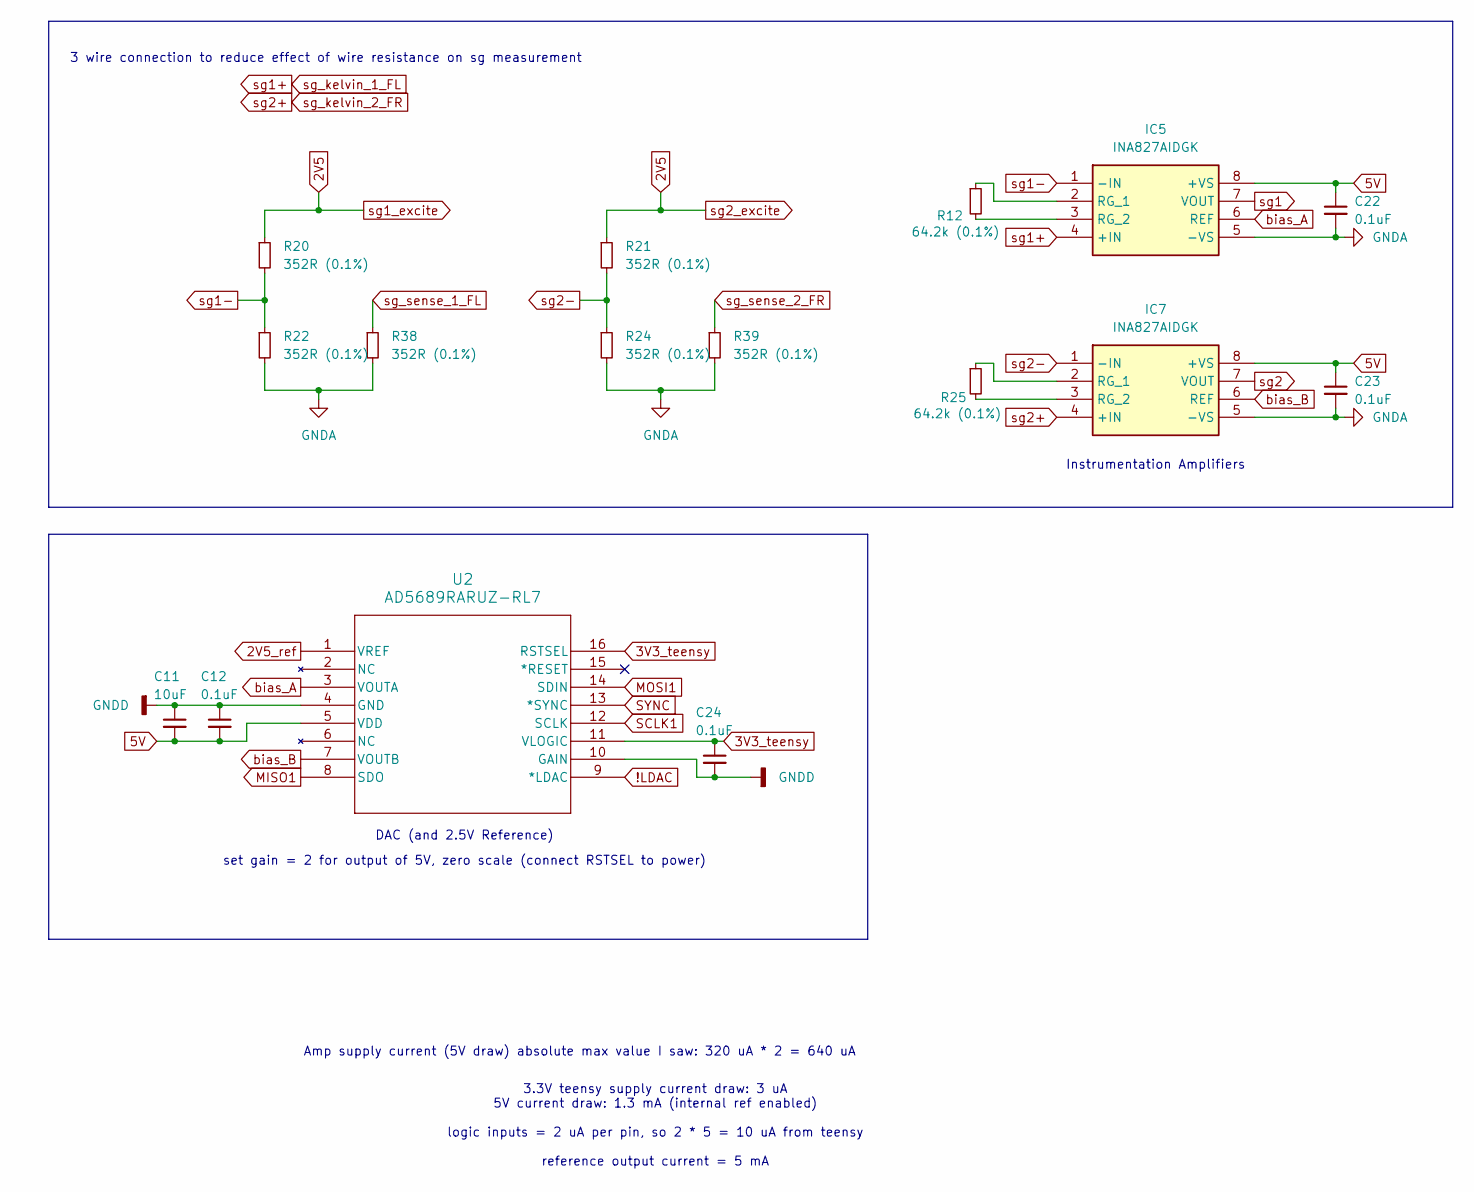
[picture p76: schematic sg_processing.kicad_sch]

Parts:
C11: 10uF; C_0402_1005Metric
C12, C22, C23, C24: 0.1uF; C_0402_1005Metric
IC5, IC7: INA827AIDGK; SOP65P490X110-8N; Mouser Part Number 595-INA827AIDGK
R12, R25: 64.2k (0.1%); R_0402_1005Metric
R20, R21, R22, R24, R38, R39: 352R (0.1%); R_0402_1005Metric
U2: AD5689RARUZ-RL7; RU_16_ADI

Connections:
2V5: R20.1, R21.1; also elsewhere on the board
2V5_ref: U2.1 (VREF); also elsewhere on the board
3V3_teensy: C24.1, U2.11 (VLOGIC), U2.16 (RSTSEL); also elsewhere on the board
5V: C11.2, C12.2, C22.1, C23.1, IC5.8 (+VS), IC7.8 (+VS), U2.5 (VDD); also elsewhere on the board
!LDAC: U2.9 (*LDAC); also elsewhere on the board
GNDA: C22.2, C23.2, IC5.5 (-VS), IC7.5 (-VS), R22.2, R24.2, R38.2, R39.2; also elsewhere on the board
GNDD: C11.1, C12.1, C24.2, U2.4 (GND), U2.10 (GAIN); also elsewhere on the board
MISO1: U2.8 (SDO); also elsewhere on the board
MOSI1: U2.14 (SDIN); also elsewhere on the board
unnamed: IC5.2 (RG_1), R12.1
unnamed: IC5.3 (RG_2), R12.2
unnamed: IC7.2 (RG_1), R25.1
unnamed: IC7.3 (RG_2), R25.2
SCLK1: U2.12 (SCLK); also elsewhere on the board
SYNC: U2.13 (*SYNC); also elsewhere on the board
bias_A: IC5.6 (REF), U2.3 (VOUTA)
bias_B: IC7.6 (REF), U2.7 (VOUTB)
sg1: IC5.7 (VOUT); also elsewhere on the board
sg1+: IC5.4 (+IN); also elsewhere on the board
sg1-: IC5.1 (-IN), R20.2, R22.1
sg2: IC7.7 (VOUT); also elsewhere on the board
sg2+: IC7.4 (+IN); also elsewhere on the board
sg2-: IC7.1 (-IN), R21.2, R24.1
sg_sense_1_FL: R38.1; also elsewhere on the board
sg_sense_2_FR: R39.1; also elsewhere on the board

Notes on the sheet:
DAC (and 2.5V Reference)
Amp supply current (5V draw) absolute max value I saw: 320 uA * 2 = 640 uA
3.3V teensy supply current draw: 3 uA 5V current draw: 1.3 mA (internal ref enabled) logic inputs = 2 uA per pin, so 2 * 5 = 10 uA from teensy reference output current = 5 mA
set gain = 2 for output of 5V, zero scale (connect RSTSEL to power)
Instrumentation Amplifiers
3 wire connection to reduce effect of wire resistance on sg measurement

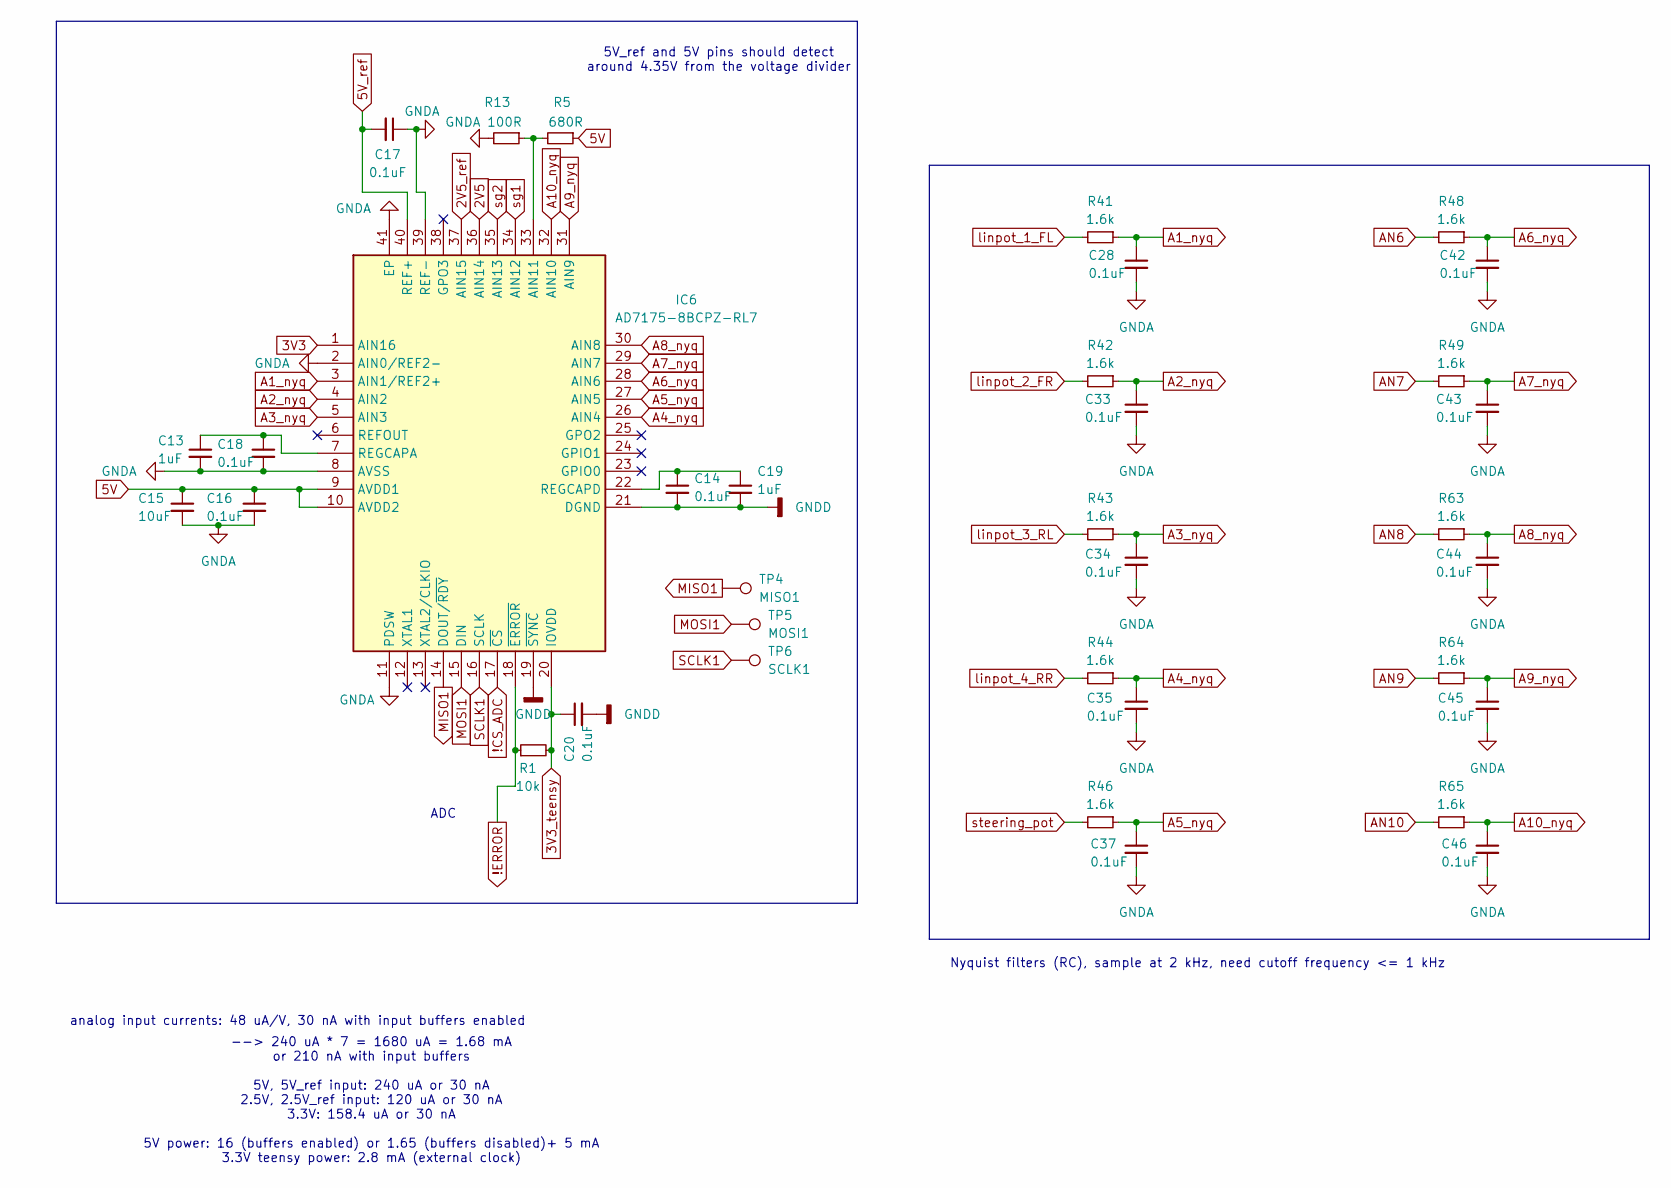
[picture p77: schematic analog_processing.kicad_sch]

Parts:
C13, C19: 1uF; C_0402_1005Metric
C14, C16, C17, C18, C20, C28, C33, C34, C35, C37, C42, C43, C44, C45, C46: 0.1uF; C_0402_1005Metric
C15: 10uF; C_0402_1005Metric
IC6: AD7175-8BCPZ-RL7; QFN50P600X600X80-41N-D; Mouser Part Number 584-AD7175-8BCPZ-RL7
R1: 10k; R_0402_1005Metric
R5: 680R; R_0402_1005Metric
R13: 100R; R_0402_1005Metric
R41, R42, R43, R44, R46, R48, R49, R63, R64, R65: 1.6k; R_0402_1005Metric
TP4: MISO1; TestPoint_Pad_1.0x1.0mm
TP5: MOSI1; TestPoint_Pad_1.0x1.0mm
TP6: SCLK1; TestPoint_Pad_1.0x1.0mm

Connections:
2V5: IC6.36 (AIN14); also elsewhere on the board
2V5_ref: IC6.37 (AIN15); also elsewhere on the board
3V3: IC6.1 (AIN16); also elsewhere on the board
3V3_teensy: C20.1, IC6.20 (IOVDD), R1.2; also elsewhere on the board
5V: C15.1, C16.1, IC6.9 (AVDD1), IC6.10 (AVDD2), R5.1; also elsewhere on the board
5V_ref: C17.2, IC6.40 (REF+); also elsewhere on the board
!CS_ADC: IC6.17 (~CS); also elsewhere on the board
!ERROR: IC6.18 (~ERROR), R1.1; also elsewhere on the board
A1_nyq: C28.1, IC6.3 (AIN1/REF2+), R41.1
A2_nyq: C33.1, IC6.4 (AIN2), R42.1
A3_nyq: C34.1, IC6.5 (AIN3), R43.1
A4_nyq: C35.1, IC6.26 (AIN4), R44.1
A5_nyq: C37.1, IC6.27 (AIN5), R46.1
A6_nyq: C42.1, IC6.28 (AIN6), R48.1
A7_nyq: C43.1, IC6.29 (AIN7), R49.1
A8_nyq: C44.1, IC6.30 (AIN8), R63.1
A9_nyq: C45.1, IC6.31 (AIN9), R64.1
A10_nyq: C46.1, IC6.32 (AIN10), R65.1
AN1: R41.2; also elsewhere on the board
AN2: R42.2; also elsewhere on the board
AN3: R43.2; also elsewhere on the board
AN4: R44.2; also elsewhere on the board
AN5: R46.2; also elsewhere on the board
AN6: R48.2; also elsewhere on the board
AN7: R49.2; also elsewhere on the board
AN8: R63.2; also elsewhere on the board
AN9: R64.2; also elsewhere on the board
AN10: R65.2; also elsewhere on the board
GNDA: C13.2, C15.2, C16.2, C17.1, C18.2, C28.2, C33.2, C34.2, C35.2, C37.2, C42.2, C43.2, C44.2, C45.2, C46.2, IC6.2 (AIN0/REF2-), IC6.8 (AVSS), IC6.11 (PDSW), IC6.39 (REF-), IC6.41 (EP), R13.2; also elsewhere on the board
GNDD: C14.2, C19.2, C20.2, IC6.19 (~SYNC), IC6.21 (DGND); also elsewhere on the board
MISO1: IC6.14 (DOUT/~RDY), TP4.1; also elsewhere on the board
MOSI1: IC6.15 (DIN), TP5.1; also elsewhere on the board
unnamed: IC6.33 (AIN11), R5.2, R13.1
unnamed: C13.1, C18.1, IC6.7 (REGCAPA)
unnamed: C14.1, C19.1, IC6.22 (REGCAPD)
SCLK1: IC6.16 (SCLK), TP6.1; also elsewhere on the board
sg1: IC6.34 (AIN12); also elsewhere on the board
sg2: IC6.35 (AIN13); also elsewhere on the board

Notes on the sheet:
ADC
--> 240 uA * 7 = 1680 uA = 1.68 mA or 210 nA with input buffers 5V, 5V_ref input: 240 uA or 30 nA 2.5V, 2.5V_ref input: 120 uA or 30 nA 3.3V: 158.4 uA or 30 nA 5V power: 16 (buffers enabled) or 1.65 (buffers disabled)+ 5 mA 3.3V teensy power: 2.8 mA (external clock)
analog input currents: 48 uA/V, 30 nA with input buffers enabled
Nyquist filters (RC), sample at 2 kHz, need cutoff frequency <= 1 kHz
5V_ref and 5V pins should detect around 4.35V from the voltage divider

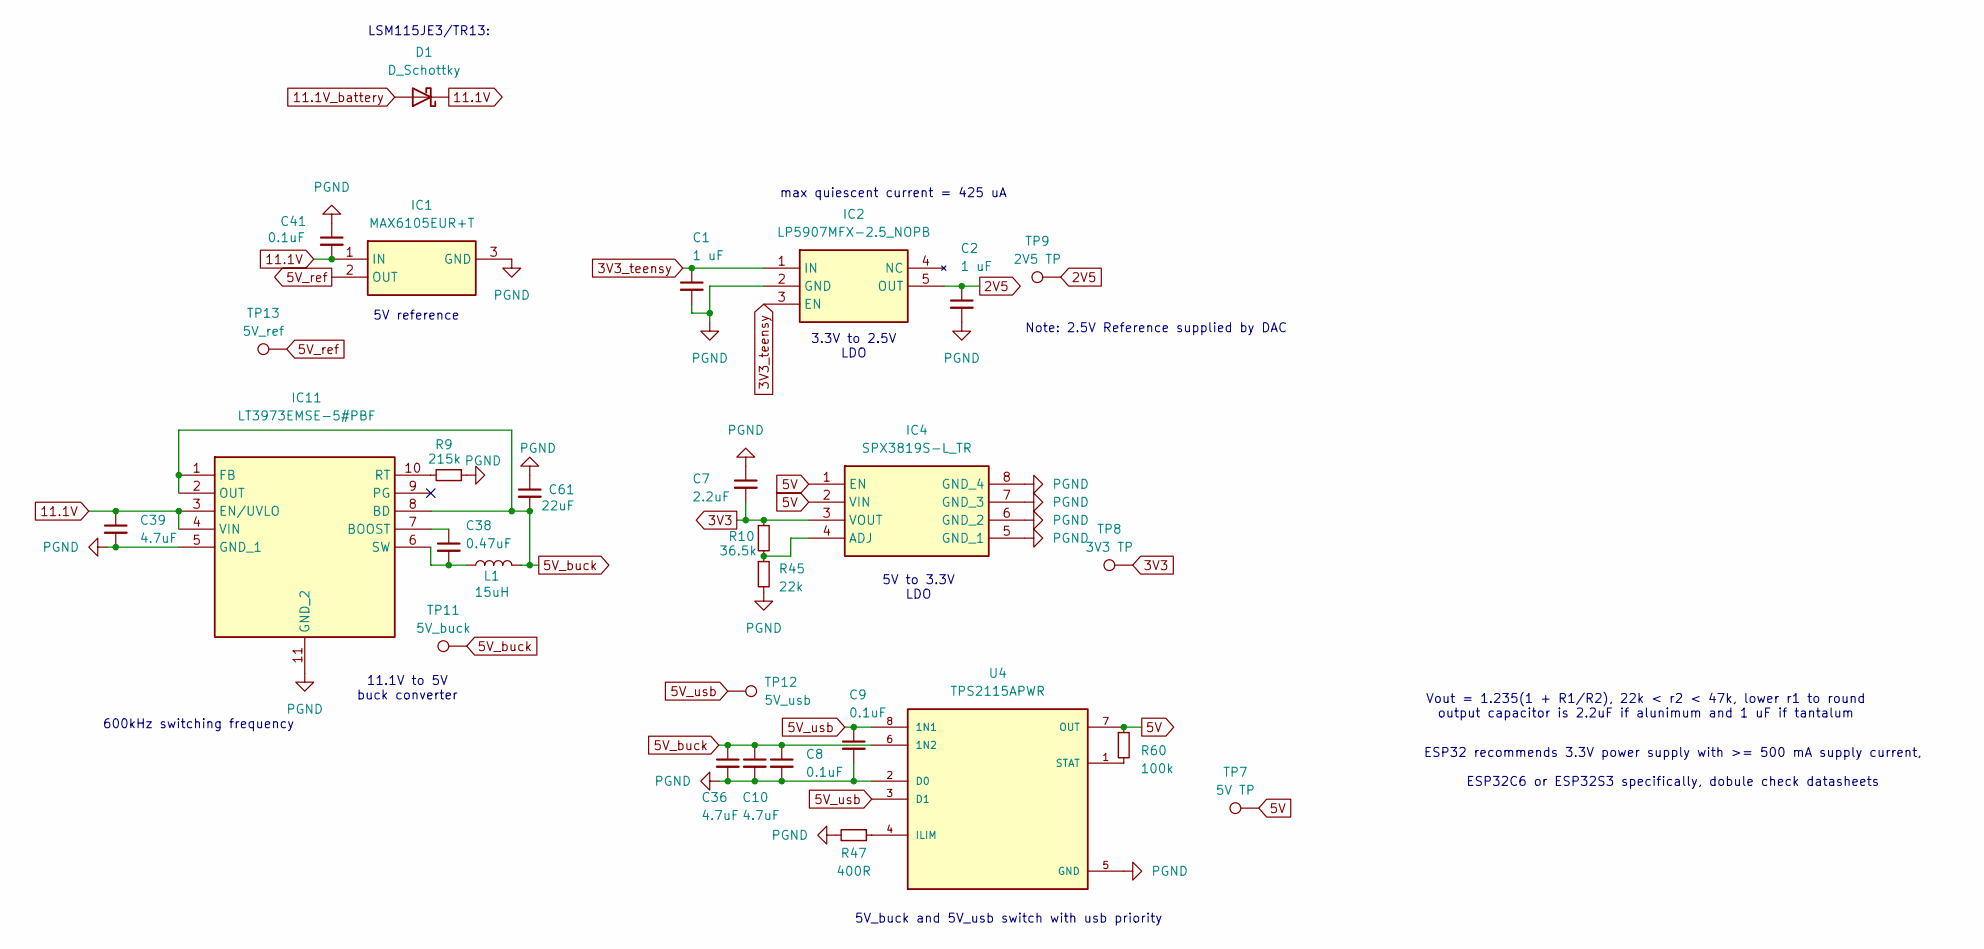
[picture p78: schematic power.kicad_sch]

Parts:
C1, C2: 1 uF; C_0402_1005Metric
C7: 2.2uF; C_0402_1005Metric
C8, C9, C41: 0.1uF; C_0402_1005Metric
C10, C36, C39: 4.7uF; C_0402_1005Metric
C38: 0.47uF; C_0402_1005Metric
C61: 22uF; C_0402_1005Metric
D1: D_Schottky; DO-214BA_MCH
IC1: MAX6105EUR+T; SOT-23-3; Mouser Part Number 700-MAX6105EURT
IC2: LP5907MFX-2.5_NOPB; SOT-23-5; Mouser Part Number 595-LP5907MFX2.5NOPB
IC4: SPX3819S-L_TR; SOIC127P600X175-8N; Mouser Part Number 701-SPX3819S-L/TR
IC11: LT3973EMSE-5#PBF; SOP50P490X110-11N; Mouser Part Number 584-LT3973EMSE-5#PBF
L1: 15uH; NRS4012T150MDGJ
R9: 215k; R_0402_1005Metric
R10: 36.5k; R_0402_1005Metric
R45: 22k; R_0402_1005Metric
R47: 400R; R_0402_1005Metric
R60: 100k; R_0402_1005Metric
TP7: 5V TP; TestPoint_Pad_1.0x1.0mm
TP8: 3V3 TP; TestPoint_Pad_1.0x1.0mm
TP9: 2V5 TP; TestPoint_Pad_1.0x1.0mm
TP11: 5V_buck; TestPoint_Pad_1.0x1.0mm
TP12: 5V_usb; TestPoint_Pad_1.0x1.0mm
TP13: 5V_ref; TestPoint_Pad_1.0x1.0mm
U4: TPS2115APWR; SOP65P640X120-8N; PARTREV F

Connections:
2V5: C2.1, IC2.5 (OUT), TP9.1; also elsewhere on the board
3V3: C7.2, IC4.3 (VOUT), R10.1, TP8.1; also elsewhere on the board
3V3_teensy: C1.1, IC2.1 (IN), IC2.3 (EN); also elsewhere on the board
5V: IC4.1 (EN), IC4.2 (VIN), R60.1, TP7.1, U4.7 (OUT); also elsewhere on the board
5V_buck: C8.1, C10.1, C36.1, C61.2, IC11.1 (FB), IC11.2 (OUT), IC11.8 (BD), L1.2, TP11.1, U4.6 (1N2); also elsewhere on the board
5V_ref: IC1.2 (OUT), TP13.1; also elsewhere on the board
5V_usb: C9.1, TP12.1, U4.3 (D1), U4.8 (1N1); also elsewhere on the board
11.1V: C39.1, C41.2, D1.1 (K), IC1.1 (IN), IC11.3 (EN/UVLO), IC11.4 (VIN)
11.1V_battery: D1.2 (A); also elsewhere on the board
unnamed: IC4.4 (ADJ), R10.2, R45.1
unnamed: C38.1, IC11.7 (BOOST)
unnamed: IC11.10 (RT), R9.2
unnamed: C38.2, IC11.6 (SW), L1.1
unnamed: R47.1, U4.4 (ILIM)
unnamed: R60.2, U4.1 (STAT)
PGND: C1.2, C2.2, C7.1, C8.2, C9.2, C10.2, C36.2, C39.2, C41.1, C61.1, IC1.3 (GND), IC2.2 (GND), IC4.5 (GND_1), IC4.6 (GND_2), IC4.7 (GND_3), IC4.8 (GND_4), IC11.5 (GND_1), IC11.11 (GND_2), R9.1, R45.2, R47.2, U4.2 (D0), U4.5 (GND); also elsewhere on the board

Notes on the sheet:
5V reference
LSM115JE3/TR13:
5V to 3.3V LDO
11.1V to 5V buck converter
5V_buck and 5V_usb switch with usb priority
max quiescent current = 425 uA
ESP32 recommends 3.3V power supply with >= 500 mA supply current, ESP32C6 or ESP32S3 specifically, dobule check datasheets
Vout = 1.235(1 + R1/R2), 22k < r2 < 47k, lower r1 to round output capacitor is 2.2uF if alunimum and 1 uF if tantalum
3.3V to 2.5V LDO
Note: 2.5V Reference supplied by DAC
600kHz switching frequency

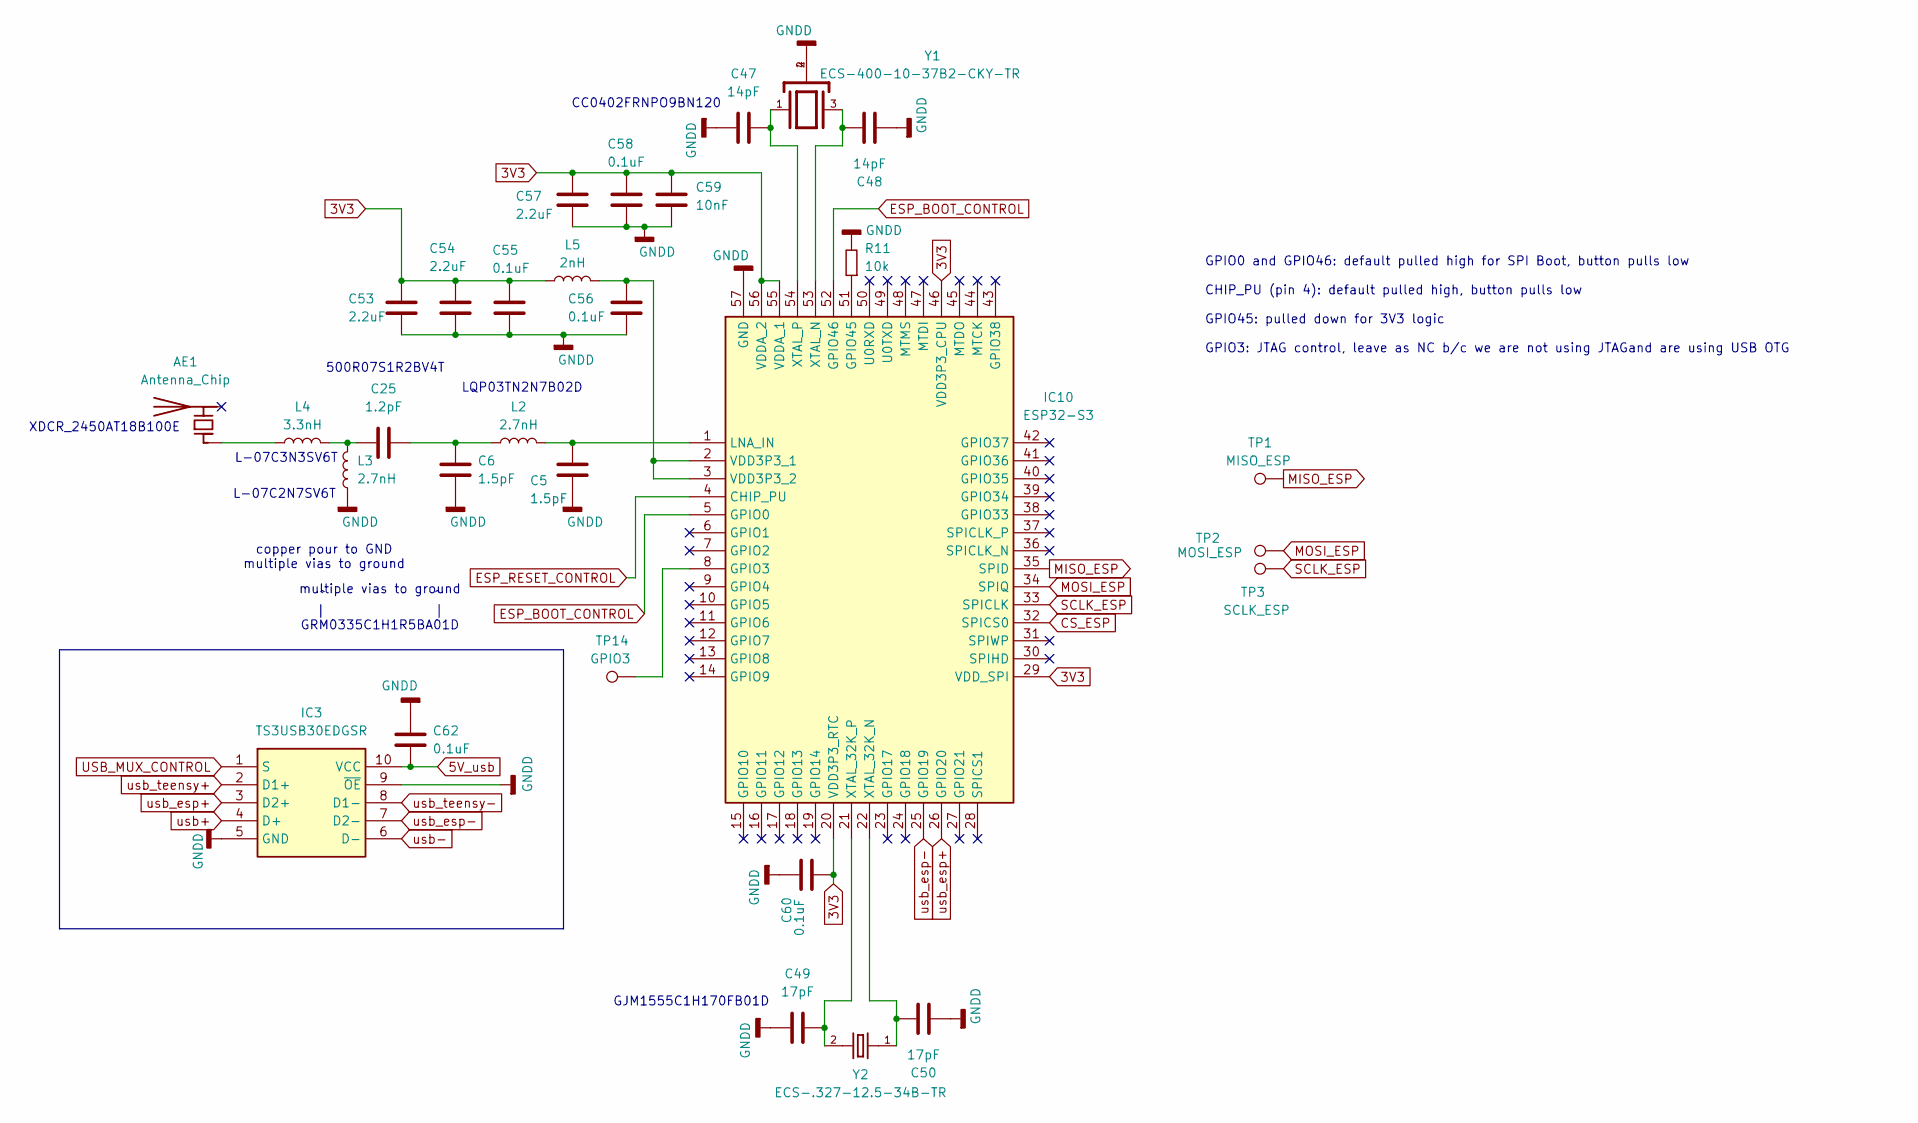
[picture p79: schematic esp32s3.kicad_sch]

Parts:
AE1: Antenna_Chip; XDCR_2450AT18B100E
C5, C6: 1.5pF; C_0603_1608Metric
C25: 1.2pF; C_0402_1005Metric
C47, C48: 14pF; C_0402_1005Metric
C49, C50: 17pF; C_0402_1005Metric
C53, C54, C57: 2.2uF; C_0402_1005Metric
C55, C56, C58, C60, C62: 0.1uF; C_0402_1005Metric
C59: 10nF; C_0402_1005Metric
IC3: TS3USB30EDGSR; SOP50P490X110-10N; Mouser Part Number 595-TS3USB30EDGSR
IC10: ESP32-S3; QFN40P700X700X90-57N-D; Mouser Part Number 356-ESP32-S3
L2: 2.7nH; L_0603_1608Metric
L3: 2.7nH; L_0402_1005Metric
L4: 3.3nH; L_0402_1005Metric
L5: 2nH; L_0402_1005Metric
R11: 10k; R_0402_1005Metric
TP1: MISO_ESP; TestPoint_Pad_1.0x1.0mm
TP2: MOSI_ESP; TestPoint_Pad_1.0x1.0mm
TP3: SCLK_ESP; TestPoint_Pad_1.0x1.0mm
TP14: GPIO3; TestPoint_Pad_1.0x1.0mm
Y1: ECS-400-10-37B2-CKY-TR; XTAL_ECS-400-10-37B2-CKY-TR; PARTREV 2021
Y2: ECS-.327-12.5-34B-TR; XTAL_ECS-.327-12.5-34B-TR

Connections:
3V3: C53.1, C54.1, C55.1, C57.1, C58.1, C59.1, C60.1, IC10.20 (VDD3P3_RTC), IC10.29 (VDD_SPI), IC10.46 (VDD3P3_CPU), IC10.55 (VDDA_1), IC10.56 (VDDA_2), L5.1; also elsewhere on the board
5V_usb: C62.2, IC3.10 (VCC); also elsewhere on the board
CS_ESP: IC10.32 (SPICS0); also elsewhere on the board
ESP_BOOT_CONTROL: IC10.5 (GPIO0), IC10.52 (GPIO46); also elsewhere on the board
ESP_RESET_CONTROL: IC10.4 (CHIP_PU); also elsewhere on the board
GNDD: C5.2, C6.2, C47.2, C48.2, C49.2, C50.2, C53.2, C54.2, C55.2, C56.2, C57.2, C58.2, C59.2, C60.2, C62.1, IC3.5 (GND), IC3.9 (~OE), IC10.57 (GND), L3.1, R11.2, Y1.2, Y1.4; also elsewhere on the board
MISO_ESP: IC10.35 (SPID), TP1.1; also elsewhere on the board
MOSI_ESP: IC10.34 (SPIQ), TP2.1; also elsewhere on the board
unnamed: AE1.1 (FEED), L4.1
unnamed: C25.1, L3.2, L4.2
unnamed: C6.1, C25.2, L2.1
unnamed: IC10.8 (GPIO3), TP14.1
unnamed: IC10.51 (GPIO45), R11.1
unnamed: C5.1, IC10.1 (LNA_IN), L2.2
unnamed: C56.1, IC10.2 (VDD3P3_1), IC10.3 (VDD3P3_2), L5.2
unnamed: C50.1, IC10.22 (XTAL_32K_N), Y2.1
unnamed: C49.1, IC10.21 (XTAL_32K_P), Y2.2
unnamed: C48.1, IC10.53 (XTAL_N), Y1.3
unnamed: C47.1, IC10.54 (XTAL_P), Y1.1
SCLK_ESP: IC10.33 (SPICLK), TP3.1; also elsewhere on the board
USB_MUX_CONTROL: IC3.1 (S); also elsewhere on the board
usb+: IC3.4 (D+); also elsewhere on the board
usb-: IC3.6 (D-); also elsewhere on the board
usb_esp+: IC3.3 (D2+), IC10.26 (GPIO20)
usb_esp-: IC3.7 (D2-), IC10.25 (GPIO19)
usb_teensy+: IC3.2 (D1+); also elsewhere on the board
usb_teensy-: IC3.8 (D1-); also elsewhere on the board

Notes on the sheet:
CC0402FRNPO9BN120
multiple vias to ground
500R07S1R2BV4T
L-07C3N3SV6T
L-07C2N7SV6T
LQP03TN2N7B02D
GJM1555C1H170FB01D
^ ^ | | GRM0335C1H1R5BA01D
XDCR_2450AT18B100E
copper pour to GND multiple vias to ground
GPIO0 and GPIO46: default pulled high for SPI Boot, button pulls low CHIP_PU (pin 4): default pulled high, button pulls low GPIO45: pulled down for 3V3 logic GPIO3: JTAG control, leave as NC b/c we are not using JTAGand are using USB OTG
