BlueJayRacing/22xt_kicad/01-main_board/main_board_v2/main_board_v2.kicad_pcb

## KiCad design 01-main_board/main_board_v2/main_board_v2.kicad_pcb (continued)

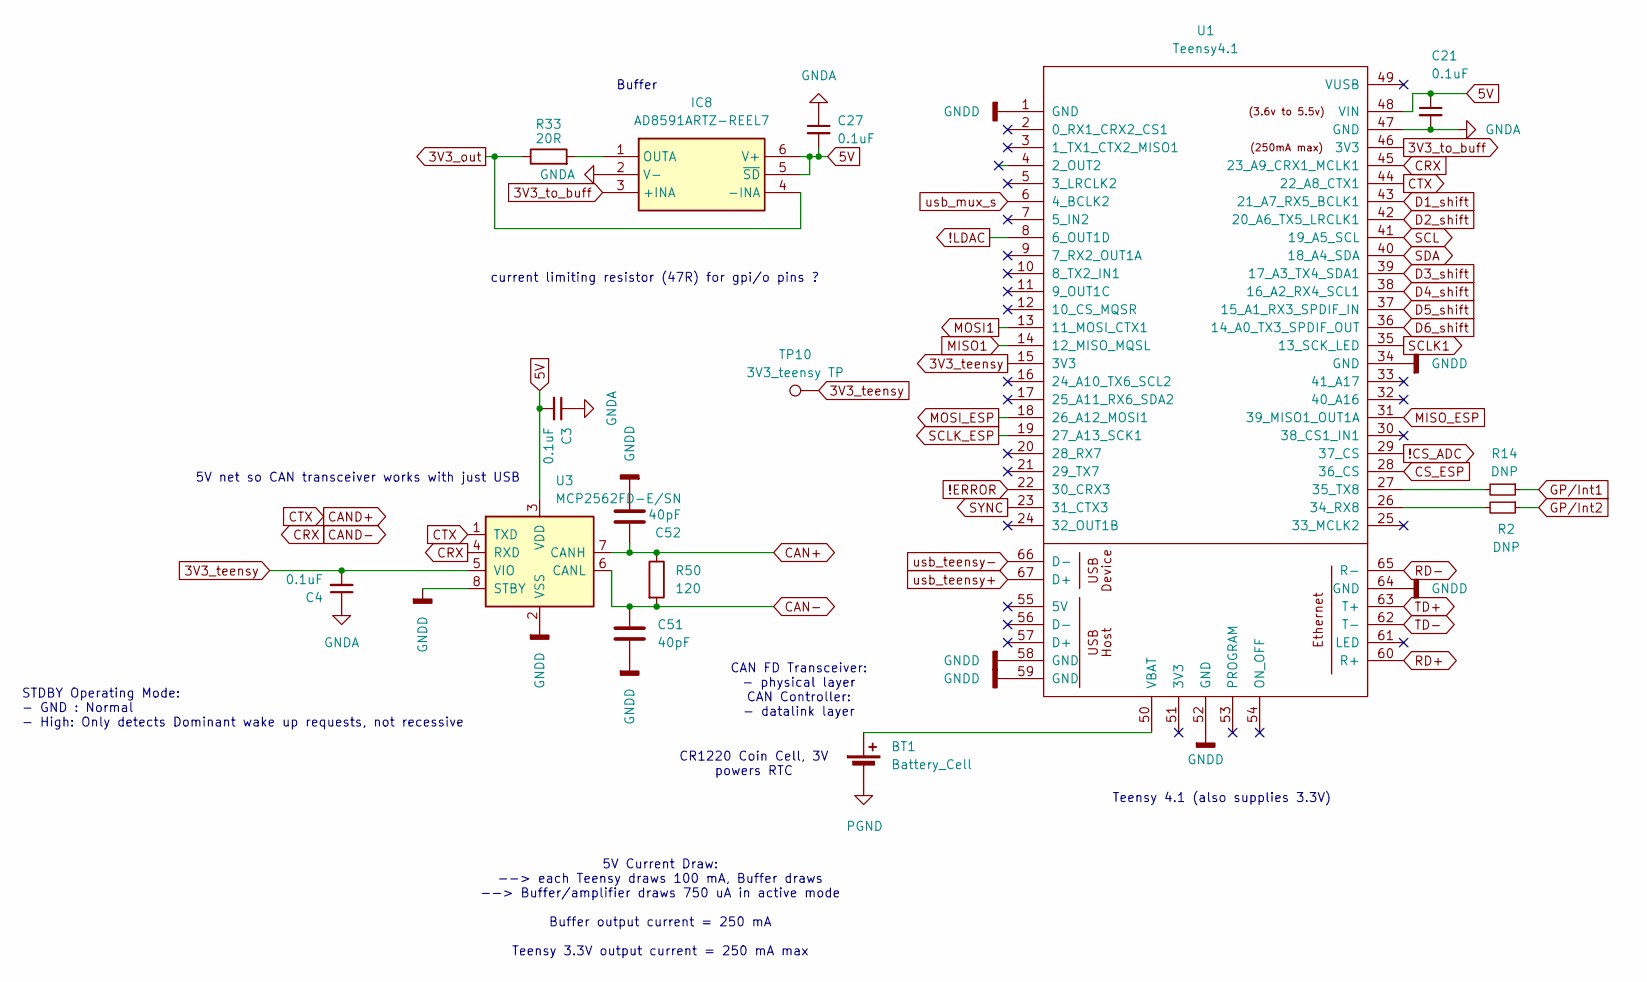
[picture p80: schematic teensy.kicad_sch]

Parts:
BT1: Battery_Cell; BatteryHolder_LINX_BAT-HLD-012-SMT
C3, C4, C21, C27: 0.1uF; C_0402_1005Metric
C51, C52: 40pF; C_0402_1005Metric
IC8: AD8591ARTZ-REEL7; SOT95P280X145-6N; Mouser Part Number 584-AD8591ARTZ-R7
R2, R14: DNP; R_0402_1005Metric
R33: 20R; R_0402_1005Metric
R50: 120; R_1206_3216Metric
TP10: 3V3_teensy TP; TestPoint_Pad_1.0x1.0mm
U1: Teensy4.1; Teensy41
U3: MCP2562FD-E/SN; SOIC-8_3.9x4.9mm_P1.27mm

Connections:
3V3_out: IC8.4 (-INA), R33.1; also elsewhere on the board
3V3_teensy: C4.2, TP10.1, U1.15 (3V3), U3.5 (VIO); also elsewhere on the board
3V3_to_buff: IC8.3 (+INA), U1.46 (3V3)
5V: C3.2, C21.1, C27.2, IC8.5 (~SD), IC8.6 (V+), U1.48 (VIN), U3.3 (VDD); also elsewhere on the board
!CS_ADC: U1.29 (37_CS); also elsewhere on the board
!ERROR: U1.22 (30_CRX3); also elsewhere on the board
!LDAC: U1.8 (6_OUT1D); also elsewhere on the board
CAN+: C52.1, R50.1, U3.7 (CANH); also elsewhere on the board
CAN-: C51.1, R50.2, U3.6 (CANL); also elsewhere on the board
CAND+: U1.44 (22_A8_CTX1), U3.1 (TXD)
CAND-: U1.45 (23_A9_CRX1_MCLK1), U3.4 (RXD)
CS_ESP: U1.28 (36_CS); also elsewhere on the board
D1_shift: U1.43 (21_A7_RX5_BCLK1); also elsewhere on the board
D2_shift: U1.42 (20_A6_TX5_LRCLK1); also elsewhere on the board
D3_shift: U1.39 (17_A3_TX4_SDA1); also elsewhere on the board
D4_shift: U1.38 (16_A2_RX4_SCL1); also elsewhere on the board
D5_shift: U1.37 (15_A1_RX3_SPDIF_IN); also elsewhere on the board
D6_shift: U1.36 (14_A0_TX3_SPDIF_OUT); also elsewhere on the board
GNDA: C3.1, C4.1, C21.2, C27.1, IC8.2 (V-), U1.47 (GND); also elsewhere on the board
GNDD: C51.2, C52.2, U1.1 (GND), U1.34 (GND), U1.52 (GND), U1.58 (GND), U1.59 (GND), U1.64 (GND), U3.2 (VSS), U3.8 (STBY); also elsewhere on the board
GP/Int1: R14.1; also elsewhere on the board
GP/Int2: R2.1; also elsewhere on the board
MISO1: U1.14 (12_MISO_MQSL); also elsewhere on the board
MISO_ESP: U1.31 (39_MISO1_OUT1A); also elsewhere on the board
MOSI1: U1.13 (11_MOSI_CTX1); also elsewhere on the board
MOSI_ESP: U1.18 (26_A12_MOSI1); also elsewhere on the board
unnamed: BT1.1 (+), U1.50 (VBAT)
unnamed: IC8.1 (OUTA), R33.2
unnamed: R2.2, U1.26 (34_RX8)
unnamed: R14.2, U1.27 (35_TX8)
PGND: BT1.2 (-); also elsewhere on the board
RD+: U1.60 (R+); also elsewhere on the board
RD-: U1.65 (R-); also elsewhere on the board
SCL: U1.41 (19_A5_SCL); also elsewhere on the board
SCLK1: U1.35 (13_SCK_LED); also elsewhere on the board
SCLK_ESP: U1.19 (27_A13_SCK1); also elsewhere on the board
SDA: U1.40 (18_A4_SDA); also elsewhere on the board
SYNC: U1.23 (31_CTX3); also elsewhere on the board
TD+: U1.63 (T+); also elsewhere on the board
TD-: U1.62 (T-); also elsewhere on the board
usb_mux_s: U1.6 (4_BCLK2)
usb_teensy+: U1.67 (D+); also elsewhere on the board
usb_teensy-: U1.66 (D-); also elsewhere on the board

Notes on the sheet:
Buffer
5V Current Draw: --> each Teensy draws 100 mA, Buffer draws --> Buffer/amplifier draws 750 uA in active mode Buffer output current = 250 mA Teensy 3.3V output current = 250 mA max
STDBY Operating Mode: - GND : Normal - High: Only detects Dominant wake up requests, not recessive
CR1220 Coin Cell, 3V powers RTC
Teensy 4.1 (also supplies 3.3V)
5V net so CAN transceiver works with just USB
CAN FD Transceiver: - physical layer CAN Controller: - datalink layer
current limiting resistor (47R) for gpi/o pins ?

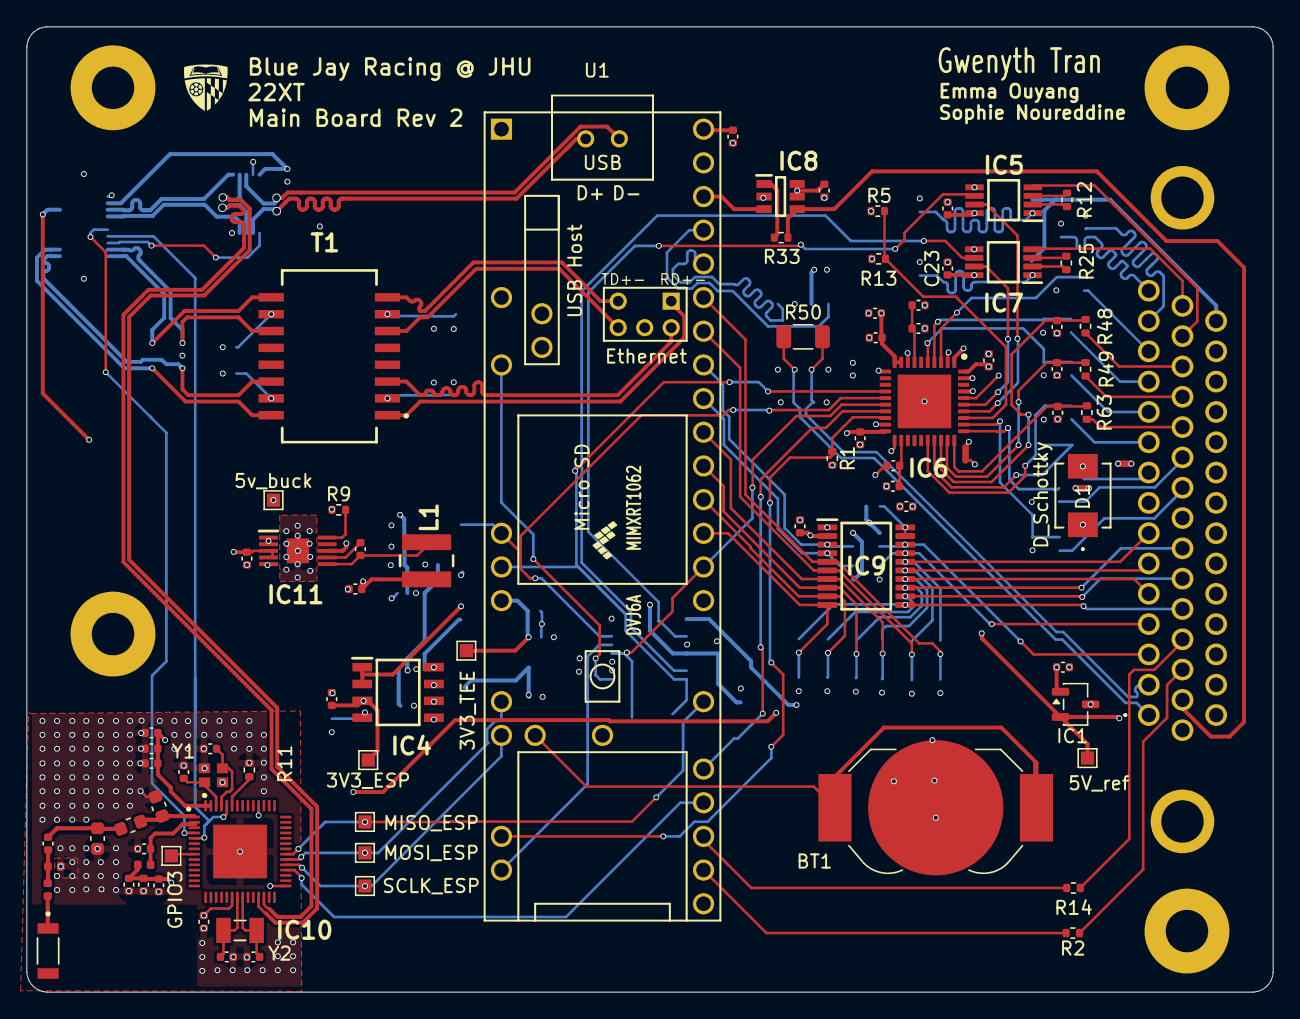
[picture p81: board main_board_v2.kicad_pcb from above]

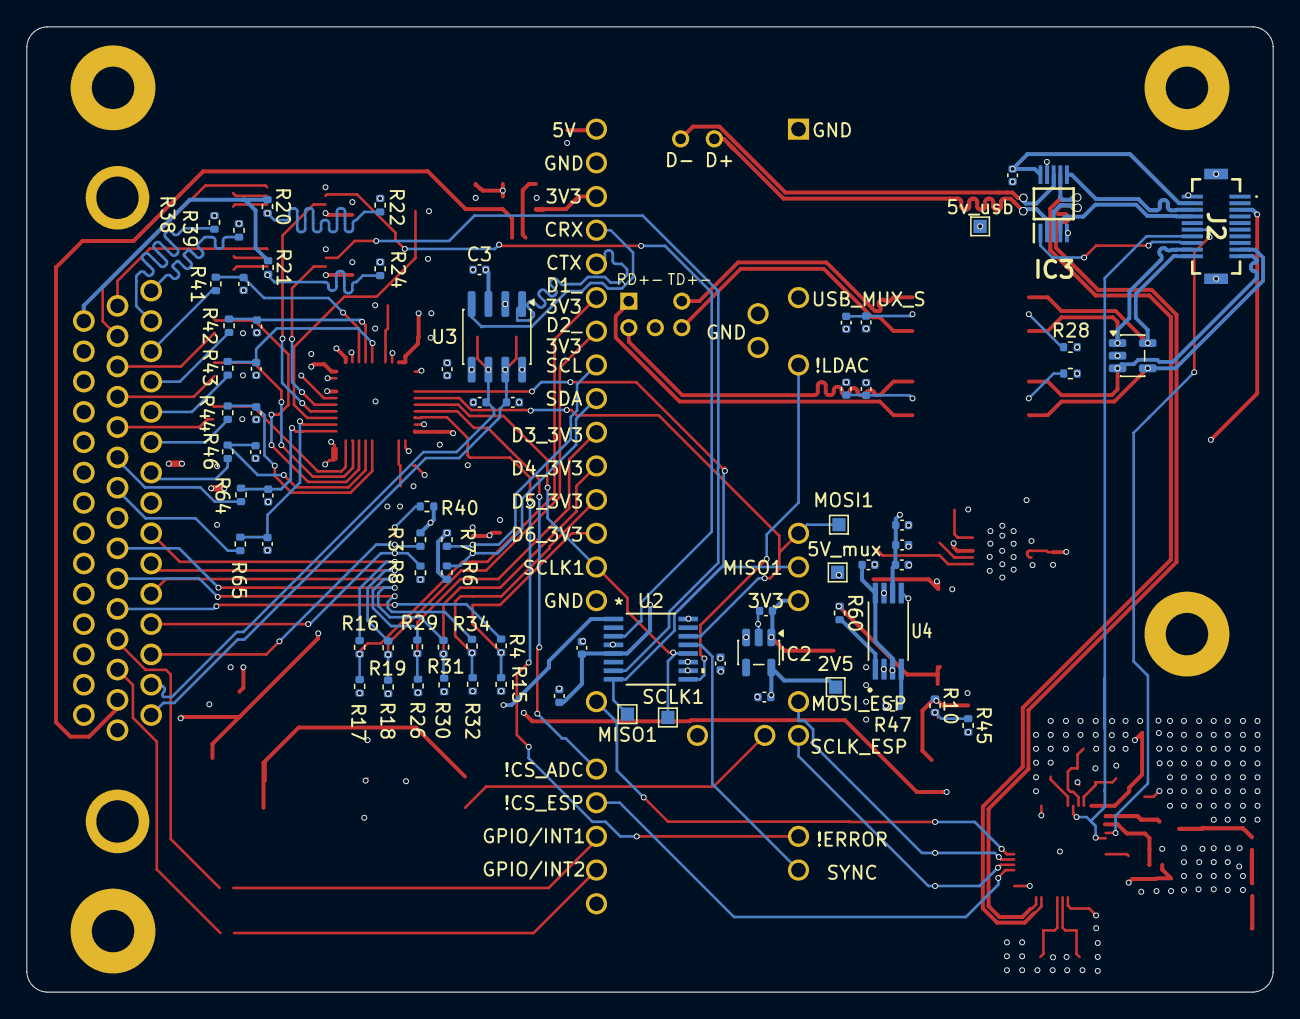
[picture p82: board main_board_v2.kicad_pcb from below]

Board: 4 copper layers, 94.0 x 72.8 mm, 162 parts (74 on the bottom side), 129 nets.

Other parts of the board:
2V5: 2V5 TP; TestPoint_Pad_1.0x1.0mm
5v_buck: 5V_buck; TestPoint_Pad_1.0x1.0mm
5v_usb: 5V_usb; TestPoint_Pad_1.0x1.0mm

Their connections:
2V5: 2V5.1; also elsewhere on the board
5V_buck: 5v_buck.1; also elsewhere on the board
5V_usb: 5v_usb.1; also elsewhere on the board
