BlueJayRacing/22xt_kicad/05-can_encoder/stm32f072cb-breakout/stm32f072cb_breakout/stm32f072cb_breakout.kicad_pcb

## KiCad design 05-can_encoder/stm32f072cb-breakout/stm32f072cb_breakout/stm32f072cb_breakout.kicad_pcb (2025-12-23)

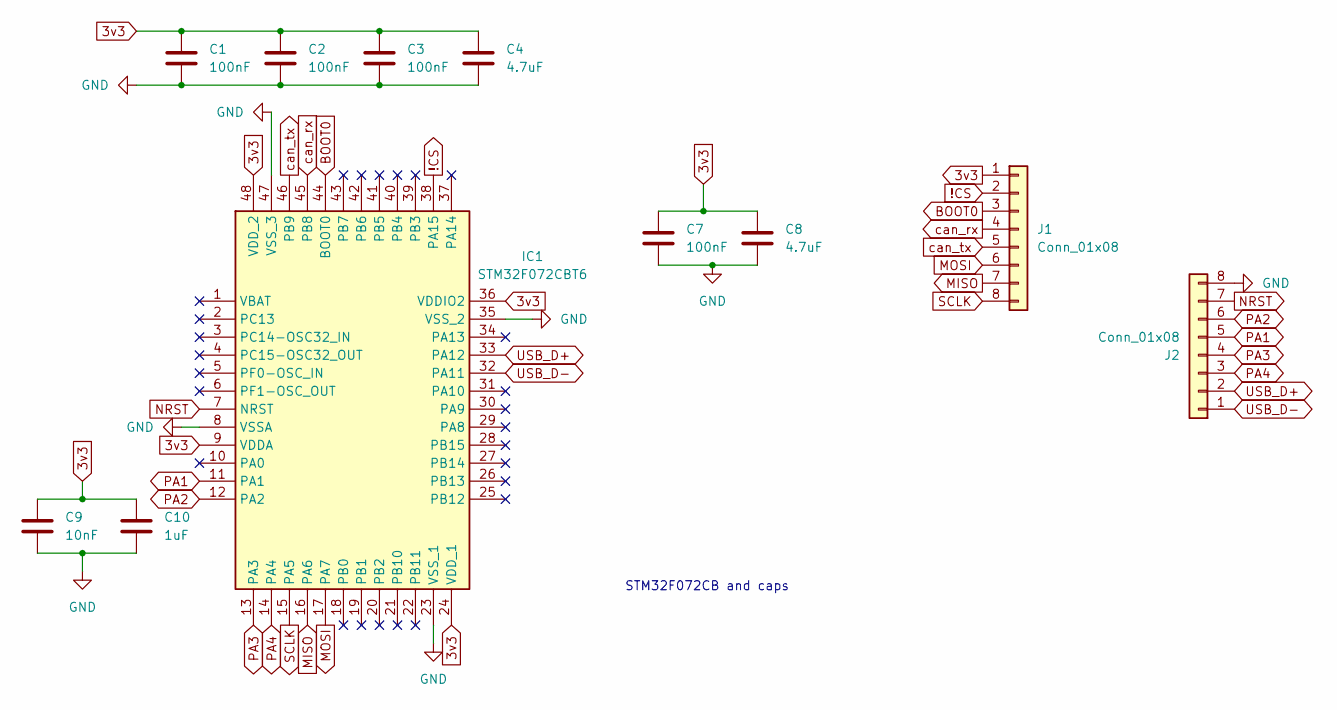
[picture p83: schematic stm32f072cb_breakout.kicad_sch]

Parts:
C1, C2, C3, C7: 100nF; C_0603_1608Metric
C4, C8: 4.7uF; C_0603_1608Metric
C9: 10nF; C_0603_1608Metric
C10: 1uF; C_0603_1608Metric
IC1: STM32F072CBT6; Mouser Part Number 511-STM32F072CBT6
J1, J2: Conn_01x08; PinHeader_1x08_P2.54mm_Vertical

Connections:
3v3: C1.1, C2.1, C3.1, C4.1, C7.1, C8.1, C9.1, C10.1, IC1.9 (VDDA), IC1.24 (VDD_1), IC1.36 (VDDIO2), IC1.48 (VDD_2), J1.1
!CS: IC1.38 (PA15), J1.2
BOOT0: IC1.44 (BOOT0), J1.3
GND: C1.2, C2.2, C3.2, C4.2, C7.2, C8.2, C9.2, C10.2, IC1.8 (VSSA), IC1.23 (VSS_1), IC1.35 (VSS_2), IC1.47 (VSS_3), J2.8
MISO: IC1.16 (PA6), J1.7
MOSI: IC1.17 (PA7), J1.6
NRST: IC1.7 (NRST), J2.7
PA1: IC1.11 (PA1), J2.5
PA2: IC1.12 (PA2), J2.6
PA3: IC1.13 (PA3), J2.4
PA4: IC1.14 (PA4), J2.3
SCLK: IC1.15 (PA5), J1.8
USB_D+: IC1.33 (PA12), J2.2
USB_D-: IC1.32 (PA11), J2.1
can_rx: IC1.45 (PB8), J1.4
can_tx: IC1.46 (PB9), J1.5

Notes on the sheet:
STM32F072CB and caps

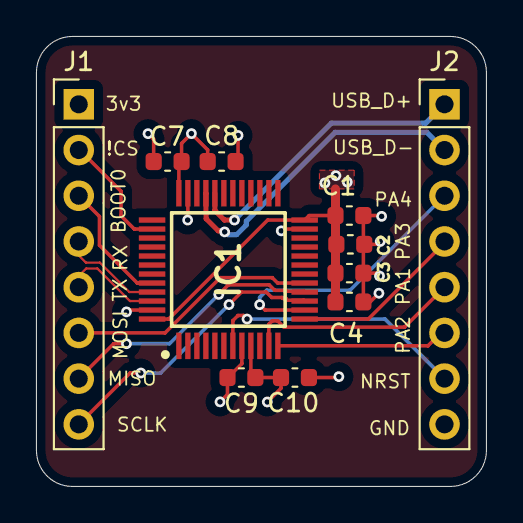
[picture p84: board stm32f072cb_breakout.kicad_pcb from above]

Board: 4 copper layers, 25.0 x 25.0 mm, 11 parts (0 on the bottom side), 16 nets.
