BlueJayRacing/22xt_kicad/05-can_encoder/as5047p-atsm_breakout/as5047p-atsm_breakout/as5047p-atsm_breakout.kicad_pcb

## KiCad design 05-can_encoder/as5047p-atsm_breakout/as5047p-atsm_breakout/as5047p-atsm_breakout.kicad_pcb (2025-12-23)

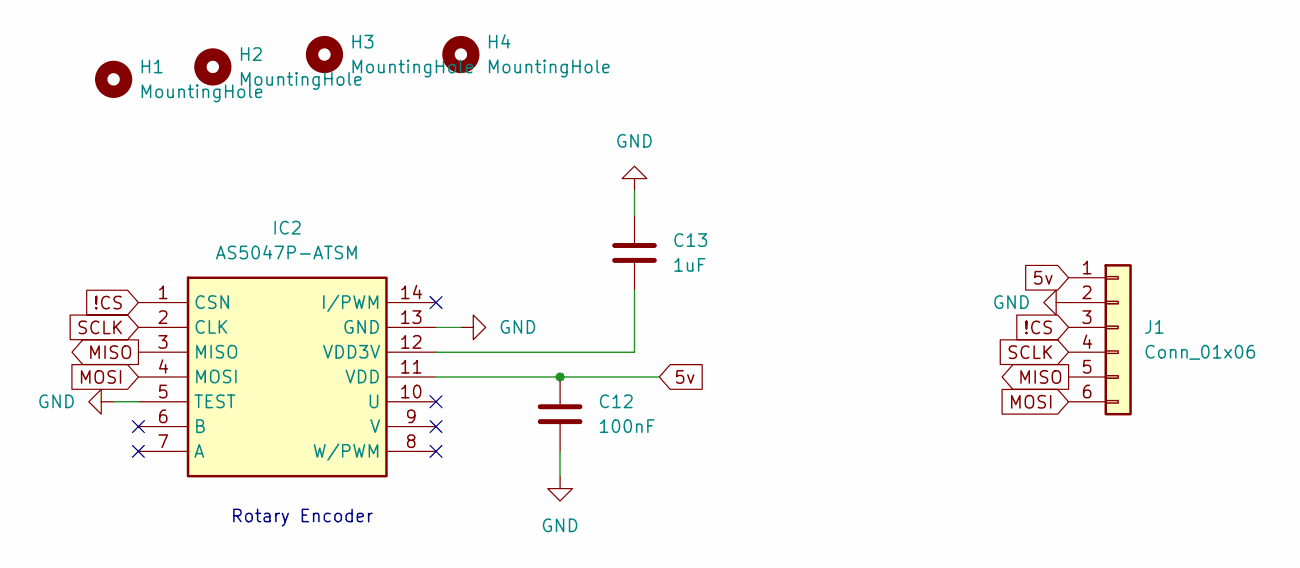
[picture p85: schematic as5047p-atsm_breakout.kicad_sch]

Parts:
C12: 100nF; C_0603_1608Metric
C13: 1uF; C_0603_1608Metric
H1, H2, H3, H4: MountingHole; MountingHole_2.2mm_M2
IC2: AS5047P-ATSM; Mouser Part Number 985-AS5047P-ATSM
J1: Conn_01x06; PinHeader_1x06_P2.54mm_Vertical

Connections:
5v: C12.1, IC2.11 (VDD), J1.1
!CS: IC2.1 (CSN), J1.3
GND: C12.2, C13.2, IC2.5 (TEST), IC2.13 (GND), J1.2
MISO: IC2.3 (MISO), J1.5
MOSI: IC2.4 (MOSI), J1.6
unnamed: C13.1, IC2.12 (VDD3V)
SCLK: IC2.2 (CLK), J1.4

Notes on the sheet:
Rotary Encoder

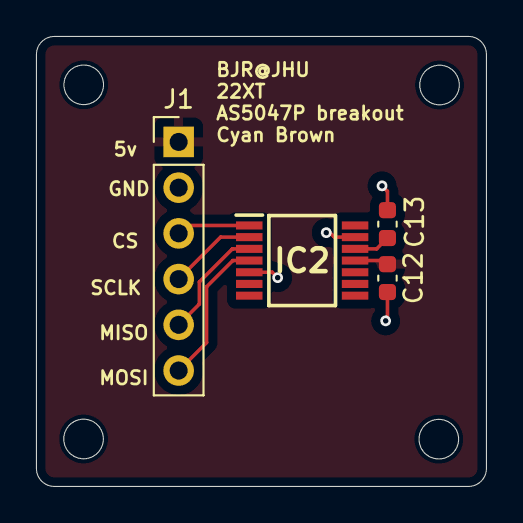
[picture p86: board as5047p-atsm_breakout.kicad_pcb from above]

Board: 2 copper layers, 25.0 x 25.0 mm, 8 parts (0 on the bottom side), 7 nets.
