BlueJayRacing/22xt_kicad/05-can_encoder/05-can_encoder.kicad_pcb

## KiCad design 05-can_encoder/05-can_encoder.kicad_pcb (2025-12-23)

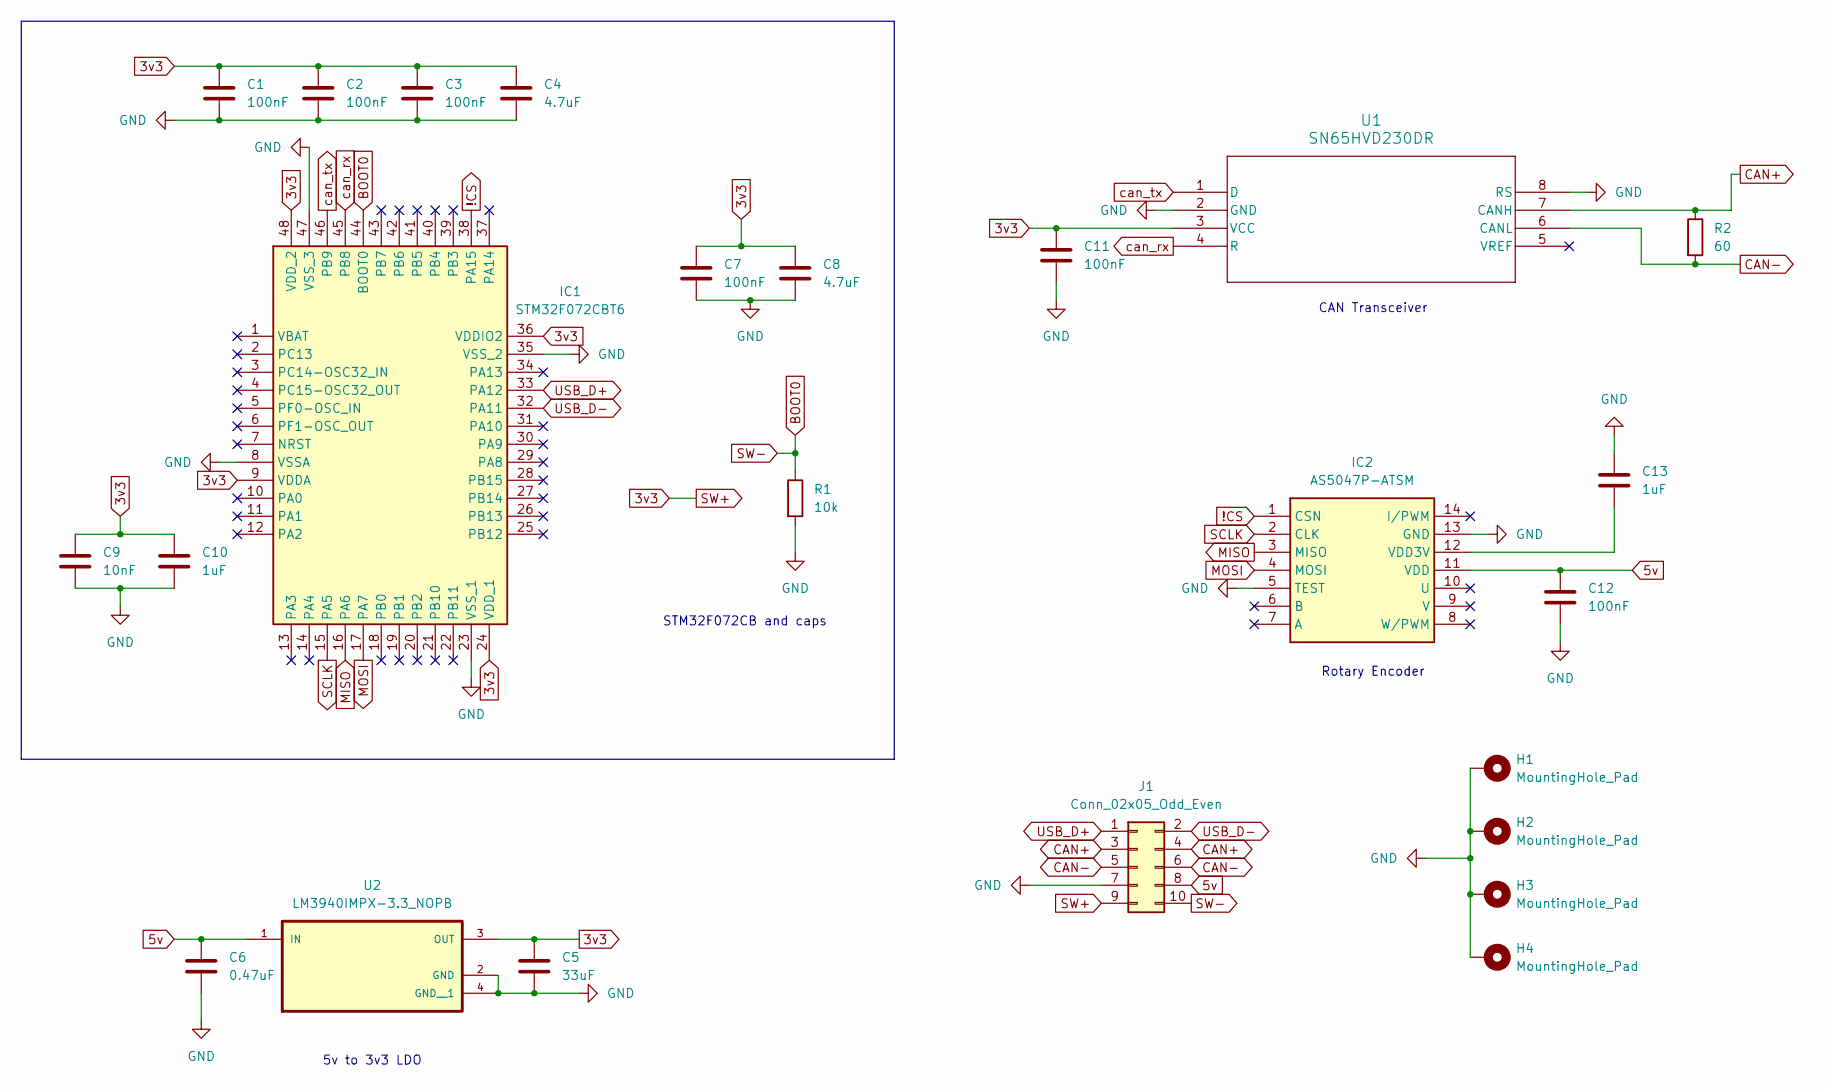
[picture p87: schematic 05-can_encoder.kicad_sch]

Parts:
C1, C2, C3, C7, C11, C12: 100nF; C_0603_1608Metric
C4, C8: 4.7uF; C_0603_1608Metric
C5: 33uF; C_0603_1608Metric
C6: 0.47uF; C_0603_1608Metric
C9: 10nF; C_0603_1608Metric
C10, C13: 1uF; C_0603_1608Metric
H1, H2, H3, H4: MountingHole_Pad; MountingHole_2.2mm_M2_DIN965_Pad
IC1: STM32F072CBT6; Mouser Part Number 511-STM32F072CBT6
IC2: AS5047P-ATSM; Mouser Part Number 985-AS5047P-ATSM
J1: Conn_02x05_Odd_Even; PinHeader_2x05_P2.54mm_Vertical
R1: 10k; R_0603_1608Metric
R2: 60; R_0603_1608Metric
U1: SN65HVD230DR
U2: LM3940IMPX-3.3_NOPB; LM3940IMPX

Connections:
3v3: C1.1, C2.1, C3.1, C4.1, C5.1, C7.1, C8.1, C9.1, C10.1, C11.1, IC1.9 (VDDA), IC1.24 (VDD_1), IC1.36 (VDDIO2), IC1.48 (VDD_2), J1.9, U1.3 (VCC), U2.3 (OUT)
5v: C6.1, C12.1, IC2.11 (VDD), J1.8, U2.1 (IN)
!CS: IC1.38 (PA15), IC2.1 (CSN)
BOOT0: IC1.44 (BOOT0), J1.10, R1.1
CAN+: J1.3, J1.4, R2.1, U1.7 (CANH)
CAN-: J1.5, J1.6, R2.2, U1.6 (CANL)
GND: C1.2, C2.2, C3.2, C4.2, C5.2, C6.2, C7.2, C8.2, C9.2, C10.2, C11.2, C12.2, C13.2, H1.1, H2.1, H3.1, H4.1, IC1.8 (VSSA), IC1.23 (VSS_1), IC1.35 (VSS_2), IC1.47 (VSS_3), IC2.5 (TEST), IC2.13 (GND), J1.7, R1.2, U1.2 (GND), U1.8 (RS), U2.2 (GND), U2.4 (GND__1)
MISO: IC1.16 (PA6), IC2.3 (MISO)
MOSI: IC1.17 (PA7), IC2.4 (MOSI)
unnamed: C13.1, IC2.12 (VDD3V)
SCLK: IC1.15 (PA5), IC2.2 (CLK)
USB_D+: IC1.33 (PA12), J1.1
USB_D-: IC1.32 (PA11), J1.2
can_rx: IC1.45 (PB8), U1.4 (R)
can_tx: IC1.46 (PB9), U1.1 (D)

Notes on the sheet:
5v to 3v3 LDO
Rotary Encoder
STM32F072CB and caps
CAN Transceiver

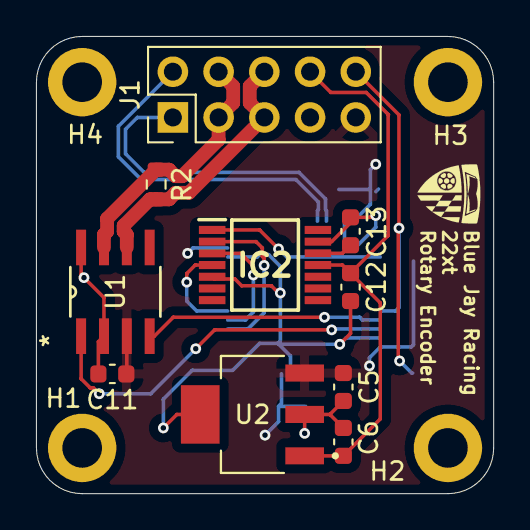
[picture p88: board 05-can_encoder.kicad_pcb from above]

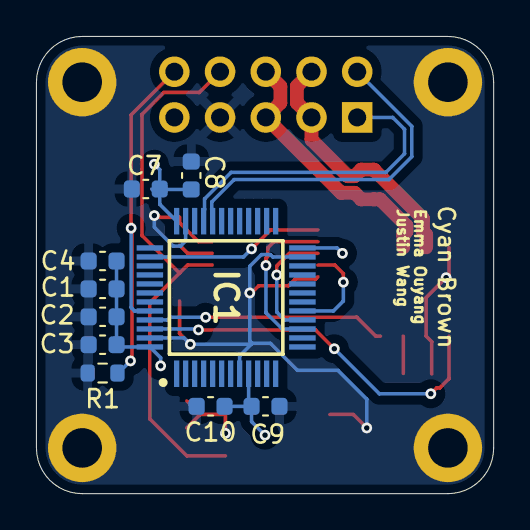
[picture p89: board 05-can_encoder.kicad_pcb from below]

Board: 2 copper layers, 25.4 x 25.4 mm, 24 parts (10 on the bottom side), 15 nets.
