BlueJayRacing/22xt_kicad/02-wsg/AD5626BRMZ-breakout/AD5626BRMZ-kent/AD5626BRMZ-kent.kicad_pcb

## KiCad design 02-wsg/AD5626BRMZ-breakout/AD5626BRMZ-kent/AD5626BRMZ-kent.kicad_pcb (2025-12-22)

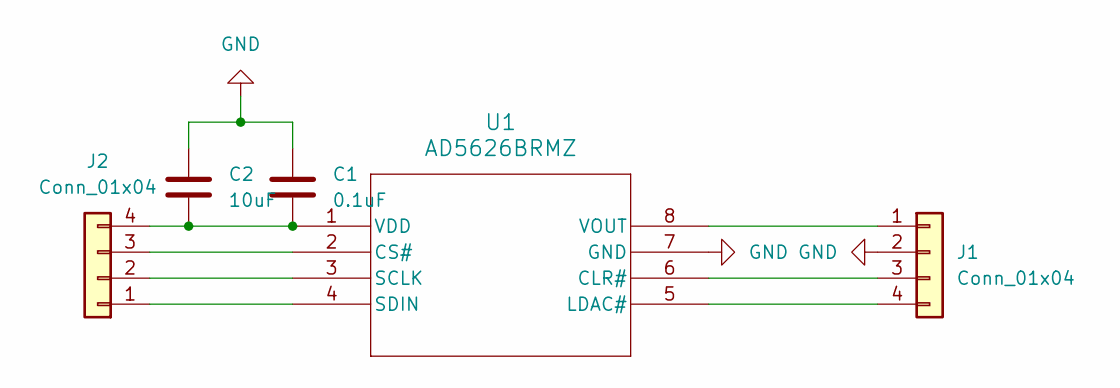
[picture p90: schematic AD5626BRMZ-kent.kicad_sch]

Parts:
C1: 0.1uF; C_0402_1005Metric
C2: 10uF; C_0603_1608Metric
J1, J2: Conn_01x04; PinHeader_1x04_P2.54mm_Vertical
U1: AD5626BRMZ; RM_8_ADI

Connections:
GND: C1.2, C2.2, J1.2, U1.7 (GND)
unnamed: J1.1, U1.8 (VOUT)
unnamed: J1.3, U1.6 (CLR#)
unnamed: J1.4, U1.5 (LDAC#)
unnamed: J2.1, U1.4 (SDIN)
unnamed: J2.2, U1.3 (SCLK)
unnamed: J2.3, U1.2 (CS#)
unnamed: C1.1, C2.1, J2.4, U1.1 (VDD)

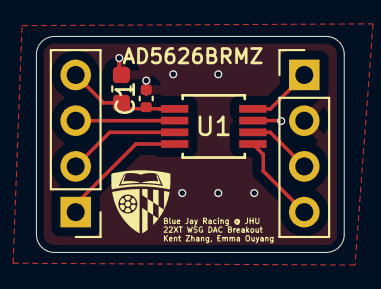
[picture p91: board AD5626BRMZ-kent.kicad_pcb from above]

Board: 2 copper layers, 17.1 x 12.0 mm, 5 parts (0 on the bottom side), 8 nets.
