BlueJayRacing/22xt_kicad/01-main_board/DB44_ Breakout/DB44_breakout.kicad_pcb

## KiCad design 01-main_board/DB44_ Breakout/DB44_breakout.kicad_pcb (2025-12-22)

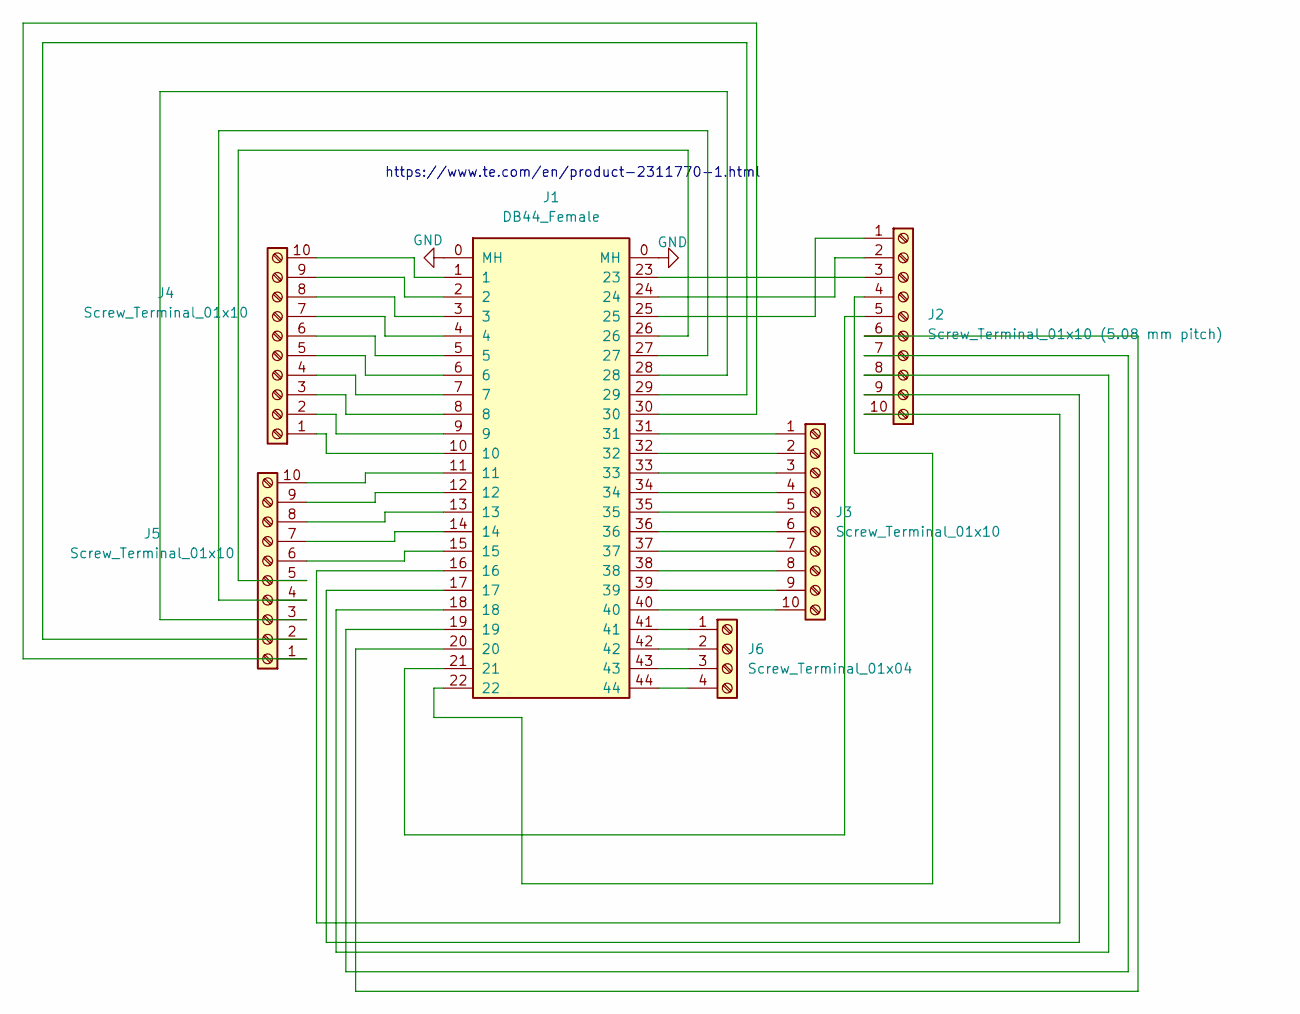
[picture p92: schematic DB44_breakout.kicad_sch]

Parts:
J1: DB44_Female; female-DB44-TE-2311770-1
J2: Screw_Terminal_01x10 (5.08 mm pitch); TerminalBlock_RND_205-00240_1x10_P5.08mm_Horizontal
J3, J4, J5: Screw_Terminal_01x10; TerminalBlock_RND_205-00240_1x10_P5.08mm_Horizontal
J6: Screw_Terminal_01x04; TerminalBlock_RND_205-00234_1x04_P5.08mm_Horizontal

Connections:
GND: J1.0 (MH)
unnamed: J1.25, J2.1
unnamed: J1.24, J2.2
unnamed: J1.23, J2.3
unnamed: J1.22, J2.4
unnamed: J1.21, J2.5
unnamed: J1.20, J2.6
unnamed: J1.19, J2.7
unnamed: J1.18, J2.8
unnamed: J1.17, J2.9
unnamed: J1.16, J2.10
unnamed: J1.31, J3.1
unnamed: J1.32, J3.2
unnamed: J1.33, J3.3
unnamed: J1.34, J3.4
unnamed: J1.35, J3.5
unnamed: J1.36, J3.6
unnamed: J1.37, J3.7
unnamed: J1.38, J3.8
unnamed: J1.39, J3.9
unnamed: J1.40, J3.10
unnamed: J1.10, J4.1
unnamed: J1.9, J4.2
unnamed: J1.8, J4.3
unnamed: J1.7, J4.4
unnamed: J1.6, J4.5
unnamed: J1.5, J4.6
unnamed: J1.4, J4.7
unnamed: J1.3, J4.8
unnamed: J1.2, J4.9
unnamed: J1.1, J4.10
unnamed: J1.30, J5.1
unnamed: J1.29, J5.2
unnamed: J1.28, J5.3
unnamed: J1.27, J5.4
unnamed: J1.26, J5.5
unnamed: J1.15, J5.6
unnamed: J1.14, J5.7
unnamed: J1.13, J5.8
unnamed: J1.12, J5.9
unnamed: J1.11, J5.10
unnamed: J1.41, J6.1
unnamed: J1.42, J6.2
unnamed: J1.43, J6.3
unnamed: J1.44, J6.4

Notes on the sheet:
https://www.te.com/en/product-2311770-1.html

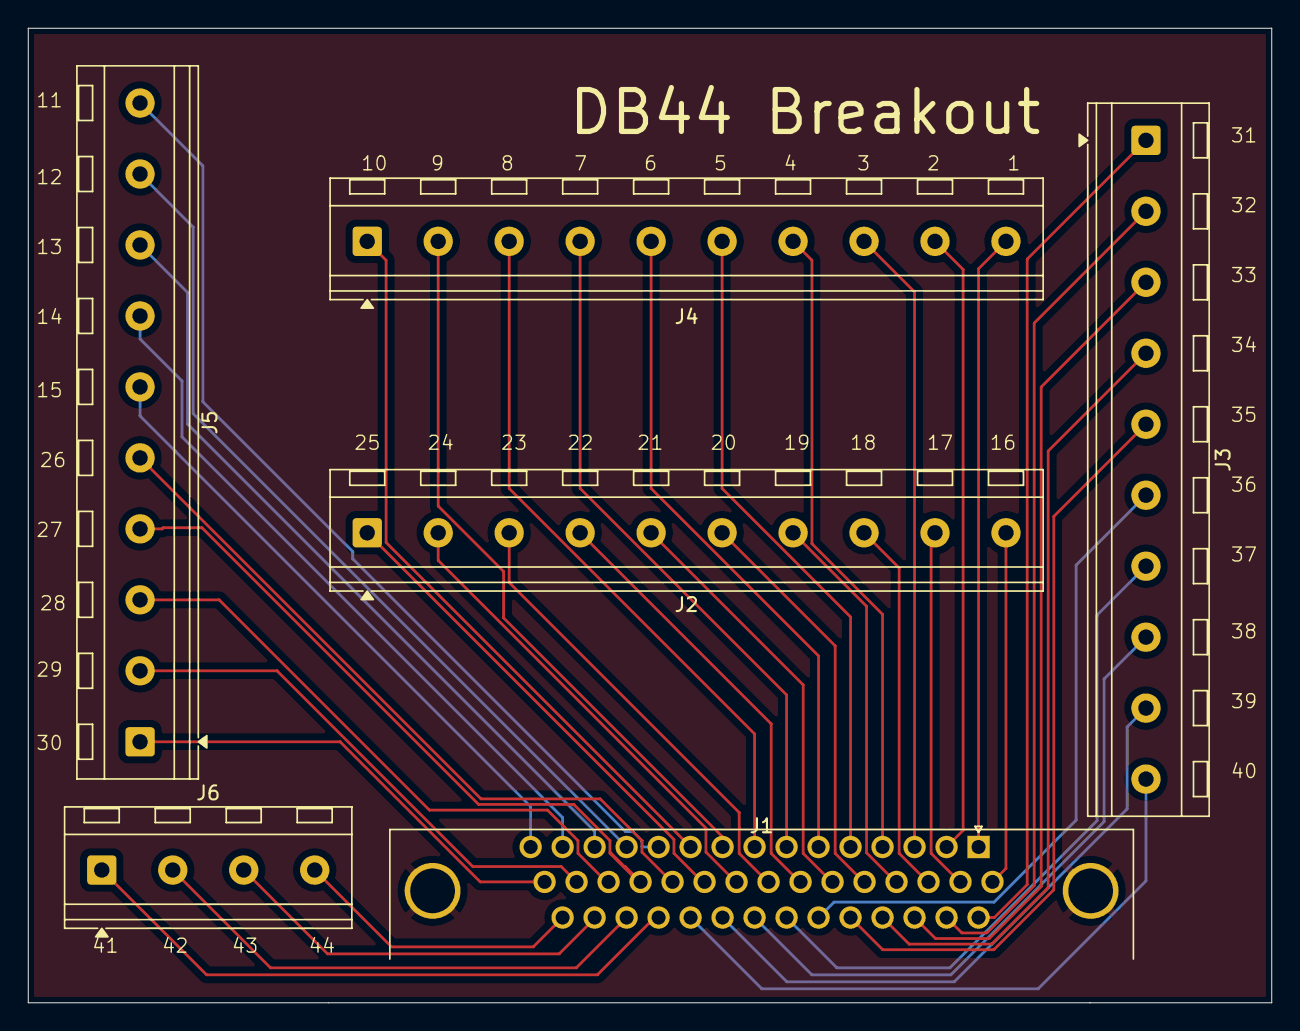
[picture p93: board DB44_breakout.kicad_pcb from above]

Board: 2 copper layers, 89.0 x 69.8 mm, 6 parts (0 on the bottom side), 44 nets.
