BlueJayRacing/22xt_kicad/02-wsg/W25Q02JVTBIM_breakout/W25Q02JVTBIM_breakout.kicad_pcb

## KiCad design 02-wsg/W25Q02JVTBIM_breakout/W25Q02JVTBIM_breakout.kicad_pcb (2025-12-21)

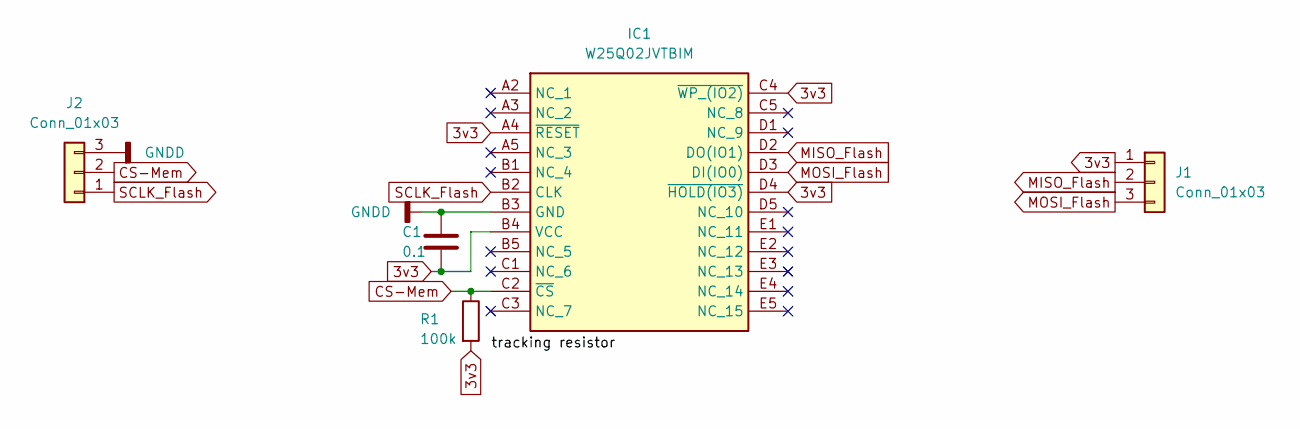
[picture p94: schematic W25Q02JVTBIM_breakout.kicad_sch]

Parts:
C1: 0.1; C_0402_1005Metric
IC1: W25Q02JVTBIM; BGA24C100P5X5_600X800X120; Mouser Part Number 454-W25Q02JVTBIM
J1, J2: Conn_01x03; PinHeader_1x03_P2.54mm_Vertical
R1: 100k; C_0402_1005Metric

Connections:
3v3: C1.2, IC1.A4 (~RESET), IC1.B4 (VCC), IC1.C4 (~WP_(IO2)), IC1.D4 (~HOLD(IO3)), J1.1, R1.2
CS-Mem: IC1.C2 (~CS), J2.2, R1.1
GNDD: C1.1, IC1.B3 (GND), J2.3
MISO_Flash: IC1.D2 (DO(IO1)), J1.2
MOSI_Flash: IC1.D3 (DI(IO0)), J1.3
SCLK_Flash: IC1.B2 (CLK), J2.1

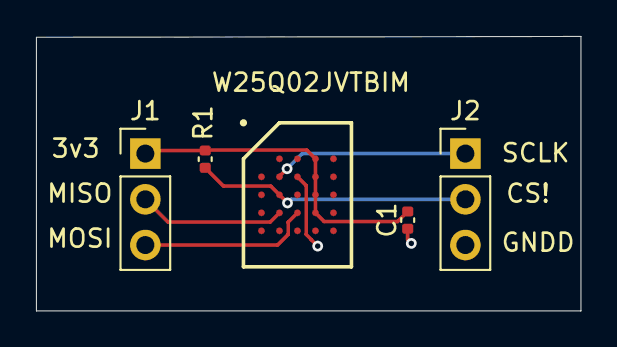
[picture p95: board W25Q02JVTBIM_breakout.kicad_pcb from above]

Board: 2 copper layers, 30.3 x 15.2 mm, 5 parts (0 on the bottom side), 6 nets.
