BlueJayRacing/22xt_kicad/04-dyno_daq/TC_shuwen/TC_shuwen.kicad_pcb

## KiCad design 04-dyno_daq/TC_shuwen/TC_shuwen.kicad_pcb (2025-12-21)

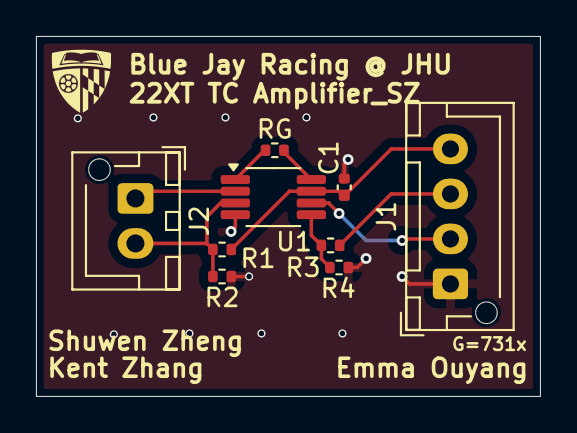
[picture p96: board TC_shuwen.kicad_pcb from above]

Board: 2 copper layers, 28.0 x 20.0 mm, 9 parts (0 on the bottom side), 9 nets.

Parts:
C1: 0.1µF; C_0402_1005Metric
J1: Conn_01x04; JST_XH_B4B-XH-AM_1x04_P2.50mm_Vertical
J2: Conn_01x02; JST_XH_B2B-XH-AM_1x02_P2.50mm_Vertical
R1, R2: 10k; R_0402_1005Metric
R3: 4.93k; R_0402_1005Metric
R4: 100; R_0402_1005Metric
RG: 137; R_0402_1005Metric
U1: INA333xxDGK; VSSOP-8_3x3mm_P0.65mm

Connections:
5v_buck: C1.2, J1.4, R1.1, U1.7 (V+)
5v_ref: J1.3, R3.1
GND: C1.1, J1.1, R2.2, R4.2, U1.4 (V-)
unnamed: RG.1, U1.1 (Rg)
unnamed: RG.2, U1.8 (Rg)
unnamed: R3.2, R4.1, U1.5 (Ref)
TC+: J2.2, R1.2, R2.1, U1.3 (+)
TC-: J2.1, U1.2 (-)
TC_AMP_OUT: J1.2, U1.6
