BlueJayRacing/22xt_kicad/04-dyno_daq/THC_su/thermistor circuit.kicad_pcb

## KiCad design 04-dyno_daq/THC_su/thermistor circuit.kicad_pcb (2025-12-20)

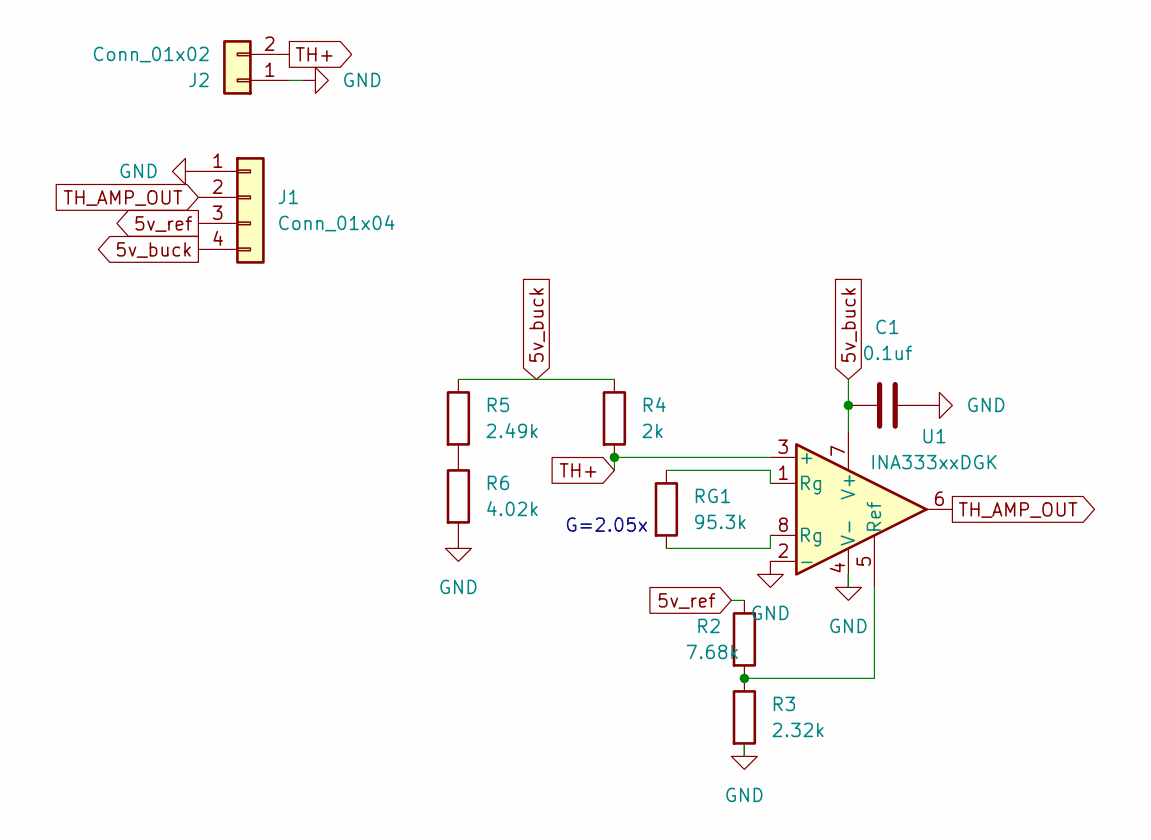
[picture p97: schematic thermistor circuit.kicad_sch]

Parts:
C1: 0.1uf; C_0402_1005Metric
J1: Conn_01x04; JST_PH_B4B-PH-SM4-TB_1x04-1MP_P2.00mm_Vertical
J2: Conn_01x02; JST_PH_B2B-PH-SM4-TB_1x02-1MP_P2.00mm_Vertical
R2: 7.68k; R_0603_1608Metric
R3: 2.32k; R_0603_1608Metric
R4: 2k; R_0603_1608Metric
R5: 2.49k; R_0603_1608Metric
R6: 4.02k; R_0603_1608Metric
RG1: 95.3k; R_0603_1608Metric
U1: INA333xxDGK; VSSOP-8_3x3mm_P0.65mm

Connections:
5v_buck: C1.1, J1.4, R4.1, R5.1, U1.7 (V+)
5v_ref: J1.3, R2.1
GND: C1.2, J1.1, J2.1, R3.2, R6.2, U1.2 (-), U1.4 (V-)
unnamed 3: RG1.1, U1.1 (Rg); also elsewhere on the board
unnamed 4: RG1.2, U1.8 (Rg); also elsewhere on the board
unnamed: R5.2, R6.1
unnamed: R2.2, R3.1, U1.5 (Ref)
TH+: J2.2, R4.2, U1.3 (+)
TH_AMP_OUT: J1.2, U1.6

Notes on the sheet:
G=2.05x

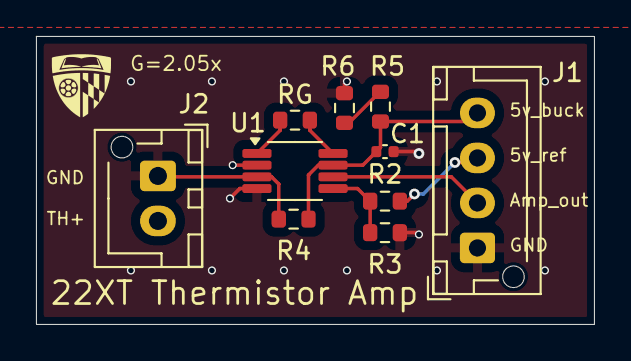
[picture p98: board thermistor circuit.kicad_pcb from above]

Board: 2 copper layers, 31.0 x 16.0 mm, 10 parts (0 on the bottom side), 9 nets.

Other parts of the board:
RG: 95.3k; R_0603_1608Metric

Their connections:
unnamed 3: RG.1; also elsewhere on the board
unnamed 4: RG.2; also elsewhere on the board
