BlueJayRacing/22xt_kicad/01-main_board/AD5689RARUZ-RL7_breakboard/AD5689RARUZ-RL7_breakboard.kicad_pcb

## KiCad design 01-main_board/AD5689RARUZ-RL7_breakboard/AD5689RARUZ-RL7_breakboard.kicad_pcb (2025-12-20)

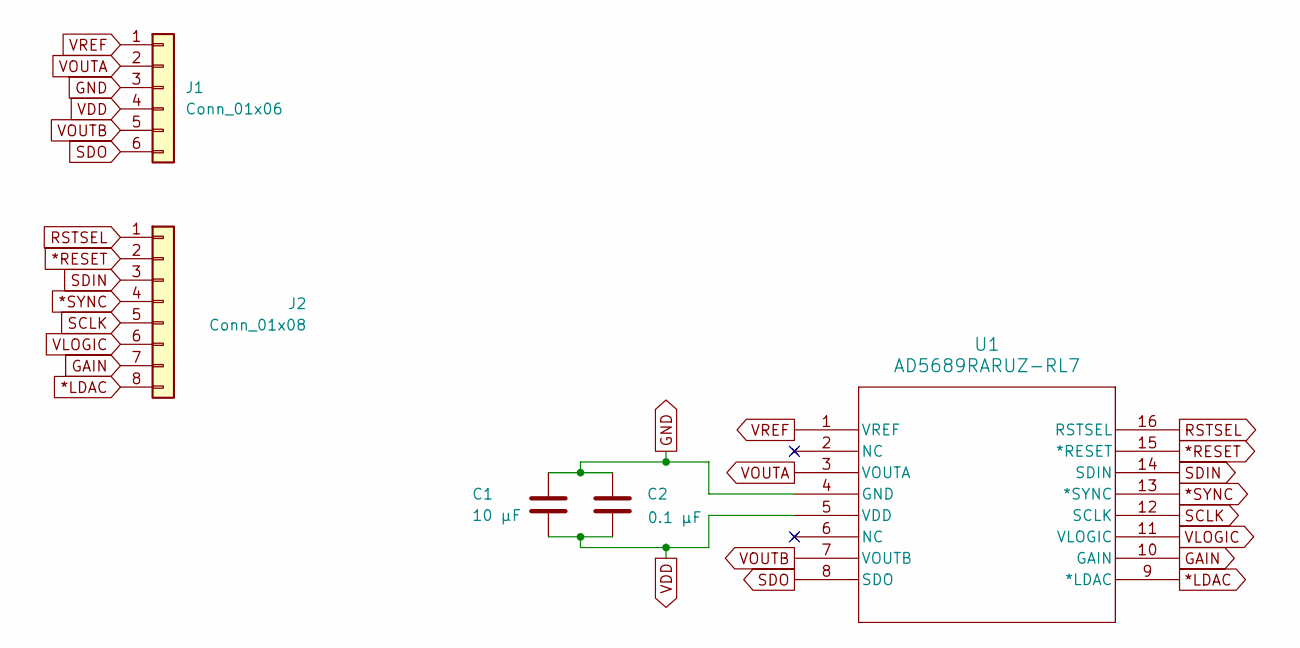
[picture p99: schematic AD5689RARUZ-RL7_breakboard.kicad_sch]

Parts:
C1: 10 μF; C_0603_1608Metric
C2: 0.1 μF; C_0201_0603Metric
J1: Conn_01x06; PinHeader_1x06_P2.54mm_Vertical
J2: Conn_01x08; PinHeader_1x08_P2.54mm_Vertical
U1: AD5689RARUZ-RL7; RU_16_ADI

Connections:
*LDAC: J2.8, U1.9 (*LDAC)
*RESET: J2.2, U1.15 (*RESET)
*SYNC: J2.4, U1.13 (*SYNC)
GAIN: J2.7, U1.10 (GAIN)
GND: C1.2, C2.2, J1.3, U1.4 (GND)
RSTSEL: J2.1, U1.16 (RSTSEL)
SCLK: J2.5, U1.12 (SCLK)
SDIN: J2.3, U1.14 (SDIN)
SDO: J1.6, U1.8 (SDO)
VDD: C1.1, C2.1, J1.4, U1.5 (VDD)
VLOGIC: J2.6, U1.11 (VLOGIC)
VOUTA: J1.2, U1.3 (VOUTA)
VOUTB: J1.5, U1.7 (VOUTB)
VREF: J1.1, U1.1 (VREF)
