BlueJayRacing/22xt_kicad/01-main_board/AD5689RARUZ-RL7_breakboard/AD5689RARUZ-RL7_breakboard.kicad_pcb

## KiCad design 01-main_board/AD5689RARUZ-RL7_breakboard/AD5689RARUZ-RL7_breakboard.kicad_pcb (continued)

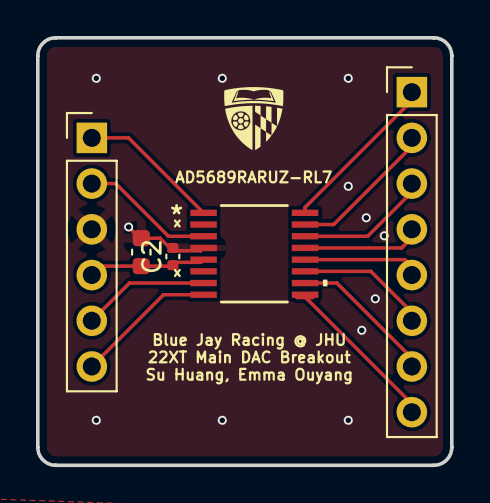
[picture p100: board AD5689RARUZ-RL7_breakboard.kicad_pcb from above]

Board: 2 copper layers, 23.0 x 23.8 mm, 5 parts (0 on the bottom side), 14 nets.
