BlueJayRacing/22xt_kicad/02-wsg/ADS1120IPWR/ADS1120IPWR.kicad_pcb

## KiCad design 02-wsg/ADS1120IPWR/ADS1120IPWR.kicad_pcb (2025-12-20)

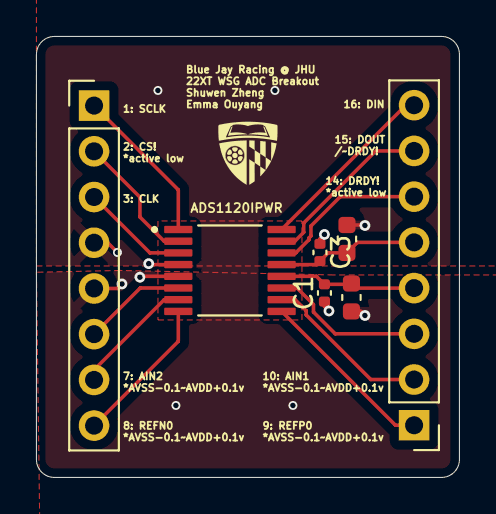
[picture p101: board ADS1120IPWR.kicad_pcb from above]

Board: 2 copper layers, 23.5 x 24.5 mm, 7 parts (0 on the bottom side), 15 nets.

Parts:
C1, C3: 0.1 μF; C_0402_1005Metric
C2, C4: 10 μF; C_0603_1608Metric
J1, J2: Conn_01x08; PinHeader_1x08_P2.54mm_Vertical
U1: ADS1120IPWR; SOP65P640X120-16N

Connections:
AIN0/REFP1: J2.3, U1.11 (AIN0/REFP1)
AIN1: J2.2, U1.10 (AIN1)
AIN2: J1.7, U1.7 (AIN2)
AIN3/REFN1: J1.6, U1.6 (AIN3/REFN1)
AVDD: C1.2, C2.1, J2.4, U1.12 (AVDD)
CLK: J1.3, U1.3 (CLK)
CS!: J1.2, U1.2 (~CS)
DIN: J2.8, U1.16 (DIN)
DOUT: J2.7, U1.15 (DOUT/~DRDY)
DRDY!: J2.6, U1.14 (~DRDY)
DVDD: C3.2, C4.1, J2.5, U1.13 (DVDD)
GND: C1.1, C2.2, C3.1, C4.2, J1.4, J1.5, U1.4 (DGND), U1.5 (AVSS)
REFN0: J1.8, U1.8 (REFN0)
REFP0: J2.1, U1.9 (REFP0)
SCLK: J1.1, U1.1 (SCLK)
