BlueJayRacing/22xt_kicad/02-wsg/esp32s3/esp32s3.kicad_pcb

## KiCad design 02-wsg/esp32s3/esp32s3.kicad_pcb (2025-12-18)

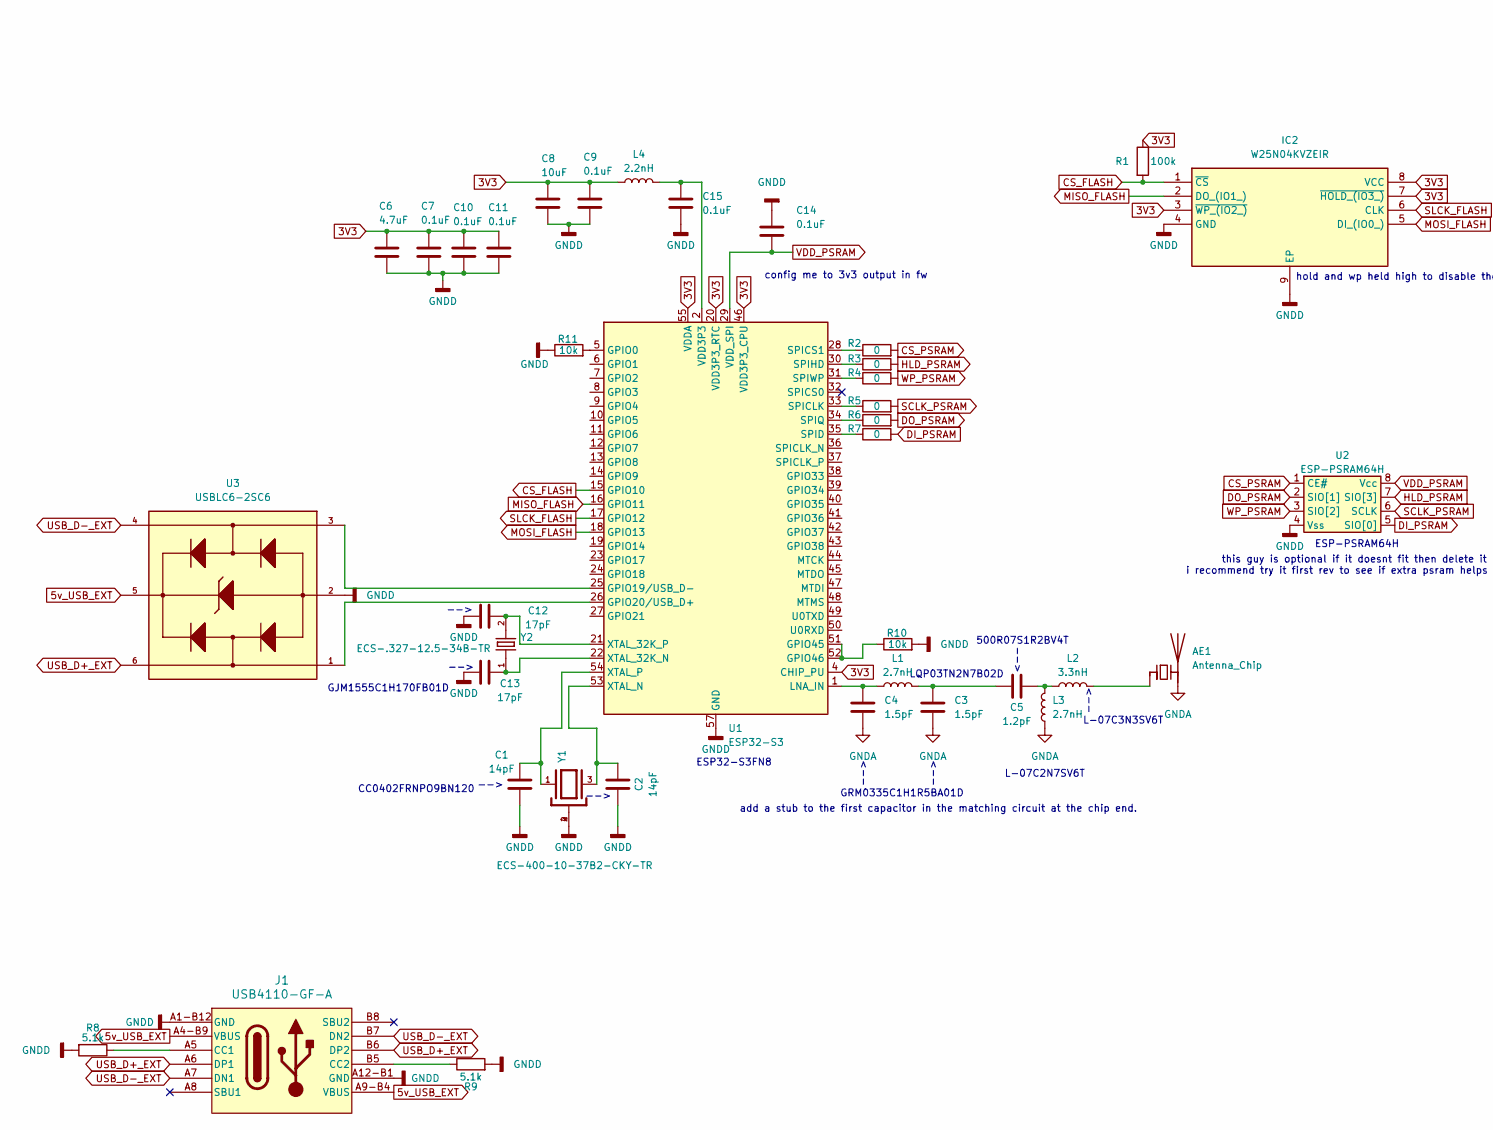
[picture p102: schematic esp32s3.kicad_sch, part in row 1, column 1]

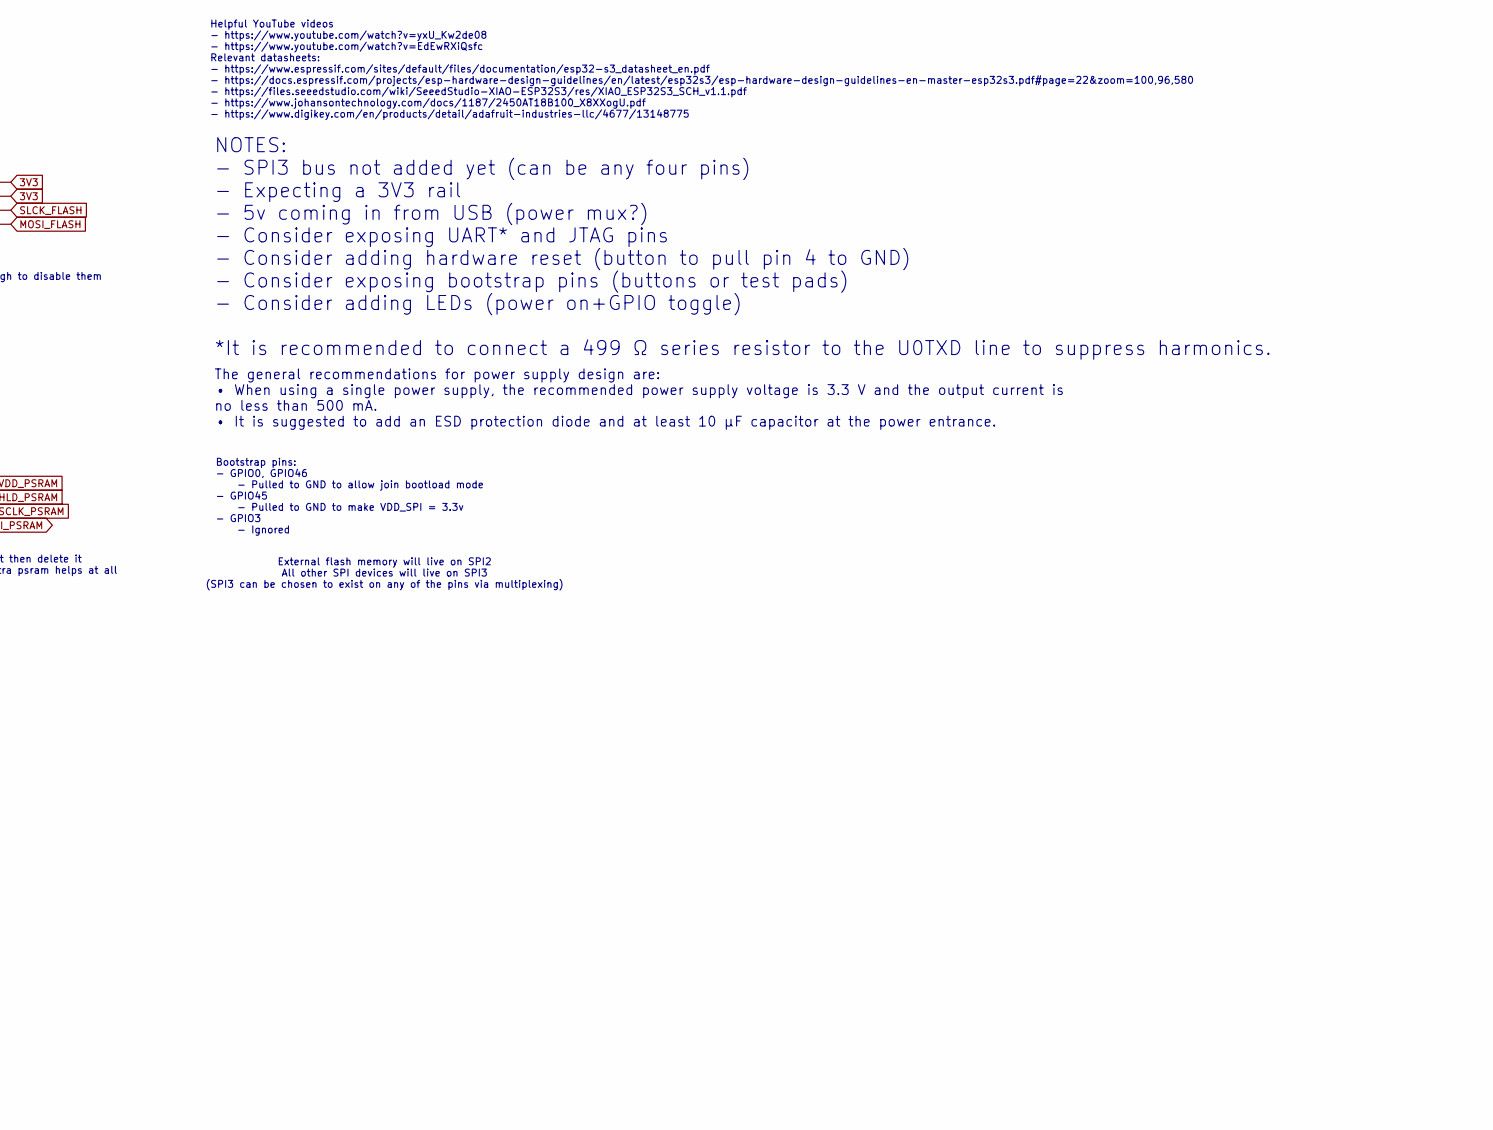
[picture p103: schematic esp32s3.kicad_sch, part in row 1, column 2]

Parts:
AE1: Antenna_Chip; XDCR_2450AT18B100E
C1, C2: 14pF; C_0402_1005Metric
C3, C4: 1.5pF; C_0201_0603Metric
C5: 1.2pF; C_0201_0603Metric
C6: 4.7uF; C_0402_1005Metric
C7, C9, C10, C11, C14, C15: 0.1uF; C_0402_1005Metric
C8: 10uF; C_0402_1005Metric
C12, C13: 17pF; C_0402_1005Metric
IC2: W25N04KVZEIR; SON127P800X600X80-9N-D; Mouser Part Number 454-W25N04KVZEIR
J1: USB4110-GF-A; USB4110-GF-A_GCT
L1: 2.7nH; L_0201_0603Metric
L2: 3.3nH; L_0402_1005Metric
L3: 2.7nH; L_0402_1005Metric
L4: 2.2nH; L_0402_1005Metric
R1: 100k; R_0402_1005Metric
R2, R3, R4, R5, R6, R7: 0; R_0402_1005Metric
R8, R9: 5.1k; R_0402_1005Metric
R10, R11: 10k; R_0402_1005Metric
U1: ESP32-S3; QFN-56-1EP_7x7mm_P0.4mm_EP4x4mm
U2: ESP-PSRAM64H; SOIC-8_3.9x4.9mm_P1.27mm
U3: USBLC6-2SC6; SOT95P280X145-6N
Y1: ECS-400-10-37B2-CKY-TR; XTAL_ECS-400-10-37B2-CKY-TR; PARTREV 2021
Y2: ECS-.327-12.5-34B-TR; XTAL_ECS-.327-12.5-34B-TR

Connections:
3V3: C6.2, C7.2, C8.2, C9.2, C10.2, C11.2, IC2.3 (~WP_(IO2_)), IC2.7 (~HOLD_(IO3_)), IC2.8 (VCC), L4.1, R1.1, U1.4 (CHIP_PU), U1.20 (VDD3P3_RTC), U1.46 (VDD3P3_CPU), U1.55 (VDDA), U1.56 (VDDA)
5v_USB_EXT: J1.A4-B9 (VBUS), J1.A9-B4 (VBUS), U3.5
CS_FLASH: IC2.1 (~CS), R1.2, U1.15 (GPIO10)
CS_PSRAM: R2.2, U2.1 (CE#)
DI_PSRAM: R7.2, U2.5 (SIO[0])
DO_PSRAM: R6.2, U2.2 (SIO[1])
GNDA: AE1.2 (PCB_Trace), C3.1, C4.1, L3.1
GNDD: C1.1, C2.2, C6.1, C7.1, C8.1, C9.1, C10.1, C11.1, C12.1, C13.2, C14.2, C15.1, IC2.4 (GND), IC2.9 (EP), J1.A1-B12 (GND), J1.A12-B1 (GND), R8.2, R9.2, R10.2, R11.1, U1.57 (GND), U2.4 (Vss), U3.2, Y1.2, Y1.4
HLD_PSRAM: R3.2, U2.7 (SIO[3])
MISO_FLASH: IC2.2 (DO_(IO1_)), U1.16 (GPIO11)
MOSI_FLASH: IC2.5 (DI_(IO0_)), U1.18 (GPIO13)
unnamed: AE1.1 (FEED), L2.2
unnamed: C3.2, C5.2, L1.2
unnamed: C5.1, L2.1, L3.2
unnamed: C15.2, L4.2, U1.2 (VDD3P3), U1.3 (VDD3P3)
unnamed: J1.A5 (CC1), R8.1
unnamed: J1.B5 (CC2), R9.1
unnamed: R10.1, U1.51 (GPIO45), U1.52 (GPIO46)
unnamed: R11.2, U1.5 (GPIO0)
unnamed: U1.25 (GPIO19/USB_D-), U3.3
unnamed: U1.26 (GPIO20/USB_D+), U3.1
unnamed: C4.2, L1.1, U1.1 (LNA_IN)
unnamed: R5.1, U1.33 (SPICLK)
unnamed: R2.1, U1.28 (SPICS1)
unnamed: R7.1, U1.35 (SPID)
unnamed: R3.1, U1.30 (SPIHD)
unnamed: R6.1, U1.34 (SPIQ)
unnamed: R4.1, U1.31 (SPIWP)
unnamed: C13.1, U1.22 (XTAL_32K_N), Y2.1
unnamed: C12.2, U1.21 (XTAL_32K_P), Y2.2
unnamed: C2.1, U1.53 (XTAL_N), Y1.3
unnamed: C1.2, U1.54 (XTAL_P), Y1.1
SCLK_PSRAM: R5.2, U2.6 (SCLK)
SLCK_FLASH: IC2.6 (CLK), U1.17 (GPIO12)
USB_D+_EXT: J1.A6 (DP1), J1.B6 (DP2), U3.6
USB_D-_EXT: J1.A7 (DN1), J1.B7 (DN2), U3.4
VDD_PSRAM: C14.1, U1.29 (VDD_SPI), U2.8 (Vcc)
WP_PSRAM: R4.2, U2.3 (SIO[2])

Notes on the sheet:
Helpful YouTube videos - https://www.youtube.com/watch?v=yxU_Kw2de08 - https://www.youtube.com/watch?v=EdEwRXiQsfc Relevant datasheets: - https://www.espressif.com/sites/default/files/documentation/esp32-s3_datasheet_en.pdf - https://docs.espressif.com/projects/esp-hardware-design-guidelines/en/lat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
this guy is optional if it doesnt fit then delete it i recommend try it first rev to see if extra psram helps at all
-->
hold and wp held high to disable them
NOTES: - SPI3 bus not added yet (can be any four pins) - Expecting a 3V3 rail - 5v coming in from USB (power mux?) - Consider exposing UART* and JTAG pins - Consider adding hardware reset (button to pull pin 4 to GND) - Consider exposing bootstrap pins (buttons or test pads) - Consider adding LEDs 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
L-07C2N7SV6T
config me to 3v3 output in fw
add a stub to the first capacitor in the matching circuit at the chip end.
ESP-PSRAM64H
The general recommendations for power supply design are: • When using a single power supply, the recommended power supply voltage is 3.3 V and the output current is no less than 500 mA. • It is suggested to add an ESD protection diode and at least 10 μF capacitor at the power entrance.
500R07S1R2BV4T
L-07C3N3SV6T
External flash memory will live on SPI2 All other SPI devices will live on SPI3 (SPI3 can be chosen to exist on any of the pins via multiplexing)
LQP03TN2N7B02D
GJM1555C1H170FB01D
ESP32-S3FN8
CC0402FRNPO9BN120
<--
Bootstrap pins: - GPIO0, GPIO46 - Pulled to GND to allow join bootload mode - GPIO45 - Pulled to GND to make VDD_SPI = 3.3v - GPIO3 - Ignored
GRM0335C1H1R5BA01D

Board: 2 copper layers, 36 parts (0 on the bottom side), 36 nets, no tracks yet.
