BlueJayRacing/22xt_kicad/01-main_board/main_board_peripheral_v1/main_board_peripheral_v1.kicad_pcb

## KiCad design 01-main_board/main_board_peripheral_v1/main_board_peripheral_v1.kicad_pcb (2025-11-25, an earlier design)

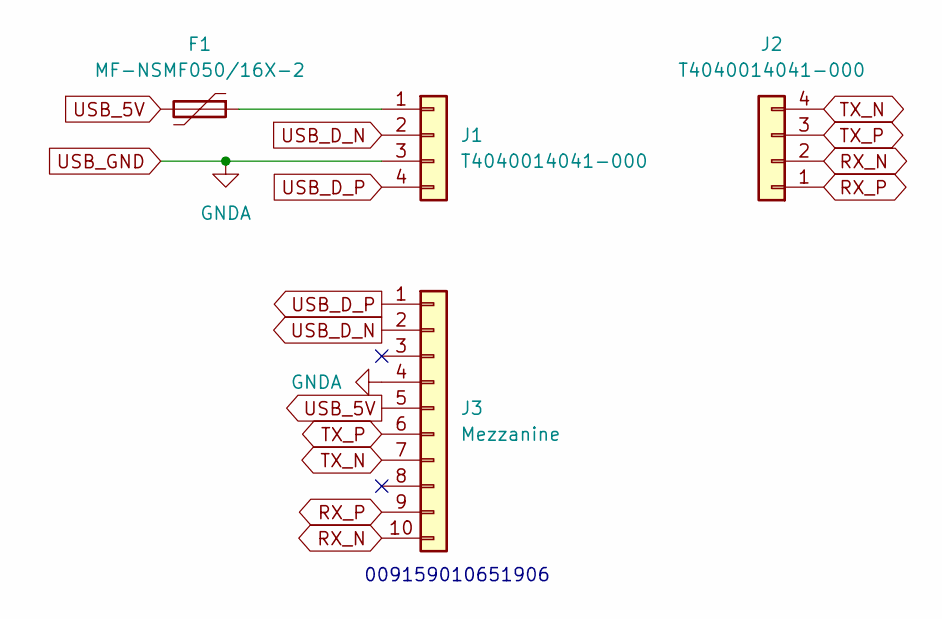
[picture p104: schematic main_board_peripheral_v1.kicad_sch]

Parts:
F1: MF-NSMF050/16X-2; MFNSMF05016X2
J1: T4040014041-000; T4041017041000
J2: T4040014041-000; T4040014041000
J3: Mezzanine; Double Sided Mezzanine Card Edge_Connector Side

Connections:
unnamed: F1.1, J1.1
RX_N: J2.2, J3.10
RX_P: J2.1, J3.9
TX_N: J2.4, J3.7
TX_P: J2.3, J3.6
USB_5V: F1.2, J3.5
USB_D_N: J1.2, J3.2
USB_D_P: J1.4, J3.1
USB_GND: J1.3, J3.4

Notes on the sheet:
009159010651906

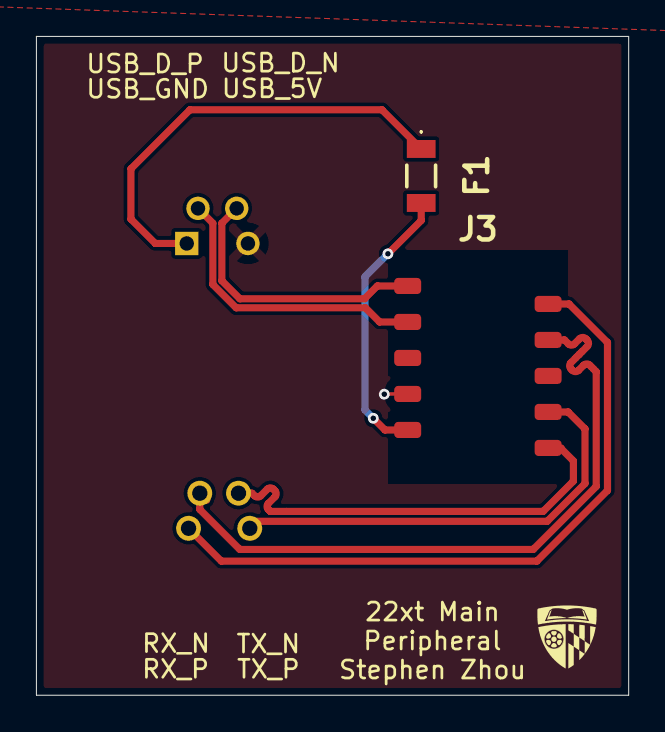
[picture p105: board main_board_peripheral_v1.kicad_pcb from above]

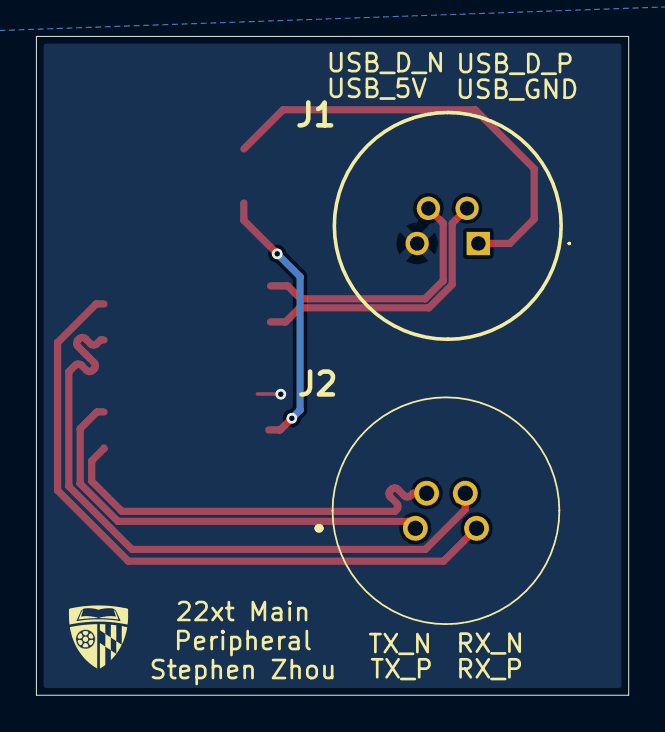
[picture p106: board main_board_peripheral_v1.kicad_pcb from below]

Board: 2 copper layers, 32.9 x 36.6 mm, 4 parts (2 on the bottom side), 9 nets.
