BlueJayRacing/22xt_kicad/(commit log)

2025-07-27 re-uploaded pre-pdr 1 main board to new branch w corrected format
    [analog_processing.kicad_sch, digital_processing.kicad_sch, main_board_v1.kicad_pcb, main_board_v1.kicad_sch, power.kicad_sch, sg_processing.kicad_sch, teensy.kicad_sch]
2025-07-28 switched mag inputs to SCL and SDA, added bulk capacitors to buck input of power switch
    [digital_processing.kicad_sch, main_board_v1.kicad_sch, power.kicad_sch, teensy.kicad_sch]
2025-07-31 switched 5V buck/switching regulator to an LDO more to spec
    [power.kicad_sch]
2025-07-31 switched level shifter one w smaller dimensions and less inputs
    [digital_processing.kicad_sch, main_board_v1.kicad_sch, sg_processing.kicad_sch]
2025-07-31 fixed/set all resistors to standard values
    [analog_processing.kicad_sch, digital_processing.kicad_sch, main_board_v1.kicad_sch, power.kicad_sch, sg_processing.kicad_sch, teensy.kicad_sch]
2025-08-05 partial schem revision with initial feedback
    [MSE_16_ADI.stl]
2025-08-06 addressed misc changes on review notes gdoc
    [analog_processing.kicad_sch, digital_processing.kicad_sch, main_board_v1.kicad_sch, power.kicad_sch, sg_processing.kicad_sch]
2025-08-08 added tvs diode for ethernet and more naming convention fixes
    [digital_processing.kicad_sch, sg_processing.kicad_sch, teensy.kicad_sch]
2025-08-11 added/changed footprints to 402s and solderable packages
    [analog_processing.kicad_sch, digital_processing.kicad_sch, power.kicad_sch, sg_processing.kicad_sch, teensy.kicad_sch]
2025-08-11 added optional offset to the nyquist filters for testing later
    [analog_processing.kicad_sch]
2025-08-12 fixed footprint/symbol conflicts
    [digital_processing.kicad_sch, main_board_v1.kicad_pcb, main_board_v1.kicad_sch, power.kicad_sch]
2025-08-14 finalized schematic, ran ERC (confused by some errors), and attempted to start layout (no footprints are showing up in pcb editor?)
    [main_board_v1.kicad_pcb, main_board_v1.kicad_sch]
2025-08-30 matched connector schematic to pinout
    [analog_processing.kicad_sch, digital_processing.kicad_sch, main_board_v1.kicad_pcb, main_board_v1.kicad_sch, teensy.kicad_sch]
2025-08-30 assigned footprint to picoflex and matched to pinout
    [main_board_v1.kicad_sch]
2025-08-30 added spark plug digital input
    [digital_processing.kicad_sch, main_board_v1.kicad_sch, power.kicad_sch, teensy.kicad_sch]
2025-08-30 grouped externals/ics on layout
    [analog_processing.kicad_sch, digital_processing.kicad_sch, main_board_v1.kicad_pcb, teensy.kicad_sch]
2025-08-30 reorganized layout into 65x85mm space
    [main_board_v1.kicad_pcb, power.kicad_sch]
2025-08-30 added tolerances for gain and sg resistors
    [sg_processing.kicad_sch]
2025-09-04 changed sg resistors to 352 ohms
    [esp32s3.kicad_sch, main_board_v1.kicad_pcb, main_board_v1.kicad_sch, sg_processing.kicad_sch]
2025-09-05 added alternate level shifter pathways
    [digital_processing.kicad_sch, esp32s3.kicad_sch, sg_processing.kicad_sch]
2025-09-05 altered ethernet layout
    [digital_processing.kicad_sch, esp32s3.kicad_sch, main_board_v1.kicad_pcb]
2025-09-06 progress on gnda and gndd planes
    [main_board_v1.kicad_pcb]
2025-09-06 finished analog input traces
    [analog_processing.kicad_sch, digital_processing.kicad_sch, esp32s3.kicad_sch, main_board_v1.kicad_pcb, main_board_v1.kicad_sch, power.kicad_sch, sg_processing.kicad_sch]
2025-09-07 progress on digital input traces
    [main_board_v1.kicad_pcb, main_board_v1.kicad_sch]
2025-09-07 finished digital input traces
    [main_board_v1.kicad_pcb]
2025-09-07 finished ethernet traces
    [main_board_v1.kicad_pcb]
2025-09-07 added dac and adc spi traces
    [main_board_v1.kicad_pcb]
2025-09-12 finished traces, esp32s3 schematic, and added gnd planes
    [esp32s3.kicad_sch, main_board_v1.kicad_pcb]
2025-09-12 filled in gnd zones
    [main_board_v1.kicad_pcb]
2025-10-06 added 3D models
    [749013011.stp, CP-40-14_ADI.step, ESP32-S3--3DModel-STEP-510211.STEP, INA827AIDGK.step, L78M05ABDT-TR.step, LP5907MFX-2.5_NOPB.step, LSF0108PWR.STEP, MAX6105EUR_T.step]
2025-10-08 resolved all non-GND related DRC issues in layout
    [main_board_v1.kicad_pcb, power.kicad_sch, sg_processing.kicad_sch]
2025-10-10 start esp32s3 thing
    [ECS-400-10-37B2-CKY-TR.step, esp32s3.kicad_pcb, esp32s3.kicad_sch]
2025-10-16 added 2nd 11.1V and added B- pins
    [main_board_v1.kicad_sch]
2025-10-17 attempted to fix gnd plane, updated vias
    [ESP32S3.kicad_pcb, ESP32S3.kicad_sch, digital_processing.kicad_sch, main_board_v1.kicad_pcb]
2025-10-18 fixed silkscreen overlaps
    [main_board_v1.kicad_pcb]
2025-10-18 updated db44 footprint, length matched sg traces
    [781-M44-113R141.STEP, main_board_v1.kicad_pcb, main_board_v1.kicad_sch]
2025-10-19 esp32s3 integration done
    [2450AT18B100E.step, ECS-.327-12.5-34B-TR.step, USBLC6-2SC6.step, W25N04KVZEIR.stp, esp32s3.kicad_pcb, esp32s3.kicad_sch, usb4110-gf-a_revb.step]
2025-10-20 changed 5V ldo to 5V buck
    [TPS62173DSGT.stp, main_board_v1.kicad_pcb, main_board_v1.kicad_sch, power.kicad_sch, teensy.kicad_sch]
2025-10-22 made progress on gnd and power planes, finished length matching ethernet
    [esp32s3.kicad_sch, main_board_v1.kicad_pcb, teensy.kicad_sch]
2025-10-24 finished gnd plane, power planes, spi updates
    [main_board_v1.kicad_pcb, sg_processing.kicad_sch, teensy.kicad_sch]
2025-10-24 added spi and 5V test flags
    [analog_processing.kicad_sch, esp32s3.kicad_sch, main_board_v1.kicad_pcb]
2025-10-25 new wsg schem - not complete
    [DAC.kicad_sch, battery_module.kicad_sch, flash_memory.kicad_sch, in_amp.kicad_sch, power.kicad_sch, temp_new_wsg.kicad_sch, untitled.kicad_sch, wsg.kicad_sch]
2025-10-26 Emma revision
    [analog_processing.kicad_sch, main_board_v1.kicad_pcb, main_board_v1.kicad_sch, power.kicad_sch, sg_processing.kicad_sch, teensy.kicad_sch]
2025-10-26 Added main board footprint library
    [analog_processing.kicad_sch, digital_processing.kicad_sch, esp32s3.kicad_sch, main_board_v1.kicad_sch, power.kicad_sch, sg_processing.kicad_sch, teensy.kicad_sch]
2025-10-26 Editing schematic
    [esp32s3.kicad_sch]
2025-10-26 Added new commit
    [power.kicad_sch]
2025-10-26 Re-assigned all footprints
    [analog_processing.kicad_sch, digital_processing.kicad_sch, esp32s3.kicad_sch, power.kicad_sch, sg_processing.kicad_sch, teensy.kicad_sch]
2025-10-27 Updated layout from schematic
    [main_board_v1.kicad_pcb]
2025-10-27 made layout changes and re-length matched ethernet + sg liens
    [esp32s3.kicad_sch, main_board_v1.kicad_pcb]
2025-10-27 Changed molex footprint
    [main_board_v1.kicad_pcb, main_board_v1.kicad_sch]
2025-10-27 Re-doing layout
    [digital_processing.kicad_sch, esp32s3.kicad_sch, main_board_v1.kicad_pcb]
2025-10-28 Finished layout
    [main_board_peripheral_v1-B_Cu.gbl, main_board_peripheral_v1-B_Mask.gbs, main_board_peripheral_v1-B_Paste.gbp, main_board_peripheral_v1-B_Silkscreen.gbo, main_board_peripheral_v1-Edge_Cuts.gm1, main_board_peripheral_v1-F_Cu.gtl, main_board_peripheral_v1-F_Mask.gts, main_board_peripheral_v1-F_Paste.gtp]
2025-10-28 Redid usb ethernet diff pairing
    [main_board_peripheral_v1-B_Cu.gbl, main_board_peripheral_v1-B_Mask.gbs, main_board_peripheral_v1-B_Paste.gbp, main_board_peripheral_v1-B_Silkscreen.gbo, main_board_peripheral_v1-Edge_Cuts.gm1, main_board_peripheral_v1-F_Cu.gtl, main_board_peripheral_v1-F_Mask.gts, main_board_peripheral_v1-F_Paste.gtp]
2025-10-28 new transformer layout + progress on new gnd planes
    [digital_processing.kicad_sch, main_board_v1.kicad_pcb, main_board_v1.kicad_sch]
2025-10-28 Working on ESP32 & Antenna Layout
    [main_board_v1.kicad_pcb]
2025-10-28 added supply test flags, gnd planes, fixed silkscreen overlaps
    [analog_processing.kicad_sch, esp32s3.kicad_sch, main_board_v1.kicad_pcb, main_board_v1.kicad_sch, power.kicad_sch]
2025-10-29 Modified ethernet routing
    [main_board_v1.kicad_pcb]
2025-10-29 Added mezzanine edge connector
    [main_board_v1.kicad_pcb, main_board_v1.kicad_sch, power.kicad_sch, teensy.kicad_sch]
2025-10-29 Updating mezz edge
    [digital_processing.kicad_sch, main_board_v1.kicad_pcb, main_board_v1.kicad_sch]
2025-10-29 Added 3d models to 3d model folder
    [T4041017041-000.stp, c-t4040014041-000-a-3d.stp, mezzanine 10.stp, mezzanine.stp]
2025-10-29 Increasing power trace width
    [main_board_v1.kicad_pcb]
2025-10-29 Working on antenna layout
    [main_board_v1.kicad_pcb]
2025-10-29 Added more GND plane rule out zones
    [main_board_v1.kicad_pcb]
2025-10-30 need to switch branches
    [ESP32_flash.kicad_sch, WSG_2.0.kicad_pcb, WSG_2.0.kicad_sch, WSG_ADC.kicad_sch, esp32s3.kicad_sch, untitled.kicad_sch]
2025-10-30 Resaving file
    [main_board_peripheral_v1.kicad_pcb]
2025-10-30 addressed important drc errors/warnings and added net tie near remaining gnd plane separation
    [main_board_v1.kicad_pcb, main_board_v1.kicad_sch]
2025-10-31 Almost done, just grounding layout
    [esp32s3.kicad_sch, main_board_v1.kicad_pcb]
2025-10-31 Updated PCB from schematic for antenna with NC end
    [main_board_v1.kicad_pcb]
2025-11-01 added decoupling caps for esp32s3 and resolved drc errors
    [esp32s3.kicad_sch, main_board_v1.kicad_pcb, main_board_v1.kicad_sch, teensy.kicad_sch]
2025-11-01 Generated BOM
    [main_board_v1.csv]
2025-11-01 finalized bom, cli, gerber files
    [main_board_v1-B_Cu.gbl, main_board_v1-B_Mask.gbs, main_board_v1-B_Paste.gbp, main_board_v1-B_Silkscreen.gbo, main_board_v1-Edge_Cuts.gm1, main_board_v1-F_Cu.gtl, main_board_v1-F_Mask.gts, main_board_v1-F_Paste.gtp]
2025-11-03 Began changing vias
    [main_board_v1.kicad_pcb]
2025-11-03 Created mofied bom & cpl
    [main_board_v1-B_Cu.gbl, main_board_v1-B_Mask.gbs, main_board_v1-B_Paste.gbp, main_board_v1-B_Silkscreen.gbo, main_board_v1-Edge_Cuts.gm1, main_board_v1-F_Cu.gtl, main_board_v1-F_Mask.gts, main_board_v1-F_Paste.gtp]
2025-11-03 Re-generated final gerbers
    [main_board_v1-B_Cu.gbl, main_board_v1-B_Mask.gbs, main_board_v1-B_Paste.gbp, main_board_v1-B_Silkscreen.gbo, main_board_v1-Edge_Cuts.gm1, main_board_v1-F_Cu.gtl, main_board_v1-F_Mask.gts, main_board_v1-F_Paste.gtp]
2025-11-04 updated bom and cpl to appease jlc
    [main_board_v1.csv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]
2025-11-04 shuwen setup
    [TC_shuwen.kicad_pcb, TC_shuwen.kicad_sch]
2025-11-04 Added BJR Logo to footprints folder
2025-11-04 added BJR logo and text
    [TC_shuwen.kicad_pcb]
2025-11-05 added 3D models for JST connectors
    [B2B-PH-SM4-TB.STEP, B4B-PH-SM4-TB.STEP, TC_shuwen.kicad_pcb]
2025-11-07 added gerber files
    [TC_shuwen-B_Cu.gbr, TC_shuwen-B_Mask.gbr, TC_shuwen-B_Paste.gbr, TC_shuwen-B_Silkscreen.gbr, TC_shuwen-Edge_Cuts.gbr, TC_shuwen-F_Cu.gbr, TC_shuwen-F_Mask.gbr, TC_shuwen-F_Paste.gbr]
2025-11-11 Kent's thermocouple PCB || added 1 connector 3d model, had issue with other connector's 3d model || haven't created gerber files yet || incorrect footprint for a part?
    [B4B-PH-SM4-TB.STEP, S4B-XH-SM4-TB.STEP, TC_kent.kicad_pcb, TC_kent.kicad_sch, jst_2pin.STEP]
2025-11-14 Add thermistor gerber files
2025-11-14 changed jst connector
    [TC_shuwen-B_Cu.gbl, TC_shuwen-B_Mask.gbs, TC_shuwen-B_Paste.gbp, TC_shuwen-B_Silkscreen.gbo, TC_shuwen-Edge_Cuts.gm1, TC_shuwen-F_Cu.gtl, TC_shuwen-F_Mask.gbr, TC_shuwen-F_Mask.gts]
2025-11-14 fixed jst fotprints || added gerber files
    [TC_kent-B_Cu.gbl, TC_kent-B_Mask.gbs, TC_kent-B_Paste.gbp, TC_kent-B_Silkscreen.gbo, TC_kent-Edge_Cuts.gm1, TC_kent-F_Cu.gtl, TC_kent-F_Mask.gts, TC_kent-F_Paste.gtp]
2025-11-25 Cleaned up v1 branch
    [main_board_v1-B_Cu.gbl, main_board_v1-B_Mask.gbs, main_board_v1-B_Paste.gbp, main_board_v1-B_Silkscreen.gbo, main_board_v1-Edge_Cuts.gm1, main_board_v1-F_Cu.gtl, main_board_v1-F_Mask.gts, main_board_v1-F_Paste.gtp]
2025-11-25 changed 5v_ref, updated db44, reset pcb layout
    [REF3450IDBVR.stp, analog_processing.kicad_sch, digital_processing.kicad_sch, esp32s3.kicad_sch, main_board_v1.csv, main_board_v2.kicad_pcb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]
2025-11-27 added usb mux
    [TS3USB30EDGSR.stp, esp32s3.kicad_sch, teensy.kicad_sch]
2025-12-05 created folder
    [AD5689RARUZ-RL7_breakboard.kicad_pcb, AD5689RARUZ-RL7_breakboard.kicad_sch]
2025-12-05 imported footprint
2025-12-05 adding adc footprint
    [ADS1120IPWR.kicad_pcb, ADS1120IPWR.kicad_sch, ADS1120IPWR.step, RVA0016A.stl]
2025-12-05 need to check labels and requirements again
    [AD5626BRMZ-kent.kicad_pcb, AD5626BRMZ-kent.kicad_sch]
2025-12-06 updated breakout
    [AD5689RARUZ-RL7_breakboard.kicad_pcb, AD5689RARUZ-RL7_breakboard.kicad_sch]
2025-12-12 adc initial schematic
    [ADS1120IPWR.kicad_pcb, ADS1120IPWR.kicad_sch]
2025-12-12 updated breakout board
    [AD5689RARUZ-RL7_breakboard.kicad_pcb, AD5689RARUZ-RL7_breakboard.kicad_sch]
2025-12-12 generated gerber files
    [AD5689RARUZ-RL7_breakboard-B_Cu.gbl, AD5689RARUZ-RL7_breakboard-B_Mask.gbs, AD5689RARUZ-RL7_breakboard-B_Paste.gbp, AD5689RARUZ-RL7_breakboard-B_Silkscreen.gbo, AD5689RARUZ-RL7_breakboard-Edge_Cuts.gm1, AD5689RARUZ-RL7_breakboard-F_Cu.gtl, AD5689RARUZ-RL7_breakboard-F_Mask.gts, AD5689RARUZ-RL7_breakboard-F_Paste.gtp]
2025-12-13 fixed github issue
    [WSG_ADC.kicad_sch, untitled.kicad_sch]
2025-12-13 New esp32
    [ESP32_flash.kicad_sch]
2025-12-13 Added new esp32 schematic
    [WSG_ADC.kicad_sch, untitled.kicad_sch]
2025-12-13 review finished
    [ESP32_flash.kicad_sch, WSG_ADC.kicad_sch, untitled.kicad_sch]
2025-12-13 updated board
    [ADS1120IPWR.kicad_pcb, ADS1120IPWR.kicad_sch]
2025-12-14 updated breakout size
    [AD5689RARUZ-RL7_breakboard-B_Cu.gbl, AD5689RARUZ-RL7_breakboard-B_Mask.gbs, AD5689RARUZ-RL7_breakboard-B_Paste.gbp, AD5689RARUZ-RL7_breakboard-B_Silkscreen.gbo, AD5689RARUZ-RL7_breakboard-Edge_Cuts.gm1, AD5689RARUZ-RL7_breakboard-F_Cu.gtl, AD5689RARUZ-RL7_breakboard-F_Mask.gts, AD5689RARUZ-RL7_breakboard-F_Paste.gtp]
2025-12-14 updated gerber files
    [AD5689RARUZ-RL7_breakboard-B_Cu.gbl, AD5689RARUZ-RL7_breakboard-B_Mask.gbs, AD5689RARUZ-RL7_breakboard-B_Paste.gbp, AD5689RARUZ-RL7_breakboard-B_Silkscreen.gbo, AD5689RARUZ-RL7_breakboard-Edge_Cuts.gm1, AD5689RARUZ-RL7_breakboard-F_Cu.gtl, AD5689RARUZ-RL7_breakboard-F_Mask.gts, AD5689RARUZ-RL7_breakboard-F_Paste.gtp]
2025-12-14 made pins breadboard-compatible, aligned capacitors, shrunk overall board size
    [AD5626BRMZ-kent.kicad_pcb]
2025-12-14 swapped ground fill zone to back copper layer
    [AD5626BRMZ-kent.kicad_pcb]
2025-12-18 modified tc shuwen dimensions
    [TC_shuwen-B_Cu.gbl, TC_shuwen-B_Silkscreen.gbo, TC_shuwen-Edge_Cuts.gm1, TC_shuwen-F_Cu.gtl, TC_shuwen-F_Mask.gts, TC_shuwen-F_Paste.gtp, TC_shuwen-F_Silkscreen.gto, TC_shuwen-NPTH-drl_map.gbr]
2025-12-18 Changed kent tc flag directions
    [TC_kent.kicad_pcb, TC_kent.kicad_sch]
2025-12-18 Merged WSG DAC breakout branch
    [AD5626BRMZ-kent-B_Cu.gbl, AD5626BRMZ-kent-B_Mask.gbs, AD5626BRMZ-kent-B_Paste.gbp, AD5626BRMZ-kent-B_Silkscreen.gbo, AD5626BRMZ-kent-Edge_Cuts.gm1, AD5626BRMZ-kent-F_Cu.gtl, AD5626BRMZ-kent-F_Mask.gts, AD5626BRMZ-kent-F_Paste.gtp]
2025-12-19 started on layout
    [ESP32_flash.kicad_sch, WSG_2.0.kicad_pcb, WSG_ADC.kicad_sch, untitled.kicad_sch]
2025-12-19 Changed WSG ADC breakout board size
    [ADS1120IPWR-B_Cu.gbl, ADS1120IPWR-B_Mask.gbs, ADS1120IPWR-B_Paste.gbp, ADS1120IPWR-B_Silkscreen.gbo, ADS1120IPWR-Edge_Cuts.gm1, ADS1120IPWR-F_Cu.gtl, ADS1120IPWR-F_Mask.gts, ADS1120IPWR-F_Paste.gtp]
2025-12-19 Checked and added via stitching
    [AD5689RARUZ-RL7_breakboard-B_Cu.gbl, AD5689RARUZ-RL7_breakboard-B_Mask.gbs, AD5689RARUZ-RL7_breakboard-B_Paste.gbp, AD5689RARUZ-RL7_breakboard-B_Silkscreen.gbo, AD5689RARUZ-RL7_breakboard-Edge_Cuts.gm1, AD5689RARUZ-RL7_breakboard-F_Cu.gtl, AD5689RARUZ-RL7_breakboard-F_Mask.gts, AD5689RARUZ-RL7_breakboard-F_Paste.gtp]
2025-12-19 changed 0201 to 0402 capacitor
    [AD5689RARUZ-RL7_breakboard-B_Cu.gbl, AD5689RARUZ-RL7_breakboard-B_Mask.gbs, AD5689RARUZ-RL7_breakboard-B_Paste.gbp, AD5689RARUZ-RL7_breakboard-B_Silkscreen.gbo, AD5689RARUZ-RL7_breakboard-Edge_Cuts.gm1, AD5689RARUZ-RL7_breakboard-F_Cu.gtl, AD5689RARUZ-RL7_breakboard-F_Mask.gts, AD5689RARUZ-RL7_breakboard-F_Paste.gtp]
2025-12-20 thc kicad files
    [thermistor circuit.kicad_pcb, thermistor circuit.kicad_sch, thermistor circuit.step]
2025-12-20 Added second ground plane to ADS1120 breakout
    [ADS1120IPWR-B_Cu.gbl, ADS1120IPWR-B_Mask.gbs, ADS1120IPWR-B_Paste.gbp, ADS1120IPWR-B_Silkscreen.gbo, ADS1120IPWR-Edge_Cuts.gm1, ADS1120IPWR-F_Cu.gtl, ADS1120IPWR-F_Mask.gts, ADS1120IPWR-F_Paste.gtp]
2025-12-20 Added additionally ground pour to wsg dac & added thermal relief to gnd net
    [AD5626BRMZ-kent-B_Cu.gbl, AD5626BRMZ-kent-B_Mask.gbs, AD5626BRMZ-kent-B_Paste.gbp, AD5626BRMZ-kent-B_Silkscreen.gbo, AD5626BRMZ-kent-Edge_Cuts.gm1, AD5626BRMZ-kent-F_Cu.gtl, AD5626BRMZ-kent-F_Mask.gts, AD5626BRMZ-kent-F_Paste.gtp]
2025-12-20 for main dac added thermal relief to gnd net
    [AD5689RARUZ-RL7_breakboard-B_Cu.gbl, AD5689RARUZ-RL7_breakboard-B_Mask.gbs, AD5689RARUZ-RL7_breakboard-B_Paste.gbp, AD5689RARUZ-RL7_breakboard-B_Silkscreen.gbo, AD5689RARUZ-RL7_breakboard-Edge_Cuts.gm1, AD5689RARUZ-RL7_breakboard-F_Cu.gtl, AD5689RARUZ-RL7_breakboard-F_Mask.gts, AD5689RARUZ-RL7_breakboard-F_Paste.gtp]
2025-12-20 removed gnd island
    [AD5689RARUZ-RL7_breakboard-B_Cu.gbl, AD5689RARUZ-RL7_breakboard-B_Mask.gbs, AD5689RARUZ-RL7_breakboard-B_Paste.gbp, AD5689RARUZ-RL7_breakboard-B_Silkscreen.gbo, AD5689RARUZ-RL7_breakboard-Edge_Cuts.gm1, AD5689RARUZ-RL7_breakboard-F_Cu.gtl, AD5689RARUZ-RL7_breakboard-F_Mask.gts, AD5689RARUZ-RL7_breakboard-F_Paste.gtp]
2025-12-20 Updated grounding for temp pcbs
    [TC_kent-B_Cu.gbl, TC_kent-B_Mask.gbs, TC_kent-B_Paste.gbp, TC_kent-B_Silkscreen.gbo, TC_kent-Edge_Cuts.gm1, TC_kent-F_Cu.gtl, TC_kent-F_Mask.gts, TC_kent-F_Paste.gtp]
2025-12-20 Add DB44 breakout KiCad project
    [Untitled.kicad_pcb, Untitled.kicad_sch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]
2025-12-20 made progress on layout
    [analog_processing.kicad_sch, digital_processing.kicad_sch, main_board_v2.kicad_pcb, main_board_v2.kicad_sch, power.kicad_sch, teensy.kicad_sch]
2025-12-20 more layout changes
    [ESP32_flash.kicad_sch, WSG_2.0.kicad_pcb, WSG_ADC.kicad_sch, untitled.kicad_sch]
2025-12-21 changed buck converter, finished ground + power plane layout
    [LT3973EMSE-5#PBF.stp, main_board_v2.kicad_pcb, main_board_v2.kicad_sch, power.kicad_sch, teensy.kicad_sch]
2025-12-21 more layout progress
    [ESP32_flash.kicad_sch, WSG_2.0.kicad_pcb, WSG_ADC.kicad_sch, untitled.kicad_sch]
2025-12-21 Add DB44 breakout board design
    [DB44_breakout.kicad_pcb, DB44_breakout.kicad_sch]
2025-12-21 schematic nearly done
    [05-can_encoder.kicad_pcb, 05-can_encoder.kicad_sch]
2025-12-21 Added silkscreen descriptor text + kent's name to TC shuwen
    [TC_shuwen-B_Cu.gbl, TC_shuwen-B_Cu.gbr, TC_shuwen-B_Mask.gbr, TC_shuwen-B_Mask.gbs, TC_shuwen-B_Paste.gbp, TC_shuwen-B_Paste.gbr, TC_shuwen-B_Silkscreen.gbo, TC_shuwen-B_Silkscreen.gbr]
2025-12-21 Finished DB44 board edits
    [DB44_breakout-B_Cu.gbl, DB44_breakout-B_Mask.gbs, DB44_breakout-B_Paste.gbp, DB44_breakout-B_Silkscreen.gbo, DB44_breakout-Edge_Cuts.gm1, DB44_breakout-F_Cu.gtl, DB44_breakout-F_Mask.gts, DB44_breakout-F_Paste.gtp]
2025-12-22 corrected female DB44 footprint
    [DB44_breakout-B_Cu.gbl, DB44_breakout-B_Mask.gbs, DB44_breakout-B_Paste.gbp, DB44_breakout-B_Silkscreen.gbo, DB44_breakout-Edge_Cuts.gm1, DB44_breakout-F_Cu.gtl, DB44_breakout-F_Mask.gts, DB44_breakout-F_Paste.gtp]
2025-12-22 fixed zone
    [WSG_2.0.kicad_pcb]
2025-12-22 Unfinished Version 2 of the Main Peripheral Board
    [main_board_peripheral_v2.kicad_pcb, main_board_peripheral_v2.kicad_sch]
2025-12-22 finished sensor input layout and some spi bus
    [esp32s3.kicad_sch, main_board_v2.kicad_pcb, main_board_v2.kicad_sch, power.kicad_sch]
2025-12-22 Changed a cap to 0402
    [AD5626BRMZ-kent-B_Cu.gbl, AD5626BRMZ-kent-B_Mask.gbs, AD5626BRMZ-kent-B_Paste.gbp, AD5626BRMZ-kent-B_Silkscreen.gbo, AD5626BRMZ-kent-Edge_Cuts.gm1, AD5626BRMZ-kent-F_Cu.gtl, AD5626BRMZ-kent-F_Mask.gts, AD5626BRMZ-kent-F_Paste.gtp]
2025-12-22 layout draft
    [05-can_encoder.kicad_pcb, 05-can_encoder.kicad_sch]
2025-12-22 condensed board size, routed ethernet, finalized non esp32 and non mezzanine related connections
    [esp32s3.kicad_sch, main_board_v2.kicad_pcb]
2025-12-22 wip layout diff pair
    [05-can_encoder.kicad_pcb, 05-can_encoder.kicad_sch]
2025-12-22 layout fixes
    [05-can_encoder.kicad_pcb, 05-can_encoder.kicad_sch]
2025-12-22 stm32f072cb breakout
    [05-can_encoder.kicad_pcb, stm32f072cb_breakout.kicad_pcb, stm32f072cb_breakout.kicad_sch]
2025-12-22 wip as5047p breakout
    [as5047p-atsm_breakout.kicad_pcb, as5047p-atsm_breakout.kicad_sch]
2025-12-22 Added new buttons for schmitt trigger
    [KSC253J_SP_DELTA_LFG.stp, NL37WZ14USG.step, buttons.kicad_sch, main_board_peripheral_v2.kicad_pcb, main_board_peripheral_v2.kicad_sch]
2025-12-23 finished layout, resolved drc errors, need to resolve warnings and get checked
    [esp32s3.kicad_sch, main_board_v2.kicad_pcb, main_board_v2.kicad_sch]
2025-12-23 Finished silkscreen
    [main_board_peripheral_v2.kicad_pcb, main_board_peripheral_v2.kicad_sch]
2025-12-23 resolved silkscreen issues, tied gpio45 to gnd
    [DF12NB-20DS-0.5V_51_.stp, esp32s3.kicad_sch, main_board_v2.kicad_pcb]
2025-12-23 dimensions finalized
    [main_board_v2.kicad_pcb]
2025-12-23 stm and encoder breakout done/ordered
    [as5047p-atsm_breakout-B_Cu.gbr, as5047p-atsm_breakout-B_Mask.gbr, as5047p-atsm_breakout-B_Paste.gbr, as5047p-atsm_breakout-B_Silkscreen.gbr, as5047p-atsm_breakout-Edge_Cuts.gbr, as5047p-atsm_breakout-F_Cu.gbr, as5047p-atsm_breakout-F_Mask.gbr, as5047p-atsm_breakout-F_Paste.gbr]
2025-12-23 added gpio3 tp
    [esp32s3.kicad_sch, main_board_v2.kicad_pcb]
2025-12-23 changed inductor
    [main_board_v2.kicad_pcb, power.kicad_sch]
2025-12-23 finished for review
    [ESP32_flash.kicad_sch, WSG_2.0.kicad_pcb, WSG_ADC.kicad_sch, untitled.kicad_sch]
2025-12-23 fixed schematic and connected layout
    [main_board_peripheral_v2.kicad_pcb, main_board_peripheral_v2.kicad_sch]
2025-12-23 Finished preliminary routing
    [esp32s3.kicad_sch, main_board_v2.kicad_pcb, main_board_v2.kicad_sch, teensy.kicad_sch]
2025-12-23 fixed DRC errors
    [main_board_v2.kicad_pcb]
2025-12-23 Added lithium charger and fixed unconnected items
    [BQ21040DBVR.stp, WSG_2.0.kicad_pcb, untitled.kicad_sch]
2025-12-23 layout done
    [main_board_peripheral_v2.kicad_sch]
2025-12-23 Generated bom & cpl files
    [main_board_v1-top-pos_mod.xlsx, main_board_v1_bom_mod.xlsx, main_board_v2.csv, main_board_v2.kicad_pcb, main_board_v2.xls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]
2025-12-23 Uploaded gerber files for peripheral
    [main_board_peripheral_v2-B_Cu.gbl, main_board_peripheral_v2-B_Mask.gbs, main_board_peripheral_v2-B_Paste.gbp, main_board_peripheral_v2-B_Silkscreen.gbo, main_board_peripheral_v2-Edge_Cuts.gm1, main_board_peripheral_v2-F_Cu.gtl, main_board_peripheral_v2-F_Mask.gts, main_board_peripheral_v2-F_Paste.gtp]
2025-12-23 silkscreen fixes
    [WSG_2.0.kicad_pcb]
2025-12-24 finished board first rev
    [ESP32_flash.kicad_sch, WSG_2.0.kicad_pcb, bom.csv, designators.csv, positions.csv]
2026-01-04 Updated 3d models and exported 3d form
    [main_board_v2.kicad_pcb]
2026-01-04 Updated and added 3d models, generated 3d export
    [DF12NB(5.0)-20DP-0.5V(51).STEP, NEOPIXEL5050-COM-24837.stp, main_board_peripheral_v2.kicad_pcb, main_board_peripheral_v2.step]
2026-01-04 Re-generated 3d export
    [DF12NB-20DS-0.5V.stp, DF12NB-20DS-0.5V_51_.stp, DF12NB-20DS-0.5V_51_combined.stp, main_board_v2.kicad_pcb]
2026-01-31 updated schematic to address discussed design changes
    [analog_processing.kicad_sch, digital_processing.kicad_sch, esp32s3.kicad_sch, main_board_v1-top-pos_mod.xlsx, main_board_v1_bom_mod.xlsx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]
2026-02-01 arranged layout fully, traces almost done, planes wip
    [analog_processing.kicad_sch, main_board_v3.kicad_pcb, main_board_v3.kicad_sch, power.kicad_sch, teensy.kicad_sch]
2026-02-05 added high speed signal gnd plane, updated fpc connectors
    [main_board_v3.kicad_pcb, main_board_v3.kicad_sch, power.kicad_sch]
2026-02-06 changed fpc connector footprint, which messed up spacing so have to redo a lot of layout
    [esp32s3.kicad_sch, main_board_v3.kicad_pcb, main_board_v3.kicad_sch]
2026-02-07 fixed board to use horizontal fpc connectors, length matched all diff pairs + cleaned up layout
    [main_board_v3.kicad_pcb, main_board_v3.kicad_sch]
2026-02-07 finalized mounting hole placement and dimensions. finished
    [main_board_v3.kicad_pcb]
2026-02-08 changed peripheral connector, addressed slack revisions
    [FH41-15S-0.5SH_05_.stp, main_board_v3.kicad_pcb, main_board_v3.kicad_sch, sg_processing.kicad_sch, teensy.kicad_sch]
2026-02-08 finished silkscreen + 3D models
    [IND_TAIYO_NRS4012_TAY.step, LSM115JE3_TR13--3DModel-STEP-510211.STEP, XIAO-ESP32S3 v2.step, analog_processing.kicad_sch, main_board_v3.kicad_pcb, main_board_v3.kicad_sch, sg_processing.kicad_sch]
2026-02-08 updated paths
    [main_board_v3.kicad_pcb]
2026-02-08 updated 3d models
    [main_board_v3.kicad_pcb, sg_processing.kicad_sch]
2026-02-08 fixed paths
    [MAX6105EUR-T.step, SOIC8-N_MC_MCH.step, main_board_v3.kicad_pcb]
2026-02-09 changed xiao orientation
    [main_board_v3.kicad_pcb]
2026-02-09 generated bom and cpl files
    [BOM-main_board_v3.csv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]
2026-02-09 Push to change computers. New schematic.
    [buttons.kicad_sch, main_board_peripheral_v2.kicad_pcb, main_board_peripheral_v2.kicad_sch]
2026-02-09 editing main board silkscreen
    [main_board_v3.kicad_pcb]
2026-02-09 exported main board v3
    [main_board_v1-top-pos_mod.xlsx, main_board_v1_bom_mod.xlsx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]
2026-02-09 Started new layout on version 3
    [buttons.kicad_sch, main_board_peripheral_v2.kicad_pcb, main_board_peripheral_v2.kicad_sch]
2026-02-09 moved down peripheral ffc connector by > 5 mm
    [main_board_v3.kicad_pcb, main_board_v3.kicad_sch]
2026-02-09 generated new gerbers + bom + cpl files
    [BOM-main_board_v3.csv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]
2026-02-10 Editing silkscreen
    [main_board_v3.kicad_pcb, main_board_v3.kicad_sch]
2026-02-10 re-did gerbers
    [main_board_v2-bottom-pos.csv, main_board_v2-top-pos.csv, main_board_v2-top-pos.xls, main_board_v3-B_Cu.gbl, main_board_v3-B_Mask.gbs, main_board_v3-B_Paste.gbp, main_board_v3-B_Silkscreen.gbo, main_board_v3-Edge_Cuts.gm1]
2026-02-10 Completed draft of main peripheral v3
    [buttons.kicad_sch, main_board_peripheral_v3.kicad_pcb, main_board_peripheral_v3.kicad_sch]
2026-02-10 Completed main peripheral edits
    [main_board_peripheral_v3.kicad_pcb, main_board_peripheral_v3.kicad_sch]
2026-02-10 edited main peripheral rev 3 layout
    [main_board_peripheral_v3.kicad_pcb]
2026-02-10 Re-generated gerbers
    [main_board_peripheral_v3-B_Cu.gbl, main_board_peripheral_v3-B_Mask.gbs, main_board_peripheral_v3-B_Paste.gbp, main_board_peripheral_v3-B_Silkscreen.gbo, main_board_peripheral_v3-Edge_Cuts.gm1, main_board_peripheral_v3-F_Cu.gtl, main_board_peripheral_v3-F_Mask.gts, main_board_peripheral_v3-F_Paste.gtp]
2026-02-27 Re-exported peripheral v3 3d model
    [main_board_peripheral_v3.step]
2026-03-13 updated peripheral v3.1
    [MYRBP500080W21RD.step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]
2026-03-13 added dimensions to m8
    [main_board_peripheral_v3_1-B_Cu.gbl, main_board_peripheral_v3_1-B_Mask.gbs, main_board_peripheral_v3_1-B_Paste.gbp, main_board_peripheral_v3_1-B_Silkscreen.gbo, main_board_peripheral_v3_1-Edge_Cuts.gm1, main_board_peripheral_v3_1-F_Cu.gtl, main_board_peripheral_v3_1-F_Mask.gts, main_board_peripheral_v3_1-F_Paste.gtp]
2026-03-13 added gerbers
2026-03-13 exported jlcpcb files
    [BOM-main_board_peripheral_v3_1.csv, BOM-main_board_peripheral_v3_1.xlsx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]
2026-04-06 created a new project
    [power-board.kicad_pcb, power-board.kicad_sch]
2026-04-09 done with inputs, working on power conversion
    [power-board.kicad_sch]
2026-04-16 finished 1st version of schematic
    [power-board.kicad_sch]
